TomSawyerLabs/mcu-hil/reference/v1-import/pcb-netlist.txt

== FOOTPRINTS ==
 |  |  | layer=Top Layer
   props: {'Reference': '', 'Value': '', 'Datasheet': '', 'Description': ''}
    =
 |  |  | layer=Top Layer
   props: {'Reference': '', 'Value': '', 'Datasheet': '', 'Description': ''}
    =
 |  |  | layer=Top Layer
   props: {'Reference': '', 'Value': '', 'Datasheet': '', 'Description': ''}
    =
 |  |  | layer=Top Layer
   props: {'Reference': '', 'Value': '', 'Datasheet': '', 'Description': ''}
    =
C1 | Capacitor 10 uF +/- 10% 16 V 0805 | Vault:CAPC2013X135X45NL10T25 | layer=Bottom Layer
   props: {'Reference': 'C1', 'Value': 'Capacitor 10 uF +/- 10% 16 V 0805', 'Datasheet': '', 'Description': ''}
    1=5V 2=GND
C2 | Capacitor 100 nF +/-10% 50 V 0603 | Vault:CAPC1608X90X40NL10T20 | layer=Bottom Layer
   props: {'Reference': 'C2', 'Value': 'Capacitor 100 nF +/-10% 50 V 0603', 'Datasheet': '', 'Description': ''}
    1=GND 2=VCC
C3 | Capacitor 100 nF +/-10% 50 V 0603 | Vault:CAPC1608X90X40NL10T20 | layer=Bottom Layer
   props: {'Reference': 'C3', 'Value': 'Capacitor 100 nF +/-10% 50 V 0603', 'Datasheet': '', 'Description': ''}
    1=GND 2=UVCC
C4 | Capacitor 1uF +/- 10% 16V 0603 | Vault:CAPC1608X90X35ML15T15 | layer=Bottom Layer
   props: {'Reference': 'C4', 'Value': 'Capacitor 1uF +/- 10% 16V 0603', 'Datasheet': '', 'Description': ''}
    1=NetC4_1 2=GND
C5 | Capacitor 12pF +/-10% 50V 0402 | Vault:CAPC0402(1005)33_L | layer=Bottom Layer
   props: {'Reference': 'C5', 'Value': 'Capacitor 12pF +/-10% 50V 0402', 'Datasheet': '', 'Description': ''}
    1=GND 2=NetC5_2
C6 | Capacitor 12pF +/-10% 50V 0402 | Vault:CAPC0402(1005)33_L | layer=Bottom Layer
   props: {'Reference': 'C6', 'Value': 'Capacitor 12pF +/-10% 50V 0402', 'Datasheet': '', 'Description': ''}
    1=GND 2=AVR Clock
C7 | Capacitor 100 nF +/-10% 50 V 0603 | Vault:CAPC1608X90X40NL10T20 | layer=Bottom Layer
   props: {'Reference': 'C7', 'Value': 'Capacitor 100 nF +/-10% 50 V 0603', 'Datasheet': '', 'Description': ''}
    1=GND 2=3V3
C8 | Capacitor 100 nF +/-10% 50 V 0603 | Vault:CAPC1608X90X40NL10T20 | layer=Bottom Layer
   props: {'Reference': 'C8', 'Value': 'Capacitor 100 nF +/-10% 50 V 0603', 'Datasheet': '', 'Description': ''}
    1=GND 2=3V3
C9 | Capacitor 100 nF +/-10% 50 V 0603 | Vault:CAPC1608X90X40NL10T20 | layer=Bottom Layer
   props: {'Reference': 'C9', 'Value': 'Capacitor 100 nF +/-10% 50 V 0603', 'Datasheet': '', 'Description': ''}
    1=GND 2=5V
D1 | LTST-C230KFKT | Vault:LEDC3216X110 | layer=Bottom Layer
   props: {'Reference': 'D1', 'Value': 'LTST-C230KFKT', 'Datasheet': '', 'Description': ''}
    A=3V3 C=NetD1_C
D2 | LTST-C230KFKT | Vault:LEDC3216X110 | layer=Bottom Layer
   props: {'Reference': 'D2', 'Value': 'LTST-C230KFKT', 'Datasheet': '', 'Description': ''}
    A=3V3 C=NetD2_C
D3 | LTST-C230KFKT | Vault:LEDC3216X110 | layer=Bottom Layer
   props: {'Reference': 'D3', 'Value': 'LTST-C230KFKT', 'Datasheet': '', 'Description': ''}
    A=GPIO26 C=NetD3_C
D4 | LTST-C230KFKT | Vault:LEDC3216X110 | layer=Bottom Layer
   props: {'Reference': 'D4', 'Value': 'LTST-C230KFKT', 'Datasheet': '', 'Description': ''}
    A=AVR Activity C=NetD4_C
J1 | Harwin M20-7832046 | PCB-677180-1:PCB-677180-1 | layer=Bottom Layer
   props: {'Reference': 'J1', 'Value': 'Harwin M20-7832046', 'Datasheet': '', 'Description': ''}
    1=3V3 2=5V 3=GPIO2 4=5V 5=GPIO3 6=GND 7=Clock Override 8=GPIO14 9=GND 10=GPIO15 11=Clock Override Enable 12=AVR USB Enable 13=AVR VCC Enable 14=GND 15=GPIO22 16=GPIO23 17=3V3 18=GPIO24 19=GPIO10 20=GND 21=GPIO9 22=GPIO25 23=GPIO11 24=GPIO8 25=GND 26=GPIO7 27=ID_SD 28=ID_SC 29=GPIO5 30=GND 31=GPIO6 32=GPIO12 33=GPIO13 34=GND 35=GPIO19 36=GPIO16 37=GPIO26 38=GPIO20 39=GND 40=GPIO21
J2 | PPPC022LFBN-RC | Vault:SULLINS_PPPC022LFBN-RC | layer=Bottom Layer
   props: {'Reference': 'J2', 'Value': 'PPPC022LFBN-RC', 'Datasheet': '', 'Description': ''}
    1= 2= 3= 4=
J3 | 2-1761605-1 | Vault:TE_2-1761605-1 | layer=Bottom Layer
   props: {'Reference': 'J3', 'Value': '2-1761605-1', 'Datasheet': '', 'Description': ''}
    1=Device_MISO 2=VCC 3=Device_SCLK 4=Device_MOSI 5=Reset 6=GND
J4 | 30306-6002HB | Vault:3M_30306-6002HB | layer=Top Layer
   props: {'Reference': 'J4', 'Value': '30306-6002HB', 'Datasheet': '', 'Description': ''}
    1=Device_MISO 2=VCC 3=Device_SCLK 4=Device_MOSI 5=Reset 6=GND
J5 | JUMPER | Vault:JUMPER | layer=Top Layer
   props: {'Reference': 'J5', 'Value': 'JUMPER', 'Datasheet': '', 'Description': ''}
    = = 1=NetJ5_1 2=3V3
J6A | USB4105-GF-A | Vault:USB4105_GCT | layer=Bottom Layer
   props: {'Reference': 'J6A', 'Value': 'USB4105-GF-A', 'Datasheet': '', 'Description': ''}
    = = = = = = = = = = 13= 14= 15= 16= A1-B12=GND A4-B9=5V A5=NetJ6A_A5 A6=DA_P A7=DA_N A8= B1-A12=GND B4-A9=5V B5=NetJ6A_B5 B6=DA_P B7=DA_N B8=
J6B | USB4105-GF-A | Vault:USB4105_GCT | layer=Bottom Layer
   props: {'Reference': 'J6B', 'Value': 'USB4105-GF-A', 'Datasheet': '', 'Description': ''}
    = = = = = = = = = = 13= 14= 15= 16= A1-B12=GND A4-B9=NetJ6B_A4-B9 A5=NetJ6B_A5 A6=DB_P A7=DB_N A8= B1-A12=GND B4-A9=NetJ6B_A4-B9 B5=NetJ6B_B5 B6=DB_P B7=DB_N B8=
J7 | 10118193-0001LF | Vault:AMPHENOL_10118193-0001LF | layer=Bottom Layer
   props: {'Reference': 'J7', 'Value': '10118193-0001LF', 'Datasheet': '', 'Description': ''}
    1=NetJ7_1 2=DB_N 3=DB_P 4= 5=GND S1=GND S2=GND S3=GND S4=GND S5=GND S6=GND
Q1 | 2N7002,215 | Vault:NXP-SOT23-3_V | layer=Bottom Layer
   props: {'Reference': 'Q1', 'Value': '2N7002,215', 'Datasheet': '', 'Description': ''}
    1=NetQ1_1 2=GND 3=Reset
Q2 | 2N7002,215 | Vault:NXP-SOT23-3_V | layer=Bottom Layer
   props: {'Reference': 'Q2', 'Value': '2N7002,215', 'Datasheet': '', 'Description': ''}
    1=GPIO13 2=GND 3=NetQ1_1
Q3A | CJ2305 | Vault:JSCJ-SOT23-3_V | layer=Bottom Layer
   props: {'Reference': 'Q3A', 'Value': 'CJ2305', 'Datasheet': '', 'Description': ''}
    1=NetQ3A_1 2=5V 3=VCC
Q3B | CJ2305 | Vault:JSCJ-SOT23-3_V | layer=Bottom Layer
   props: {'Reference': 'Q3B', 'Value': 'CJ2305', 'Datasheet': '', 'Description': ''}
    1=NetQ3B_1 2=5V 3=UVCC
Q4A | 2N7002,215 | Vault:NXP-SOT23-3_V | layer=Bottom Layer
   props: {'Reference': 'Q4A', 'Value': '2N7002,215', 'Datasheet': '', 'Description': ''}
    1=AVR VCC Enable 2=GND 3=NetQ3A_1
Q4B | 2N7002,215 | Vault:NXP-SOT23-3_V | layer=Bottom Layer
   props: {'Reference': 'Q4B', 'Value': '2N7002,215', 'Datasheet': '', 'Description': ''}
    1=AVR USB Enable 2=GND 3=NetQ3B_1
R1 | Resistor 22R +/-1% 0603 100 mW | Vault:RESC1609X50X30ML08T20 | layer=Bottom Layer
   props: {'Reference': 'R1', 'Value': 'Resistor 22R +/-1% 0603 100 mW', 'Datasheet': '', 'Description': ''}
    1=DB_N 2=A_N
R10 | Resistor 1k +/-1% 0603 100 mW | Vault:RESC1608X55X25ML10T15 | layer=Bottom Layer
   props: {'Reference': 'R10', 'Value': 'Resistor 1k +/-1% 0603 100 mW', 'Datasheet': '', 'Description': ''}
    1=GPIO15 2=NetR10_2
R11 | Resistor 120R +/-5 % 0603 0.1 W | Vault:RESC0603(1608)_L | layer=Bottom Layer
   props: {'Reference': 'R11', 'Value': 'Resistor 120R +/-5 % 0603 0.1 W', 'Datasheet': '', 'Description': ''}
    1=NetR11_1 2=AVR Rx
R12 | Resistor 1k +/-1% 0603 100 mW | Vault:RESC1608X55X25ML10T15 | layer=Bottom Layer
   props: {'Reference': 'R12', 'Value': 'Resistor 1k +/-1% 0603 100 mW', 'Datasheet': '', 'Description': ''}
    1=GPIO9 2=NetR12_2
R13 | Resistor 120R +/-5 % 0603 0.1 W | Vault:RESC0603(1608)_L | layer=Bottom Layer
   props: {'Reference': 'R13', 'Value': 'Resistor 120R +/-5 % 0603 0.1 W', 'Datasheet': '', 'Description': ''}
    1=NetR13_1 2=Device_MOSI
R14 | Resistor 120R +/-5 % 0603 0.1 W | Vault:RESC0603(1608)_L | layer=Bottom Layer
   props: {'Reference': 'R14', 'Value': 'Resistor 120R +/-5 % 0603 0.1 W', 'Datasheet': '', 'Description': ''}
    1=NetR14_1 2=Device_SCLK
R15 | Resistor 1k +/-1% 0603 100 mW | Vault:RESC1608X55X25ML10T15 | layer=Bottom Layer
   props: {'Reference': 'R15', 'Value': 'Resistor 1k +/-1% 0603 100 mW', 'Datasheet': '', 'Description': ''}
    1=NetQ1_1 2=5V
R16 | Resistor 1k +/-1% 0603 100 mW | Vault:RESC1608X55X25ML10T15 | layer=Bottom Layer
   props: {'Reference': 'R16', 'Value': 'Resistor 1k +/-1% 0603 100 mW', 'Datasheet': '', 'Description': ''}
    1=Reset 2=5V
R17 | Resistor 1k +/-1% 0603 100 mW | Vault:RESC1608X55X25ML10T15 | layer=Bottom Layer
   props: {'Reference': 'R17', 'Value': 'Resistor 1k +/-1% 0603 100 mW', 'Datasheet': '', 'Description': ''}
    1=NetQ1_1 2=NetD1_C
R18 | Resistor 1k +/-1% 0603 100 mW | Vault:RESC1608X55X25ML10T15 | layer=Bottom Layer
   props: {'Reference': 'R18', 'Value': 'Resistor 1k +/-1% 0603 100 mW', 'Datasheet': '', 'Description': ''}
    1=Reset 2=NetD2_C
R19 | Resistor 1k +/-1% 0603 100 mW | Vault:RESC1608X55X25ML10T15 | layer=Bottom Layer
   props: {'Reference': 'R19', 'Value': 'Resistor 1k +/-1% 0603 100 mW', 'Datasheet': '', 'Description': ''}
    1=GPIO2 2=GPIO3
R2 | Resistor 22R +/-1% 0603 100 mW | Vault:RESC1609X50X30ML08T20 | layer=Bottom Layer
   props: {'Reference': 'R2', 'Value': 'Resistor 22R +/-1% 0603 100 mW', 'Datasheet': '', 'Description': ''}
    1=DB_P 2=A_P
R20 | Resistor 1k +/-1% 0603 100 mW | Vault:RESC1608X55X25ML10T15 | layer=Bottom Layer
   props: {'Reference': 'R20', 'Value': 'Resistor 1k +/-1% 0603 100 mW', 'Datasheet': '', 'Description': ''}
    1=HWB 2=GPIO2
R21 | Resistor 1k +/-1% 0603 100 mW | Vault:RESC1608X55X25ML10T15 | layer=Bottom Layer
   props: {'Reference': 'R21', 'Value': 'Resistor 1k +/-1% 0603 100 mW', 'Datasheet': '', 'Description': ''}
    1=GND 2=GPIO19
R22 | Resistor 1k +/-1% 0603 100 mW | Vault:RESC1608X55X25ML10T15 | layer=Bottom Layer
   props: {'Reference': 'R22', 'Value': 'Resistor 1k +/-1% 0603 100 mW', 'Datasheet': '', 'Description': ''}
    1=GPIO13 2=GPIO19
R23 | Resistor 1k +/-1% 0603 100 mW | Vault:RESC1608X55X25ML10T15 | layer=Bottom Layer
   props: {'Reference': 'R23', 'Value': 'Resistor 1k +/-1% 0603 100 mW', 'Datasheet': '', 'Description': ''}
    1=GND 2=NetD3_C
R24 | Resistor 1k +/-1% 0603 100 mW | Vault:RESC1608X55X25ML10T15 | layer=Bottom Layer
   props: {'Reference': 'R24', 'Value': 'Resistor 1k +/-1% 0603 100 mW', 'Datasheet': '', 'Description': ''}
    1=GND 2=NetD4_C
R25A | Resistor 1k +/-1% 0603 100 mW | Vault:RESC1608X55X25ML10T15 | layer=Bottom Layer
   props: {'Reference': 'R25A', 'Value': 'Resistor 1k +/-1% 0603 100 mW', 'Datasheet': '', 'Description': ''}
    1=NetQ3A_1 2=5V
R25B | Resistor 1k +/-1% 0603 100 mW | Vault:RESC1608X55X25ML10T15 | layer=Bottom Layer
   props: {'Reference': 'R25B', 'Value': 'Resistor 1k +/-1% 0603 100 mW', 'Datasheet': '', 'Description': ''}
    1=NetQ3B_1 2=5V
R26A | Resistor 1k +/-1% 0603 100 mW | Vault:RESC1608X55X25ML10T15 | layer=Bottom Layer
   props: {'Reference': 'R26A', 'Value': 'Resistor 1k +/-1% 0603 100 mW', 'Datasheet': '', 'Description': ''}
    1=GND 2=VCC
R26B | Resistor 1k +/-1% 0603 100 mW | Vault:RESC1608X55X25ML10T15 | layer=Bottom Layer
   props: {'Reference': 'R26B', 'Value': 'Resistor 1k +/-1% 0603 100 mW', 'Datasheet': '', 'Description': ''}
    1=GND 2=UVCC
R27A | Resistor 1k +/-1% 0603 100 mW | Vault:RESC1608X55X25ML10T15 | layer=Bottom Layer
   props: {'Reference': 'R27A', 'Value': 'Resistor 1k +/-1% 0603 100 mW', 'Datasheet': '', 'Description': ''}
    1=GND 2=AVR VCC Enable
R27B | Resistor 1k +/-1% 0603 100 mW | Vault:RESC1608X55X25ML10T15 | layer=Bottom Layer
   props: {'Reference': 'R27B', 'Value': 'Resistor 1k +/-1% 0603 100 mW', 'Datasheet': '', 'Description': ''}
    1=GND 2=AVR USB Enable
R28 | Resistor 1k +/-1% 0603 100 mW | Vault:RESC1608X55X25ML10T15 | layer=Bottom Layer
   props: {'Reference': 'R28', 'Value': 'Resistor 1k +/-1% 0603 100 mW', 'Datasheet': '', 'Description': ''}
    1=GND 2=Clock Override Enable
R29 | Resistor 1k +/-1% 0603 100 mW | Vault:RESC1608X55X25ML10T15 | layer=Bottom Layer
   props: {'Reference': 'R29', 'Value': 'Resistor 1k +/-1% 0603 100 mW', 'Datasheet': '', 'Description': ''}
    1=GND 2=NetJ6A_B5
R3 | Resistor 1k +/-1% 0603 100 mW | Vault:RESC1608X55X25ML10T15 | layer=Bottom Layer
   props: {'Reference': 'R3', 'Value': 'Resistor 1k +/-1% 0603 100 mW', 'Datasheet': '', 'Description': ''}
    1=NetC5_2 2=NetR3_2
R30 | Resistor 1k +/-1% 0603 100 mW | Vault:RESC1608X55X25ML10T15 | layer=Bottom Layer
   props: {'Reference': 'R30', 'Value': 'Resistor 1k +/-1% 0603 100 mW', 'Datasheet': '', 'Description': ''}
    1=GND 2=NetJ6A_A5
R4 | Resistor 1k +/-1% 0603 100 mW | Vault:RESC1608X55X25ML10T15 | layer=Bottom Layer
   props: {'Reference': 'R4', 'Value': 'Resistor 1k +/-1% 0603 100 mW', 'Datasheet': '', 'Description': ''}
    1=ID_SD 2=3V3
R5 | Resistor 1k +/-1% 0603 100 mW | Vault:RESC1608X55X25ML10T15 | layer=Bottom Layer
   props: {'Reference': 'R5', 'Value': 'Resistor 1k +/-1% 0603 100 mW', 'Datasheet': '', 'Description': ''}
    1=ID_SC 2=3V3
R6 | Resistor 1k +/-1% 0603 100 mW | Vault:RESC1608X55X25ML10T15 | layer=Bottom Layer
   props: {'Reference': 'R6', 'Value': 'Resistor 1k +/-1% 0603 100 mW', 'Datasheet': '', 'Description': ''}
    1=GPIO5 2=3V3
R7 | Resistor 1k +/-1% 0603 100 mW | Vault:RESC1608X55X25ML10T15 | layer=Bottom Layer
   props: {'Reference': 'R7', 'Value': 'Resistor 1k +/-1% 0603 100 mW', 'Datasheet': '', 'Description': ''}
    1=GPIO8 2=3V3
R8 | Resistor 1k +/-1% 0603 100 mW | Vault:RESC1608X55X25ML10T15 | layer=Bottom Layer
   props: {'Reference': 'R8', 'Value': 'Resistor 1k +/-1% 0603 100 mW', 'Datasheet': '', 'Description': ''}
    1=AVR Tx 2=3V3
R9 | Resistor 1k +/-1% 0603 100 mW | Vault:RESC1608X55X25ML10T15 | layer=Bottom Layer
   props: {'Reference': 'R9', 'Value': 'Resistor 1k +/-1% 0603 100 mW', 'Datasheet': '', 'Description': ''}
    1=GPIO14 2=3V3
U1 | ATMEGA16U2-AU | Vault:QFP80P900X900X120-32N | layer=Bottom Layer
   props: {'Reference': 'U1', 'Value': 'ATMEGA16U2-AU', 'Datasheet': '', 'Description': ''}
    1=AVR Clock 2=NetR3_2 3=GND 4=VCC 5= 6= 7= 8=AVR Rx 9=AVR Tx 10= 11= 12= 13=HWB 14= 15=Device_SCLK 16=Device_MOSI 17=Device_MISO 18= 19= 20= 21= 22=AVR Activity 23= 24=Reset 25= 26= 27=NetC4_1 28=GND 29=A_P 30=A_N 31=UVCC 32=VCC
U2 | CAT24C32WI-GT3 | Vault:ONSC-SOIC-8-751BD-01_M | layer=Bottom Layer
   props: {'Reference': 'U2', 'Value': 'CAT24C32WI-GT3', 'Datasheet': '', 'Description': ''}
    1=GND 2=GND 3=GND 4=GND 5=ID_SD 6=ID_SC 7=NetJ5_1 8=3V3
U3 | 74LVC244APW,118 | Vault:SOP65P640X110-20N | layer=Bottom Layer
   props: {'Reference': 'U3', 'Value': '74LVC244APW,118', 'Datasheet': '', 'Description': ''}
    1=GPIO8 2=GND 3=NetR12_2 4=GND 5=NetR13_1 6=AVR Tx 7=NetR14_1 8=GPIO14 9= 10=GND 11=GND 12=NetR11_1 13=GPIO11 14=NetR10_2 15=GPIO10 16= 17=Device_MISO 18= 19=GPIO5 20=3V3
U4 | 74AHCT1G126SE-7 | Vault:SOT65P210X110-5N | layer=Bottom Layer
   props: {'Reference': 'U4', 'Value': '74AHCT1G126SE-7', 'Datasheet': '', 'Description': ''}
    1=Clock Override Enable 2=Clock Override 3=GND 4=AVR Clock 5=5V
X1 | ABM3B-16.000MHZ-B2-T | Vault:ABRA-ABM3B-4_V | layer=Bottom Layer
   props: {'Reference': 'X1', 'Value': 'ABM3B-16.000MHZ-B2-T', 'Datasheet': '', 'Description': ''}
    1=NetC5_2 2=GND 3=AVR Clock 4=GND
== NETS ==
3V3 : C7.2 C8.2 D1.A D2.A J1.1 J1.17 J5.2 R4.2 R5.2 R6.2 R7.2 R8.2 R9.2 U2.8 U3.20
5V : C1.1 C9.2 J1.2 J1.4 J6A.A4-B9 J6A.B4-A9 Q3A.2 Q3B.2 R15.2 R16.2 R25A.2 R25B.2 U4.5
AVR Activity : D4.A U1.22
AVR Clock : C6.2 U1.1 U4.4 X1.3
AVR Rx : R11.2 U1.8
AVR Tx : R8.1 U1.9 U3.6
AVR USB Enable : J1.12 Q4B.1 R27B.2
AVR VCC Enable : J1.13 Q4A.1 R27A.2
A_N : R1.2 U1.30
A_P : R2.2 U1.29
Clock Override : J1.7 U4.2
Clock Override Enable : J1.11 R28.2 U4.1
DA_N : J6A.A7 J6A.B7
DA_P : J6A.A6 J6A.B6
DB_N : J6B.A7 J6B.B7 J7.2 R1.1
DB_P : J6B.A6 J6B.B6 J7.3 R2.1
Device_MISO : J3.1 J4.1 U1.17 U3.17
Device_MOSI : J3.4 J4.4 R13.2 U1.16
Device_SCLK : J3.3 J4.3 R14.2 U1.15
GND : C1.2 C2.1 C3.1 C4.2 C5.1 C6.1 C7.1 C8.1 C9.1 J1.14 J1.20 J1.25 J1.30 J1.34 J1.39 J1.6 J1.9 J3.6 J4.6 J6A.A1-B12 J6A.B1-A12 J6B.A1-B12 J6B.B1-A12 J7.5 J7.S1 J7.S2 J7.S3 J7.S4 J7.S5 J7.S6 Q1.2 Q2.2 Q4A.2 Q4B.2 R21.1 R23.1 R24.1 R26A.1 R26B.1 R27A.1 R27B.1 R28.1 R29.1 R30.1 U1.28 U1.3 U2.1 U2.2 U2.3 U2.4 U3.10 U3.11 U3.2 U3.4 U4.3 X1.2 X1.4
GPIO10 : J1.19 U3.15
GPIO11 : J1.23 U3.13
GPIO12 : J1.32
GPIO13 : J1.33 Q2.1 R22.1
GPIO14 : J1.8 R9.1 U3.8
GPIO15 : J1.10 R10.1
GPIO16 : J1.36
GPIO19 : J1.35 R21.2 R22.2
GPIO2 : J1.3 R19.1 R20.2
GPIO20 : J1.38
GPIO21 : J1.40
GPIO22 : J1.15
GPIO23 : J1.16
GPIO24 : J1.18
GPIO25 : J1.22
GPIO26 : D3.A J1.37
GPIO3 : J1.5 R19.2
GPIO5 : J1.29 R6.1 U3.19
GPIO6 : J1.31
GPIO7 : J1.26
GPIO8 : J1.24 R7.1 U3.1
GPIO9 : J1.21 R12.1
HWB : R20.1 U1.13
ID_SC : J1.28 R5.1 U2.6
ID_SD : J1.27 R4.1 U2.5
NetC4_1 : C4.1 U1.27
NetC5_2 : C5.2 R3.1 X1.1
NetD1_C : D1.C R17.2
NetD2_C : D2.C R18.2
NetD3_C : D3.C R23.2
NetD4_C : D4.C R24.2
NetJ5_1 : J5.1 U2.7
NetJ6A_A5 : J6A.A5 R30.2
NetJ6A_B5 : J6A.B5 R29.2
NetJ6B_A4-B9 : J6B.A4-B9 J6B.B4-A9
NetJ6B_A5 : J6B.A5
NetJ6B_B5 : J6B.B5
NetJ7_1 : J7.1
NetQ1_1 : Q1.1 Q2.3 R15.1 R17.1
NetQ3A_1 : Q3A.1 Q4A.3 R25A.1
NetQ3B_1 : Q3B.1 Q4B.3 R25B.1
NetR10_2 : R10.2 U3.14
NetR11_1 : R11.1 U3.12
NetR12_2 : R12.2 U3.3
NetR13_1 : R13.1 U3.5
NetR14_1 : R14.1 U3.7
NetR3_2 : R3.2 U1.2
Reset : J3.5 J4.5 Q1.3 R16.1 R18.1 U1.24
UVCC : C3.2 Q3B.3 R26B.2 U1.31
VCC : C2.2 J3.2 J4.2 Q3A.3 R26A.2 U1.32 U1.4
board bbox mm: 65.05 56.05
copper layers: 2
