TomSawyerLabs/mcu-hil/docs/v1-images/pcb-top.png

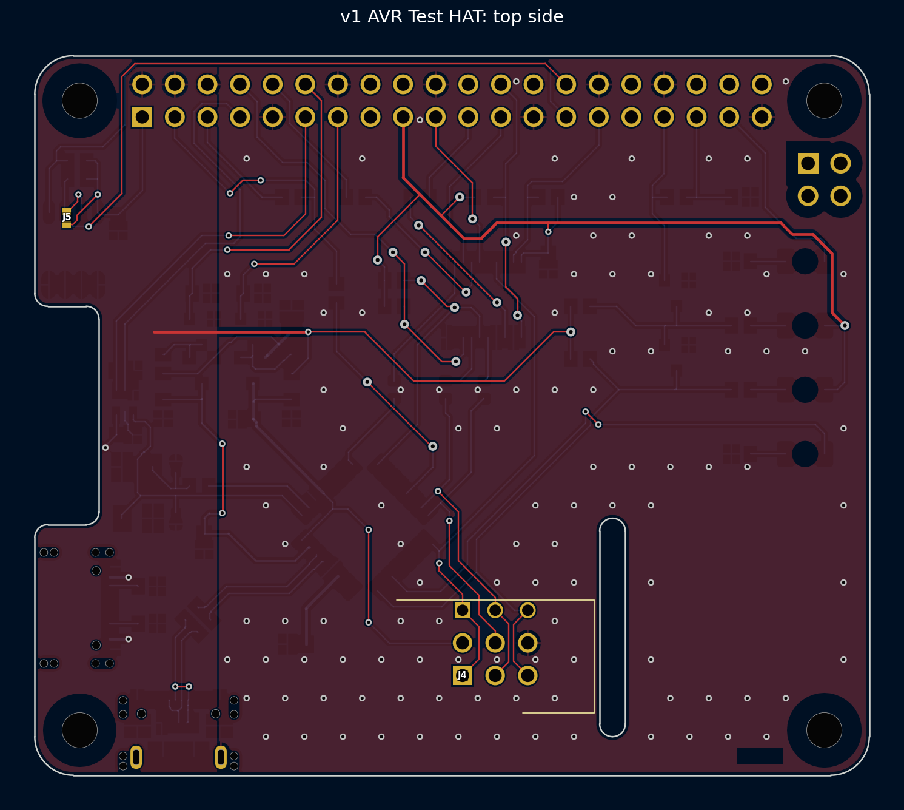
docs/v1-images/pcb-top.png
