TomSawyerLabs/mcu-hil/docs/v1-images/sch-AVR.png

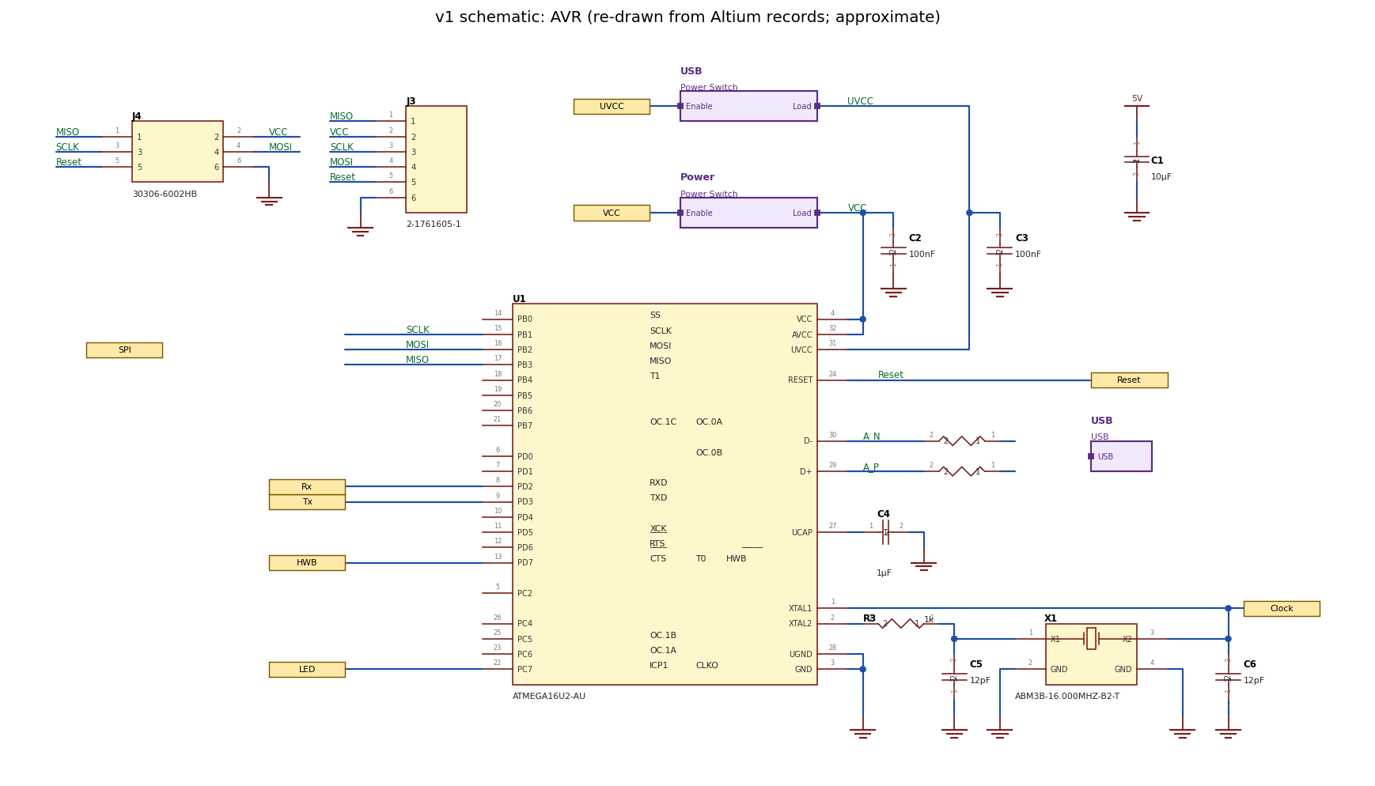
docs/v1-images/sch-AVR.png
