TomSawyerLabs/mcu-hil/docs/v1-images/sch-Clock-Buffer.png

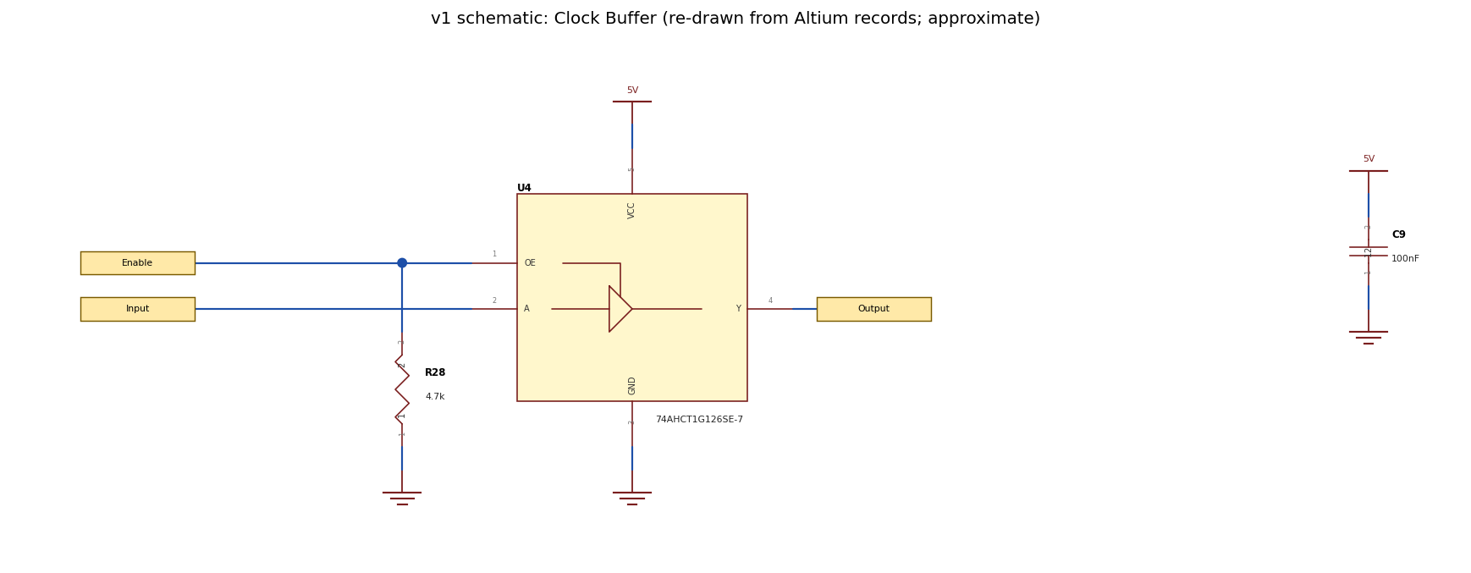
docs/v1-images/sch-Clock-Buffer.png
