TomSawyerLabs/mcu-hil/docs/v1-images/sch-EEPROM.png

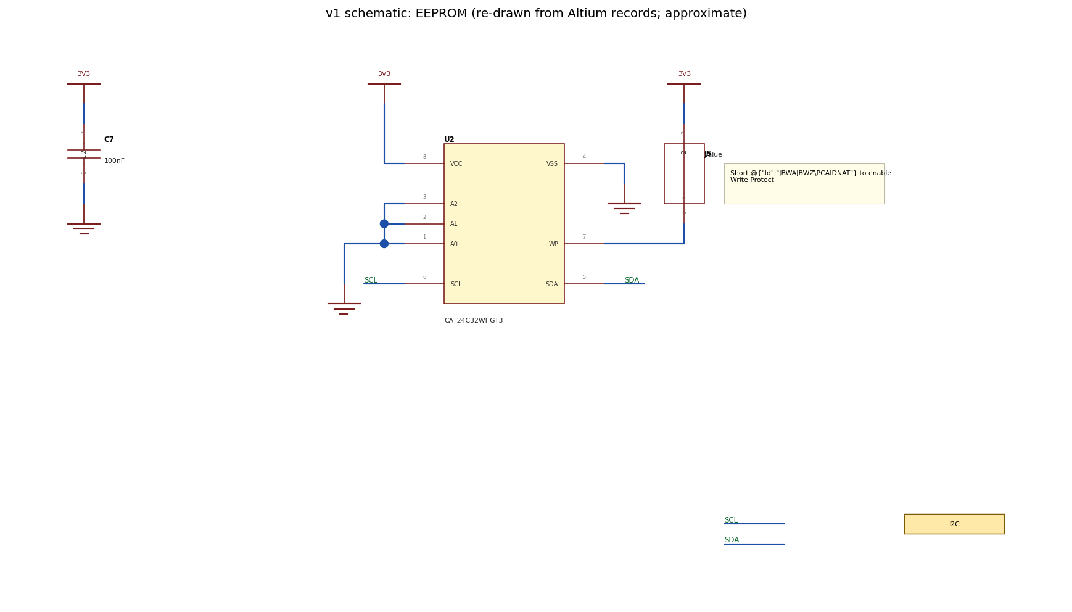
docs/v1-images/sch-EEPROM.png
