TomSawyerLabs/mcu-hil/docs/v1-images/sch-I2C-PullUps.png

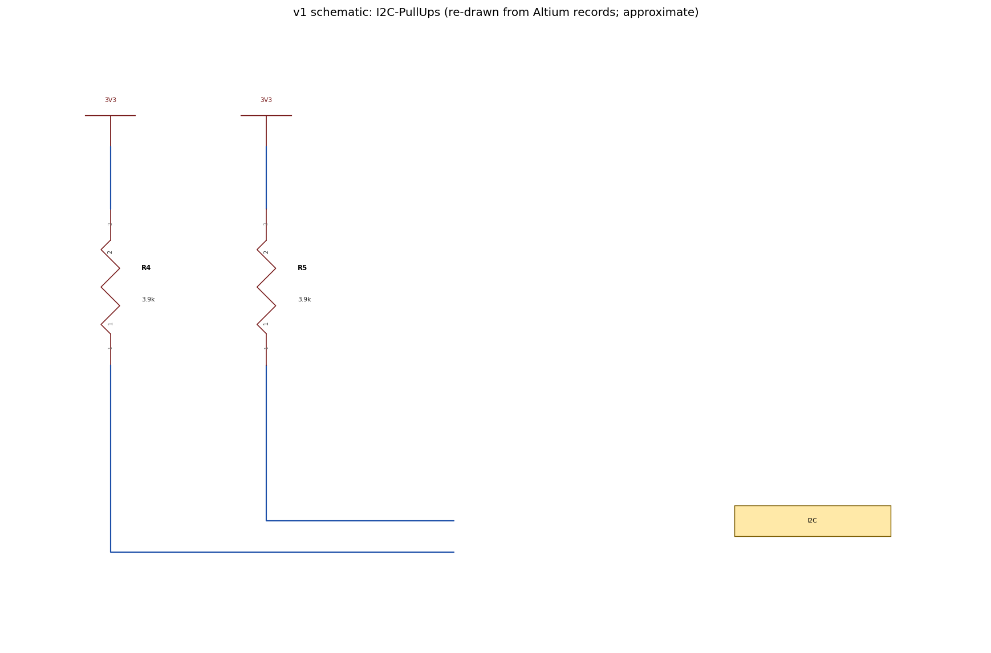
docs/v1-images/sch-I2C-PullUps.png
