TomSawyerLabs/mcu-hil/docs/v1-images/sch-Logic-Buffer.png

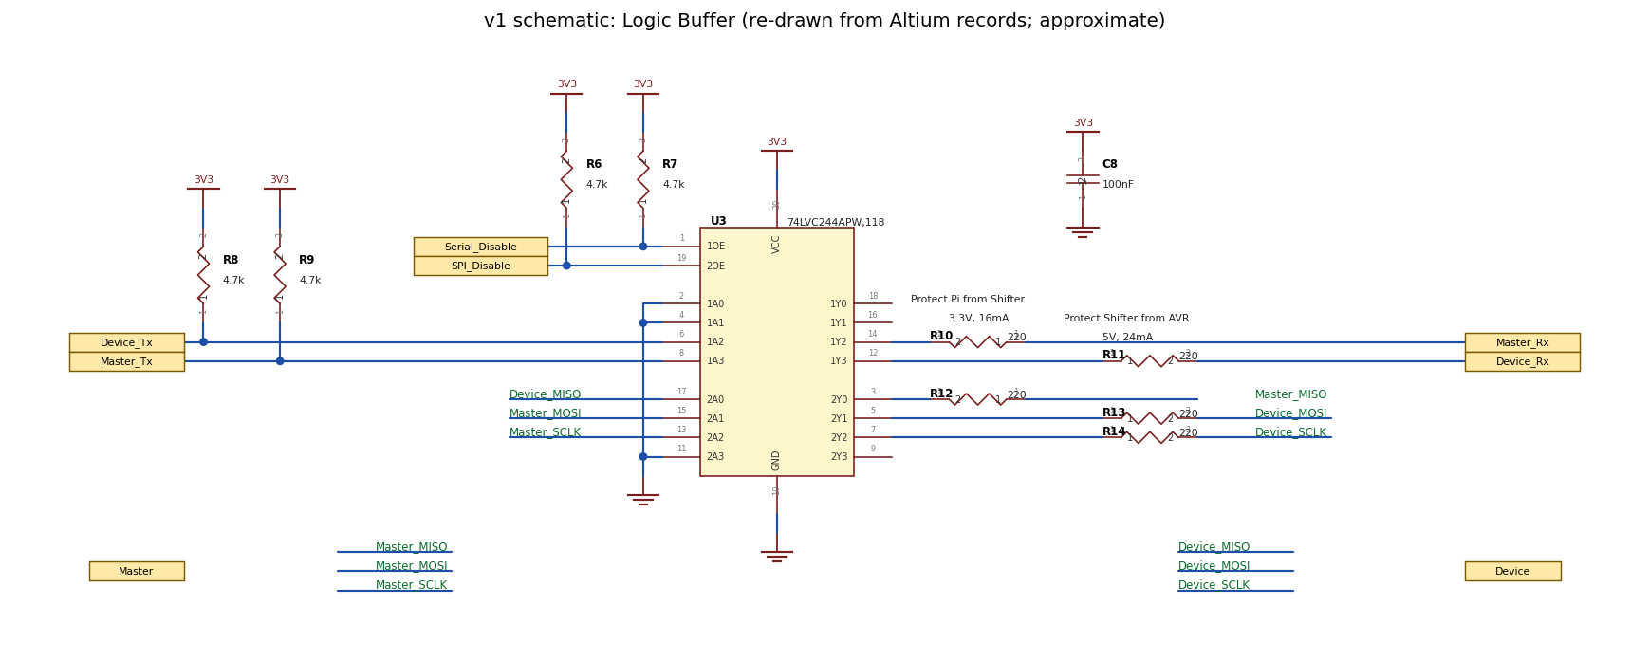
docs/v1-images/sch-Logic-Buffer.png
