TomSawyerLabs/mcu-hil/docs/v1-images/sch-microUSB.png

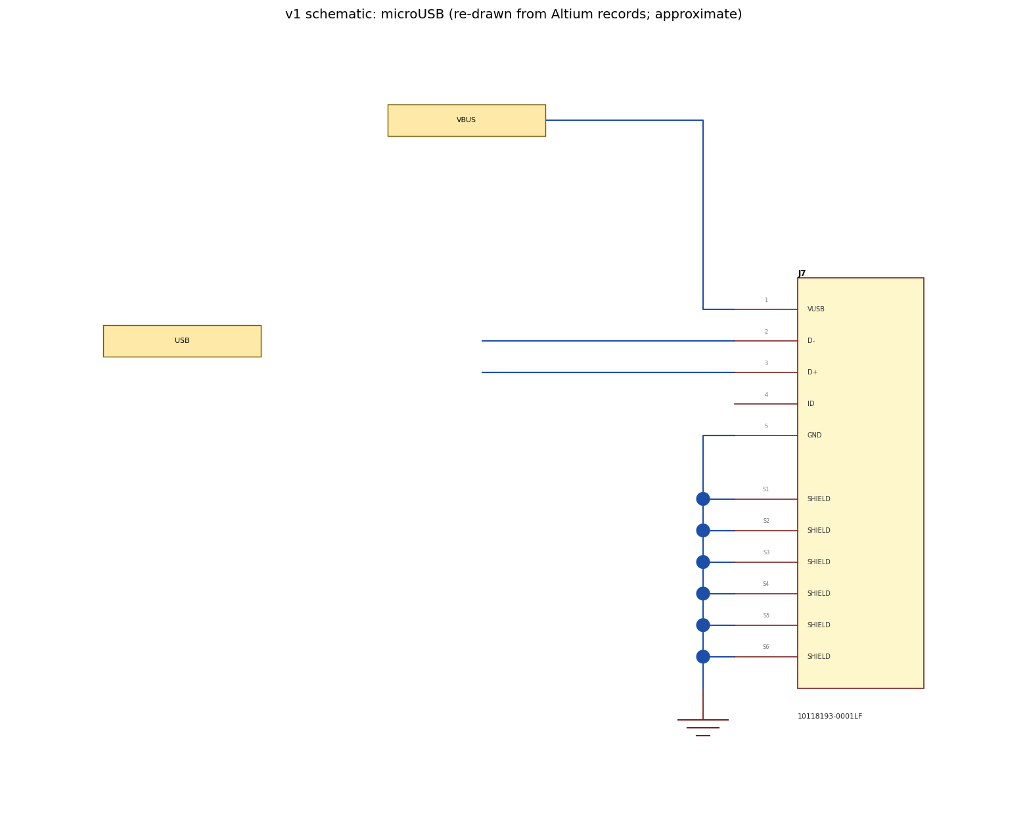
docs/v1-images/sch-microUSB.png
