TomSawyerLabs/mcu-hil/docs/v1-images/sch-Power-Switch.png

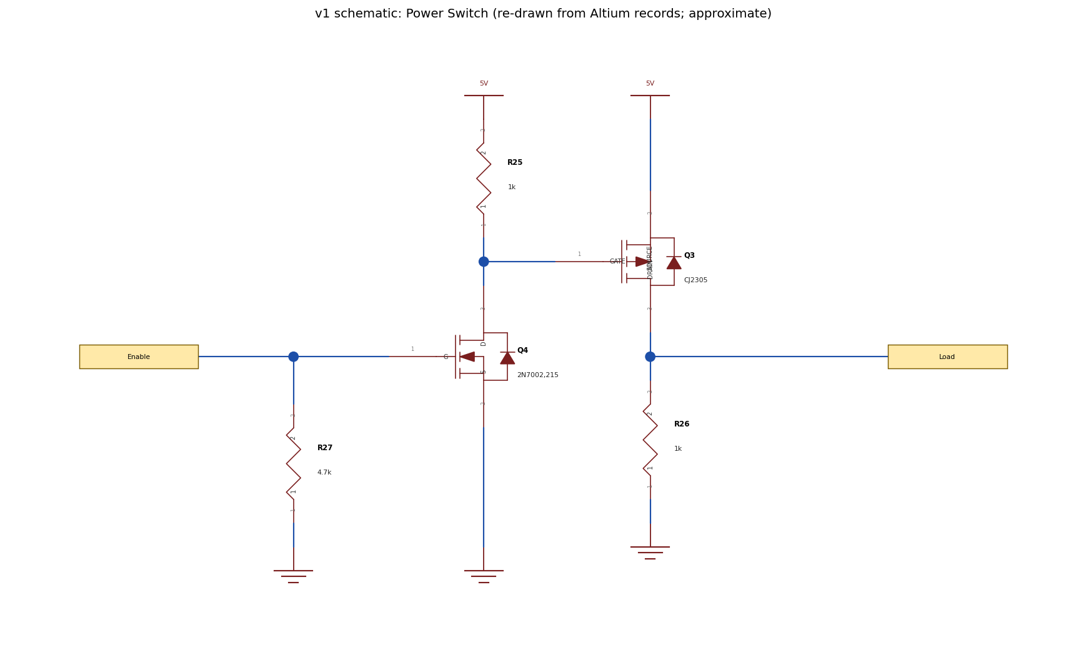
docs/v1-images/sch-Power-Switch.png
