TomSawyerLabs/mcu-hil/docs/v1-images/sch-Reset.png

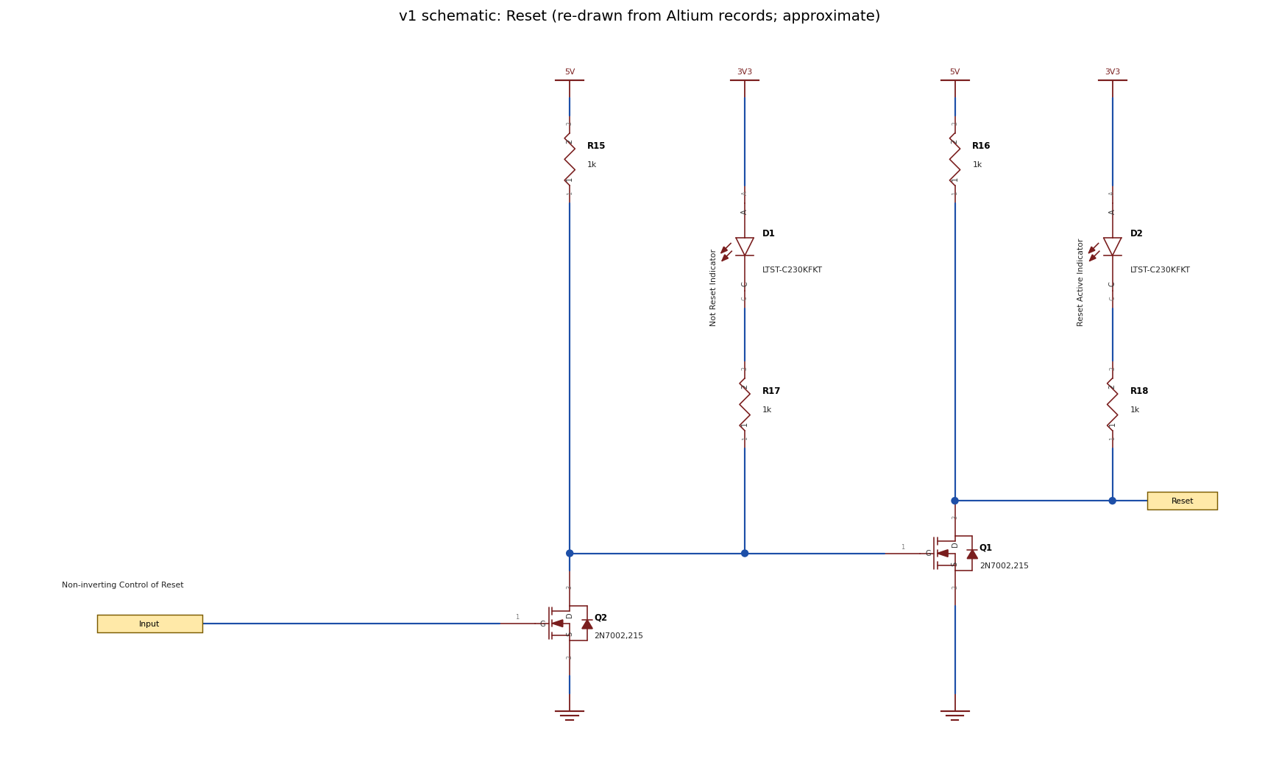
docs/v1-images/sch-Reset.png
