TomSawyerLabs/mcu-hil/docs/v1-images/sch-RPi-HAT_Conn-EE.png

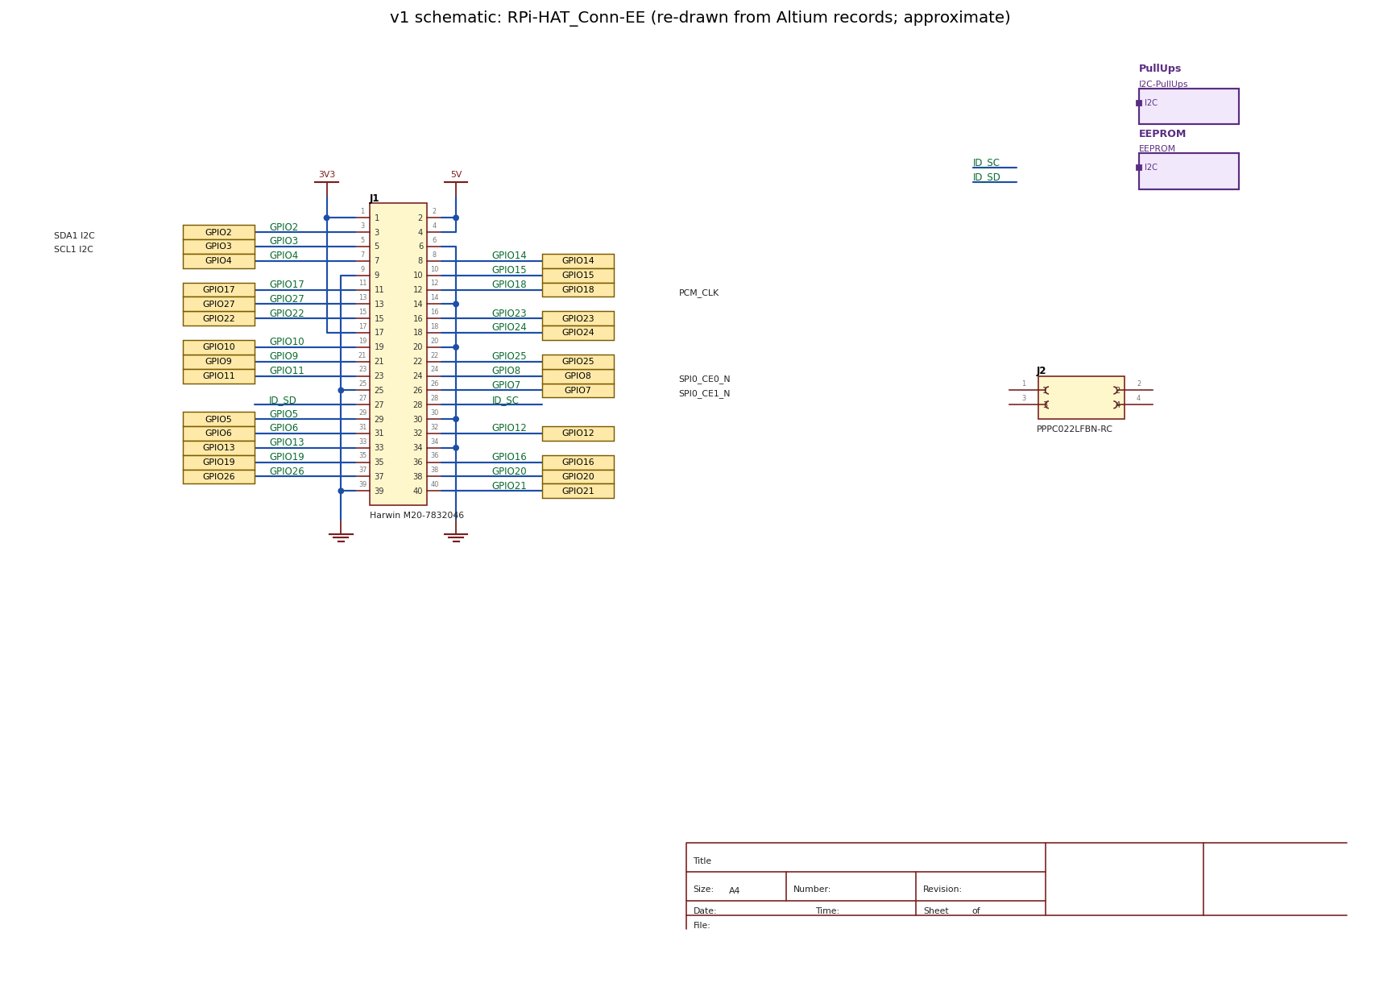
docs/v1-images/sch-RPi-HAT_Conn-EE.png
