TomSawyerLabs/mcu-hil/docs/v1-images/sch-USB-C.png

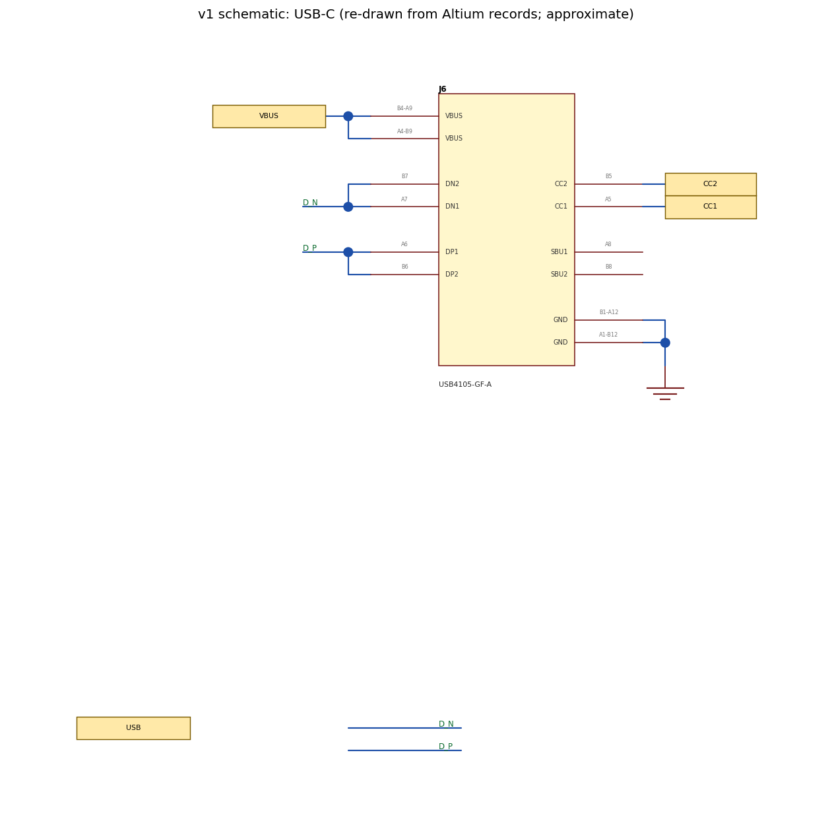
docs/v1-images/sch-USB-C.png
