TomSawyerLabs/mcu-hil/docs/v1-images/sch-USB.png

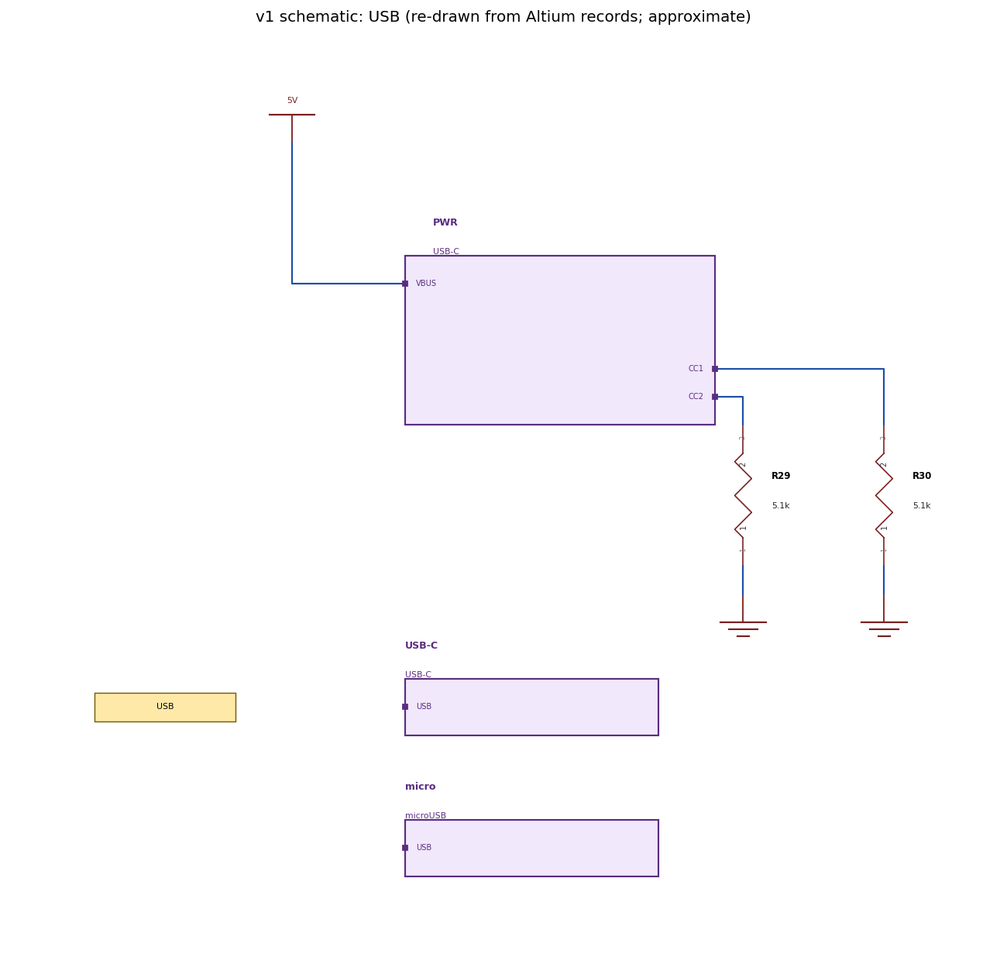
docs/v1-images/sch-USB.png
