TomSawyerLabs/mcu-hil/hw/carrier/mcu-hil-carrier.pdf

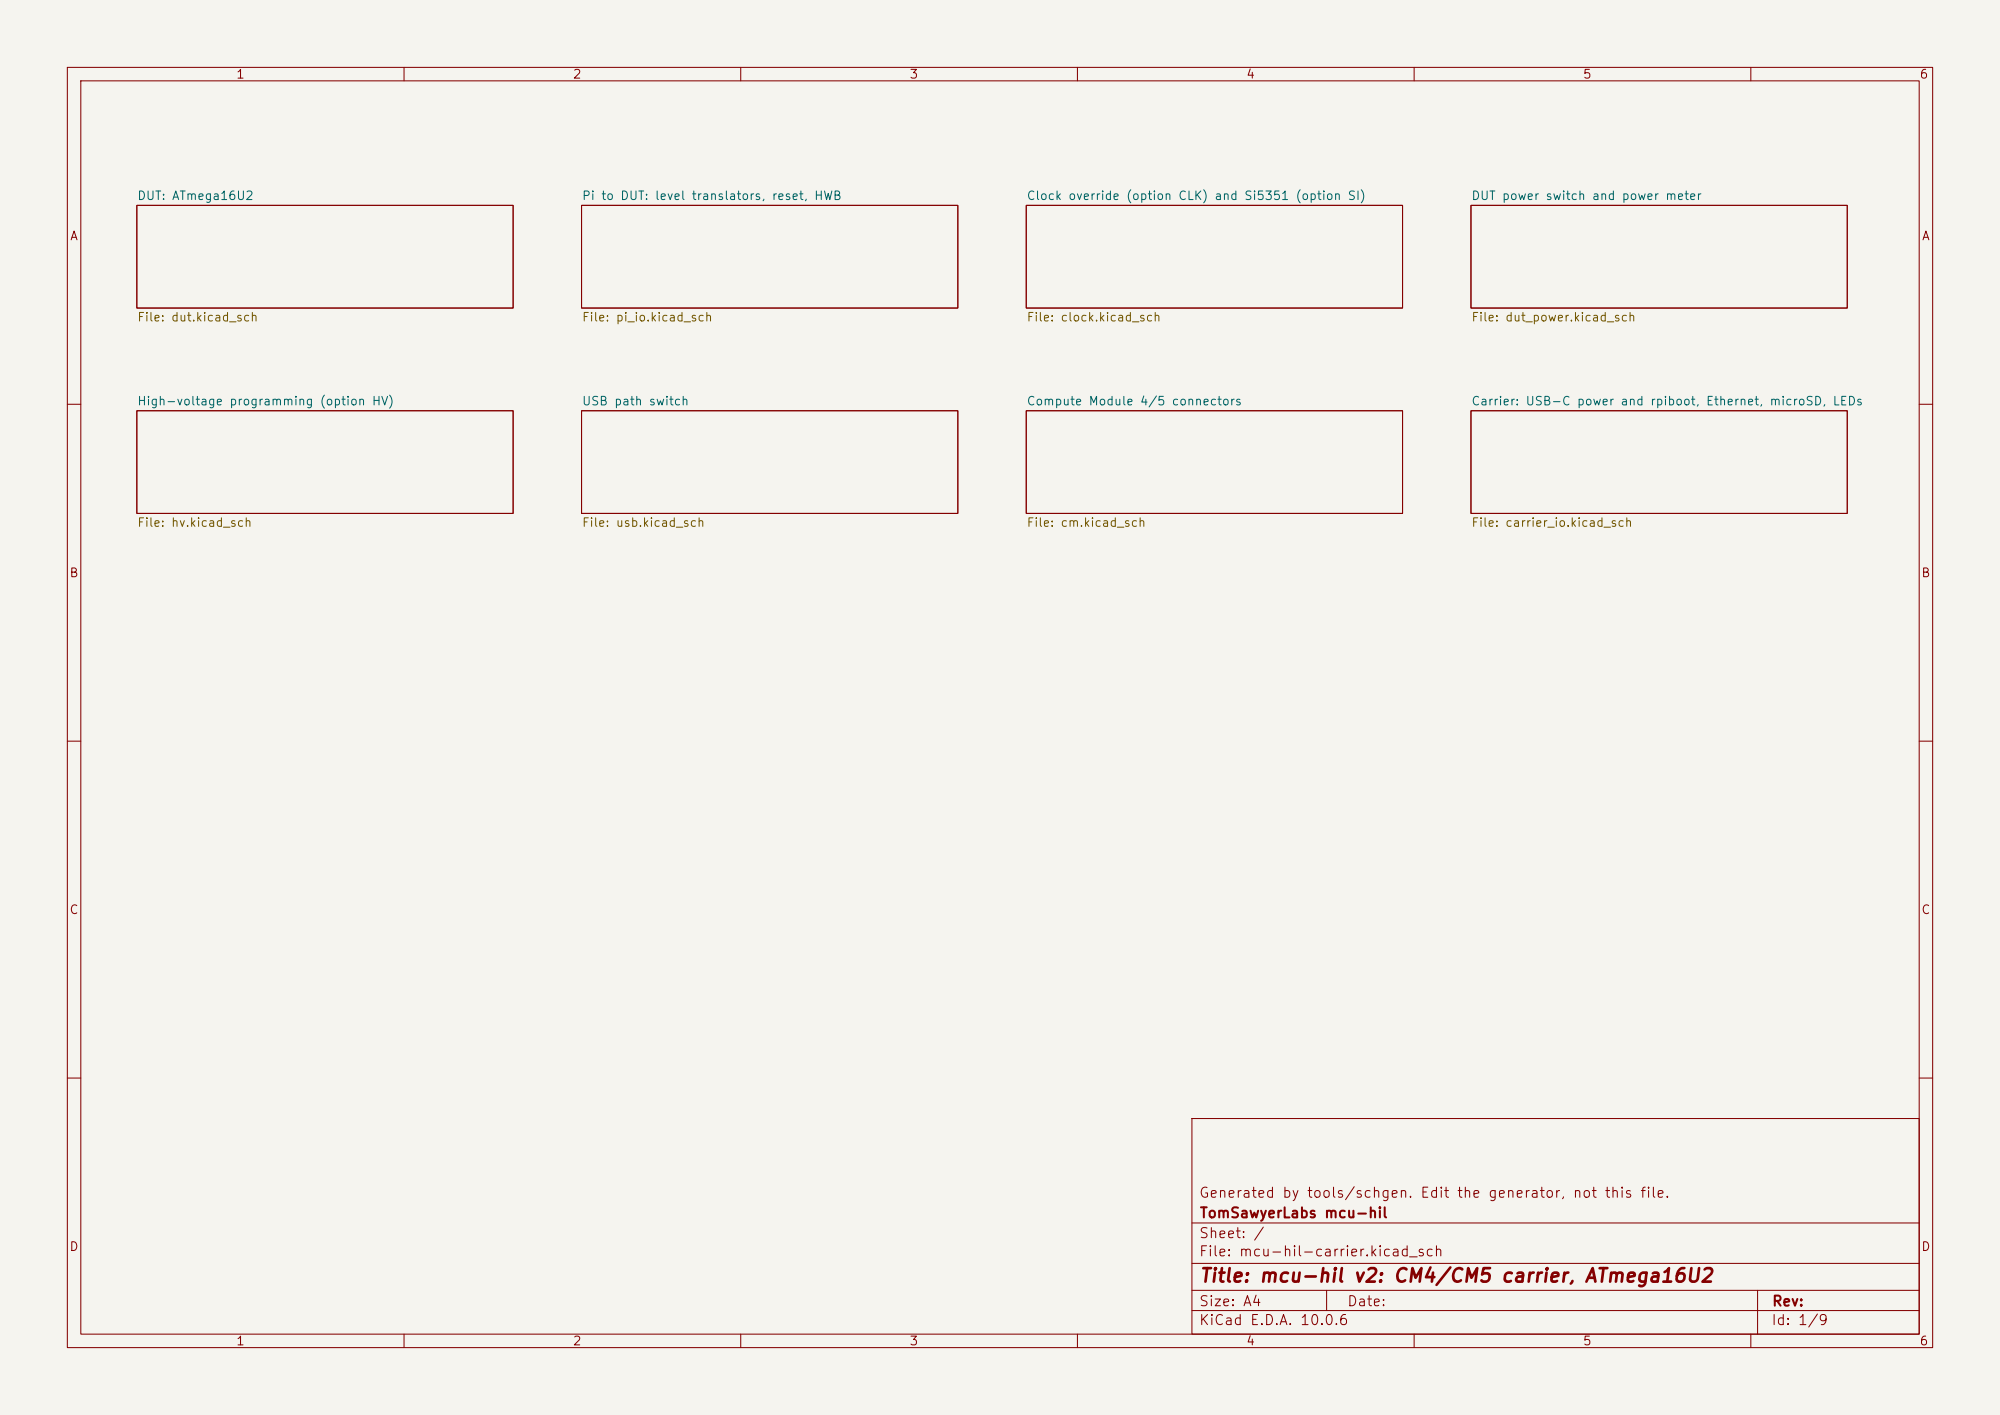
[picture p15: page 1]

Generated by tools/schgen. Edit the generator, not this file.
TomSawyerLabs mcu-hil
Sheet: /
File: mcu-hil-carrier.kicad_sch
Title: mcu-hil v2: CM4/CM5 carrier, ATmega16U2

Size: A4 | Rev:
KiCad E.D.A. 10.0.6 | Id: 1/9

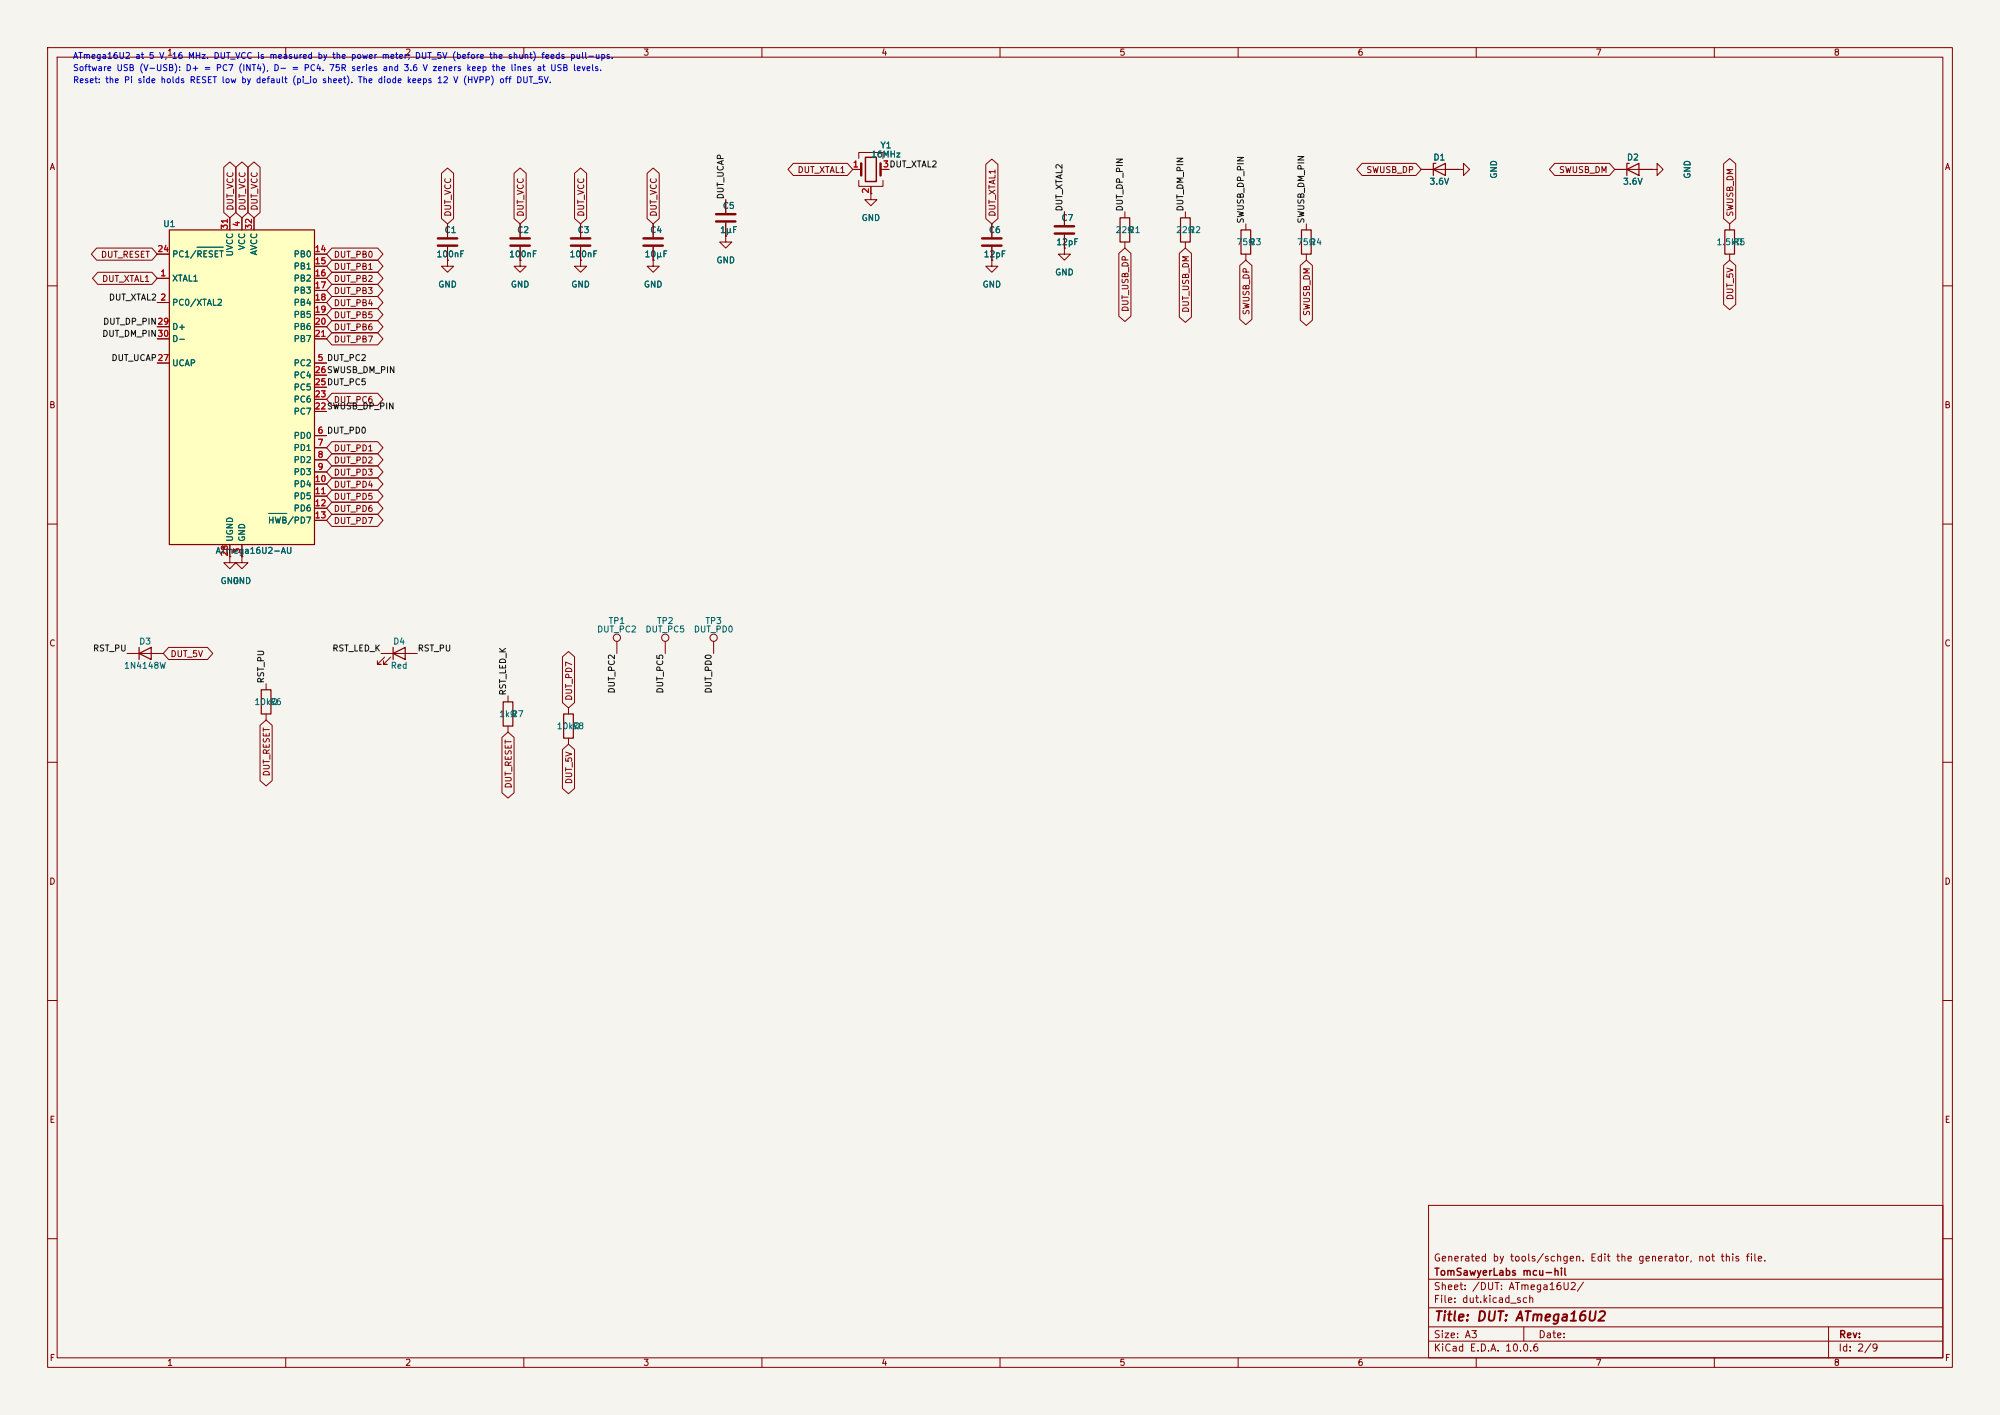
[picture p16: page 2]

4 PC2 5 PD0 6 PD1 7 PD2 8 PD3 9 PD4 10 PD5 11 PD6 12 HWB/PD7 13 PB0 14 PB1 15 PB2 16 PB3 17 PB4 18 PB5 19 PB6 20 PB7 21 PC7 22 PC6 23 PC1/RESET 24 PC5 25 PC4 26 UCAP 27 UGND 28 D+ 29 D- 30 UVCC 31 AVCC U1 32
10µF GND U1

4 PC2 5 PD0 6 PD1 7 PD2 8 PD3 9 PD4 10 PD5 11 PD6 12 HWB/PD7 13 PB0 14 PB1 15 PB2 16 PB3 17 PB4 18 PB5 19 PB6 20 PB7 21 PC7 22 PC6 23 PC1/RESET 24 PC5 25 PC4 26 UCAP 27 UGND 28 D+ 29 D- 30 UVCC 31 AVCC 32

Generated by tools/schgen. Edit the generator, not this file.
TomSawyerLabs mcu-hil
Sheet: /DUT: ATmega16U2/
File: dut.kicad_sch
Title: DUT: ATmega16U2

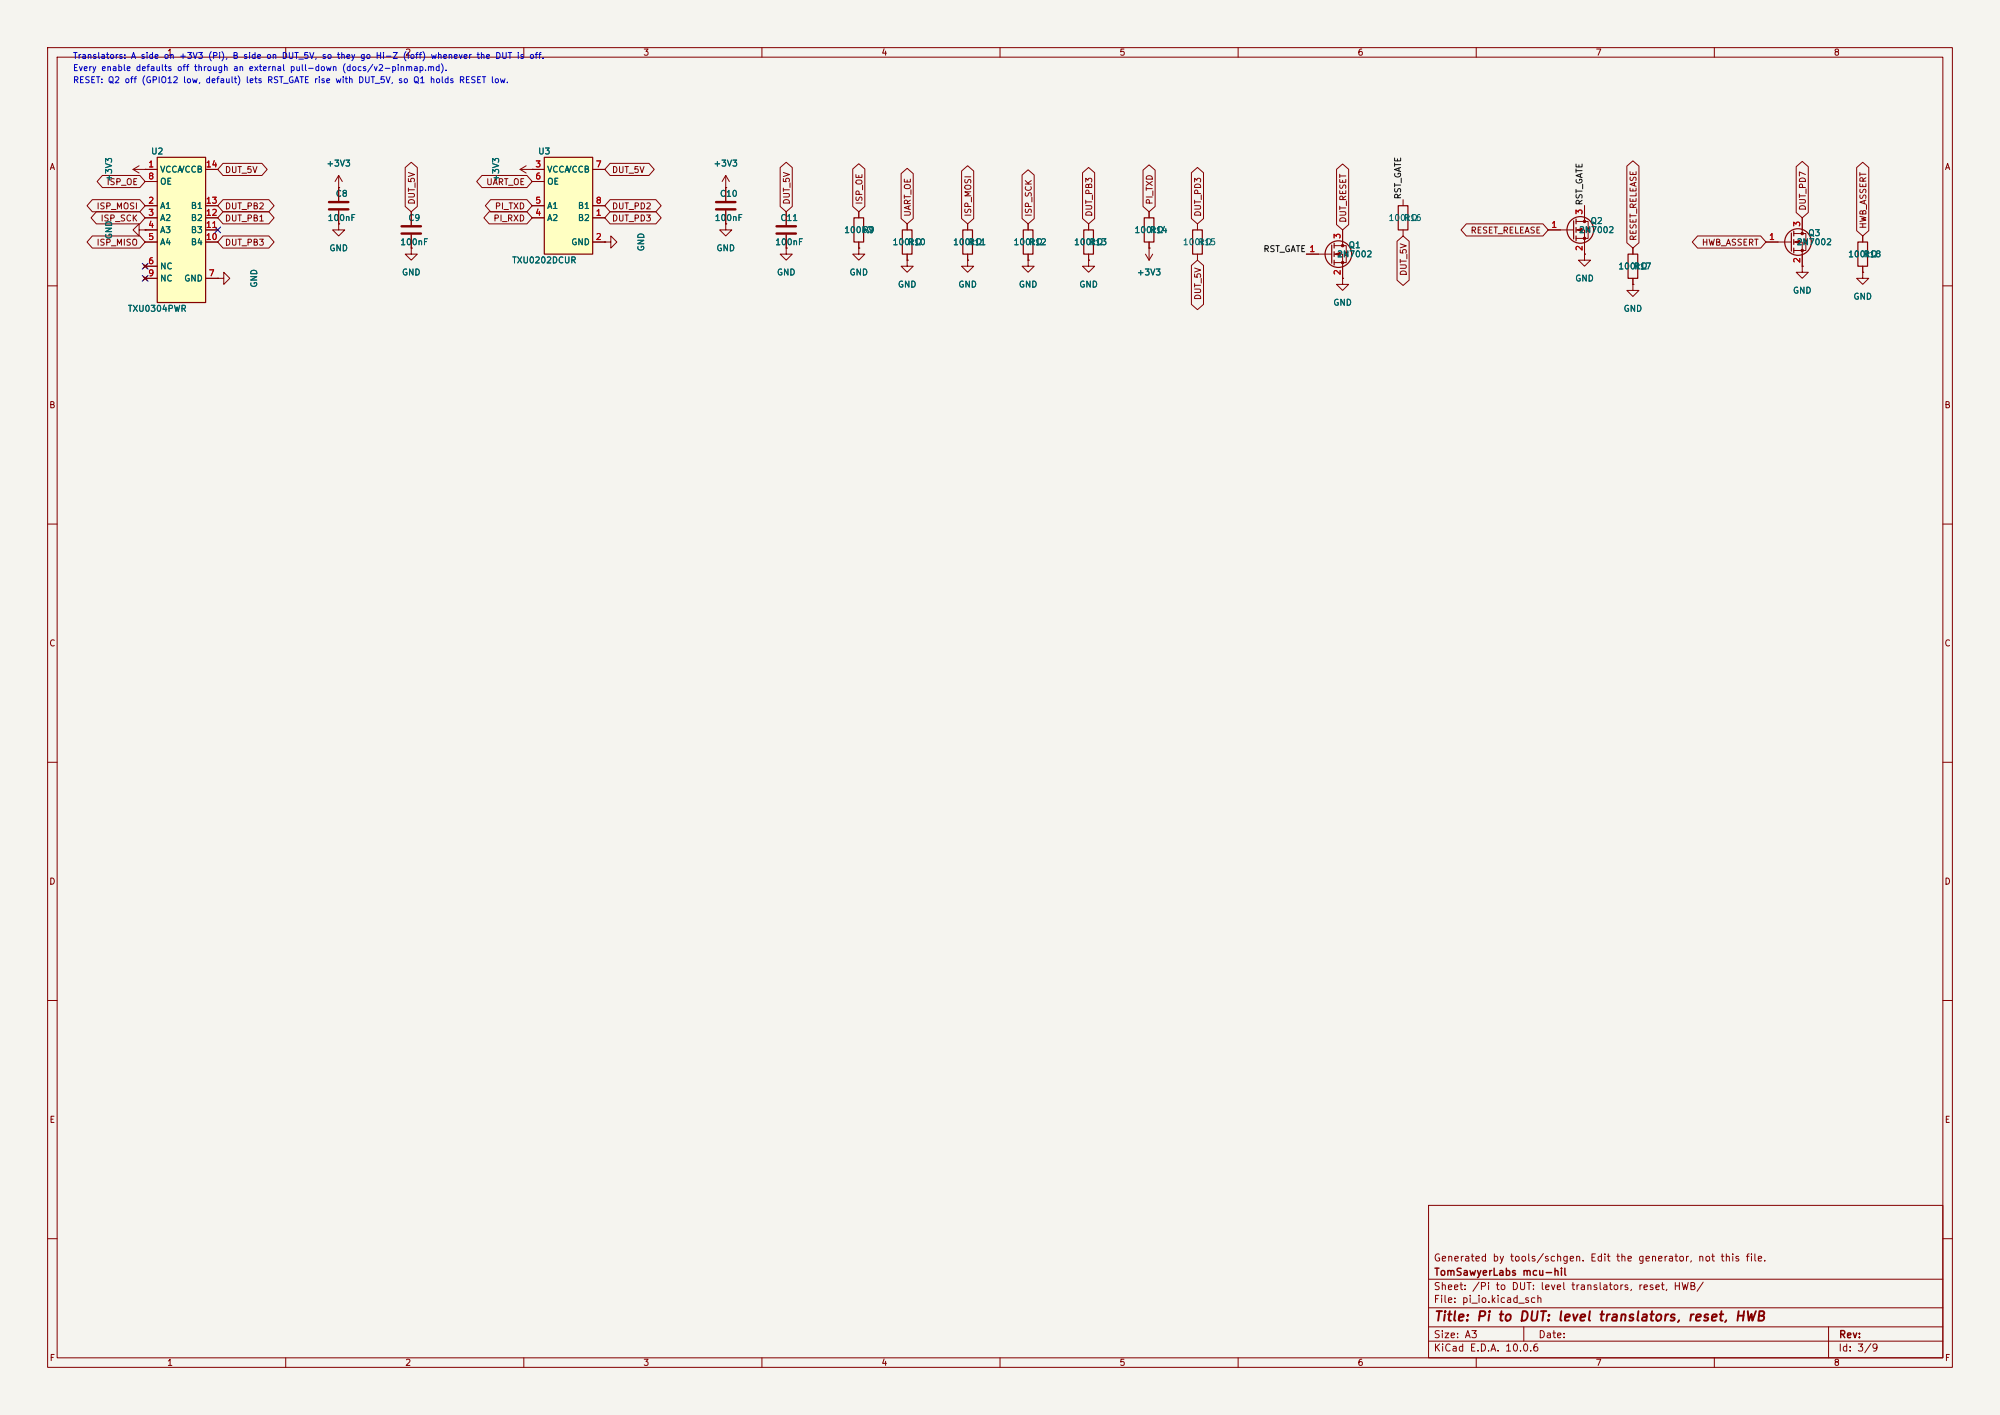
[picture p17: page 3]

Generated by tools/schgen. Edit the generator, not this file.
TomSawyerLabs mcu-hil
Sheet: /Pi to DUT: level translators, reset, HWB/
File: pi_io.kicad_sch
Title: Pi to DUT: level translators, reset, HWB

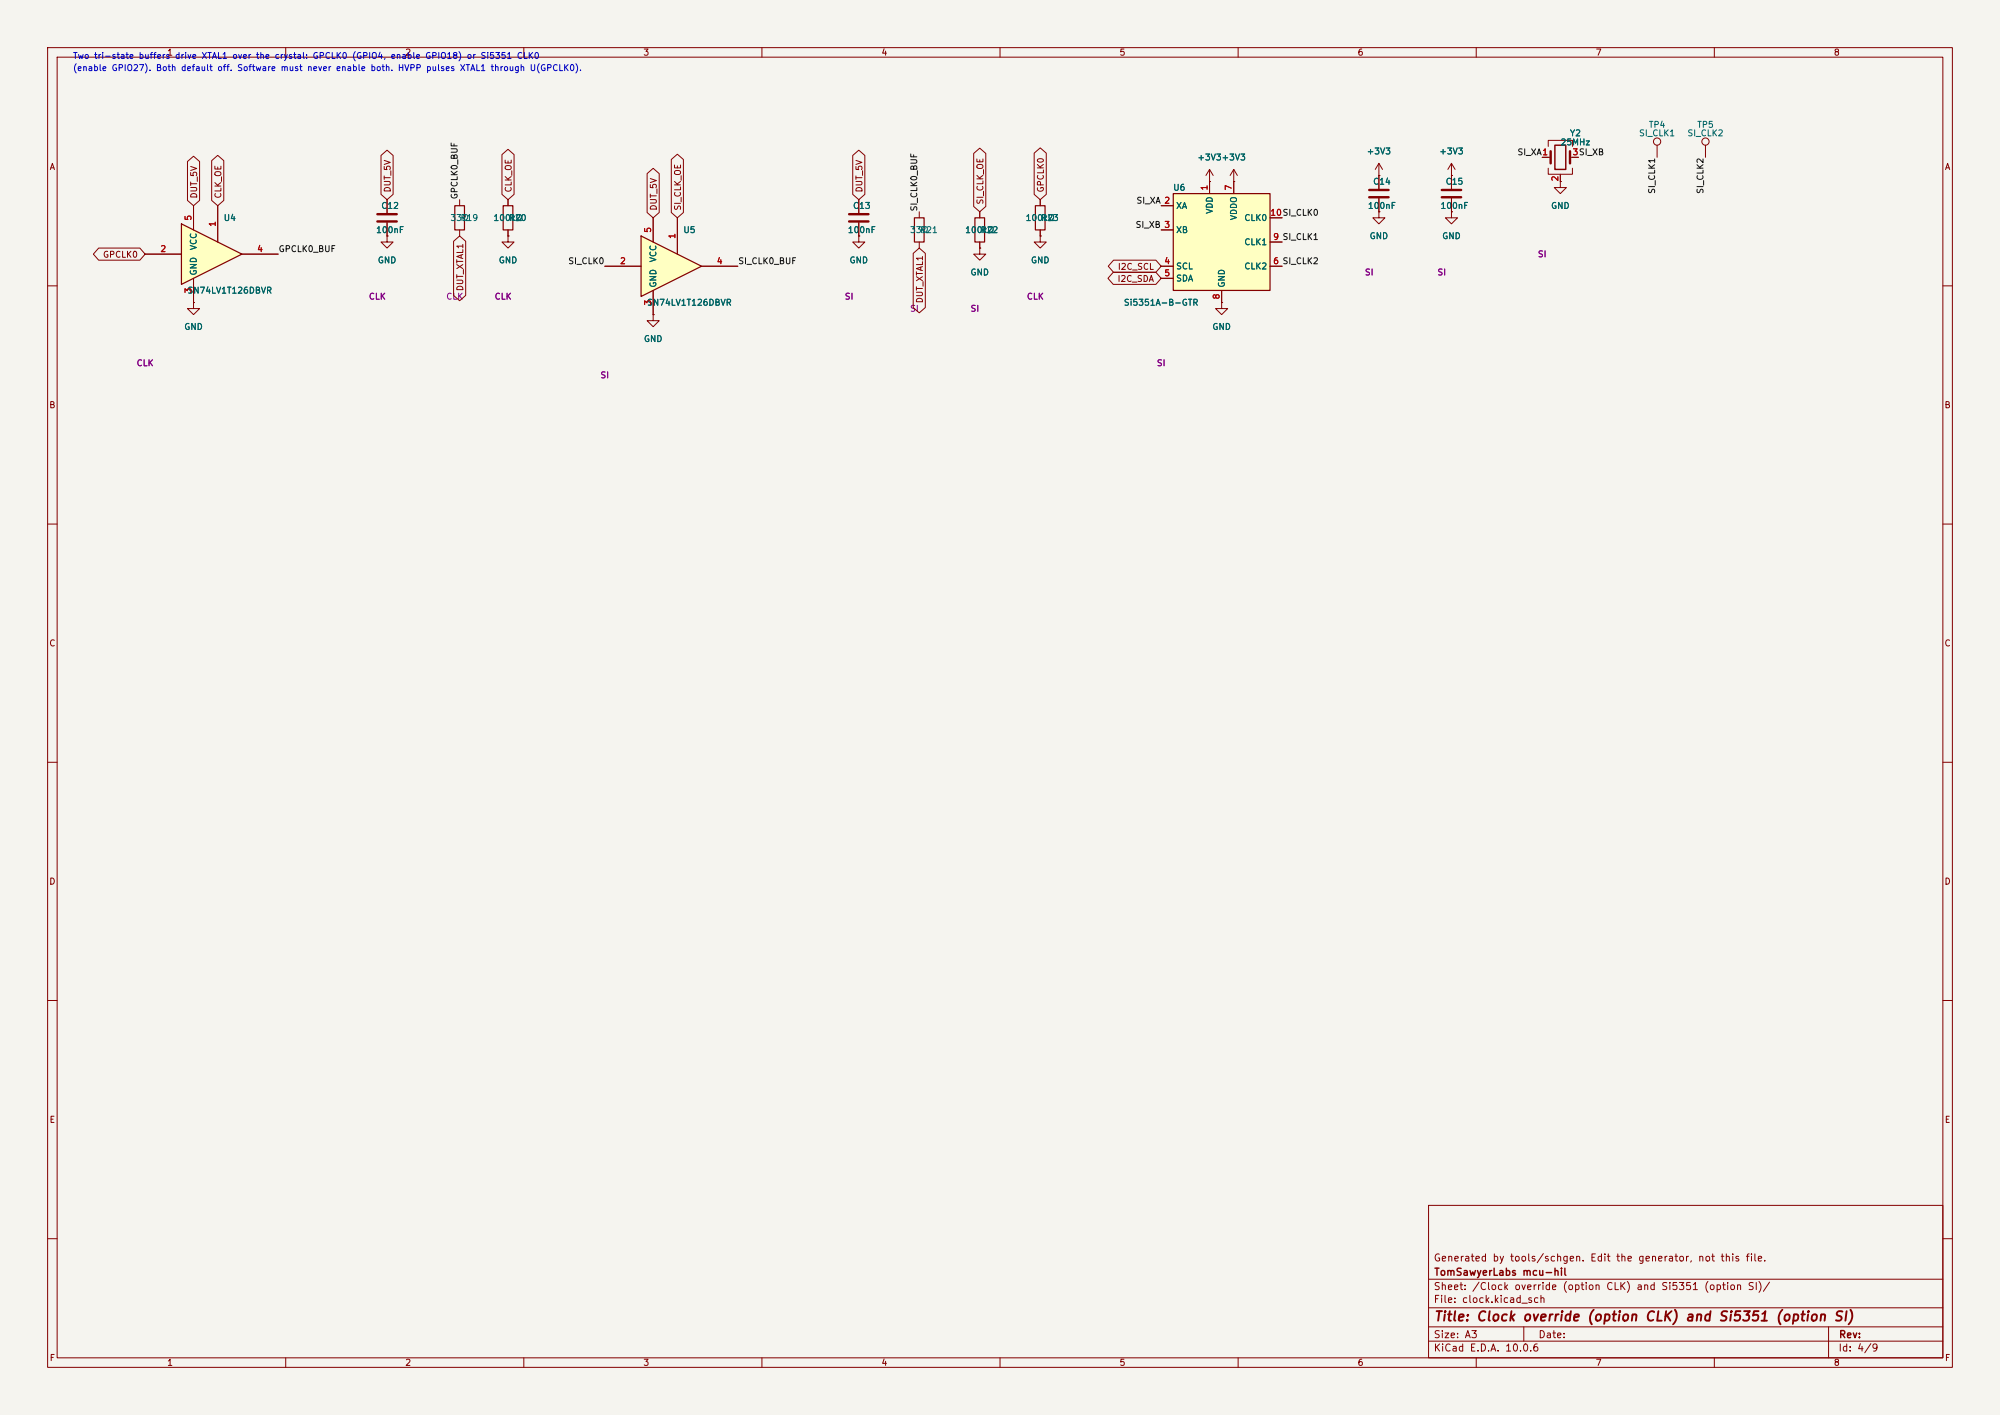
[picture p18: page 4]

Two tri-state buffers drive XTAL1 over the crystal: GPCLK0 (GPIO4, enable GPIO18) or Si5351 CLK0

Generated by tools/schgen. Edit the generator, not this file.
TomSawyerLabs mcu-hil
Sheet: /Clock override (option CLK) and Si5351 (option SI)/
File: clock.kicad_sch
Title: Clock override (option CLK) and Si5351 (option SI)

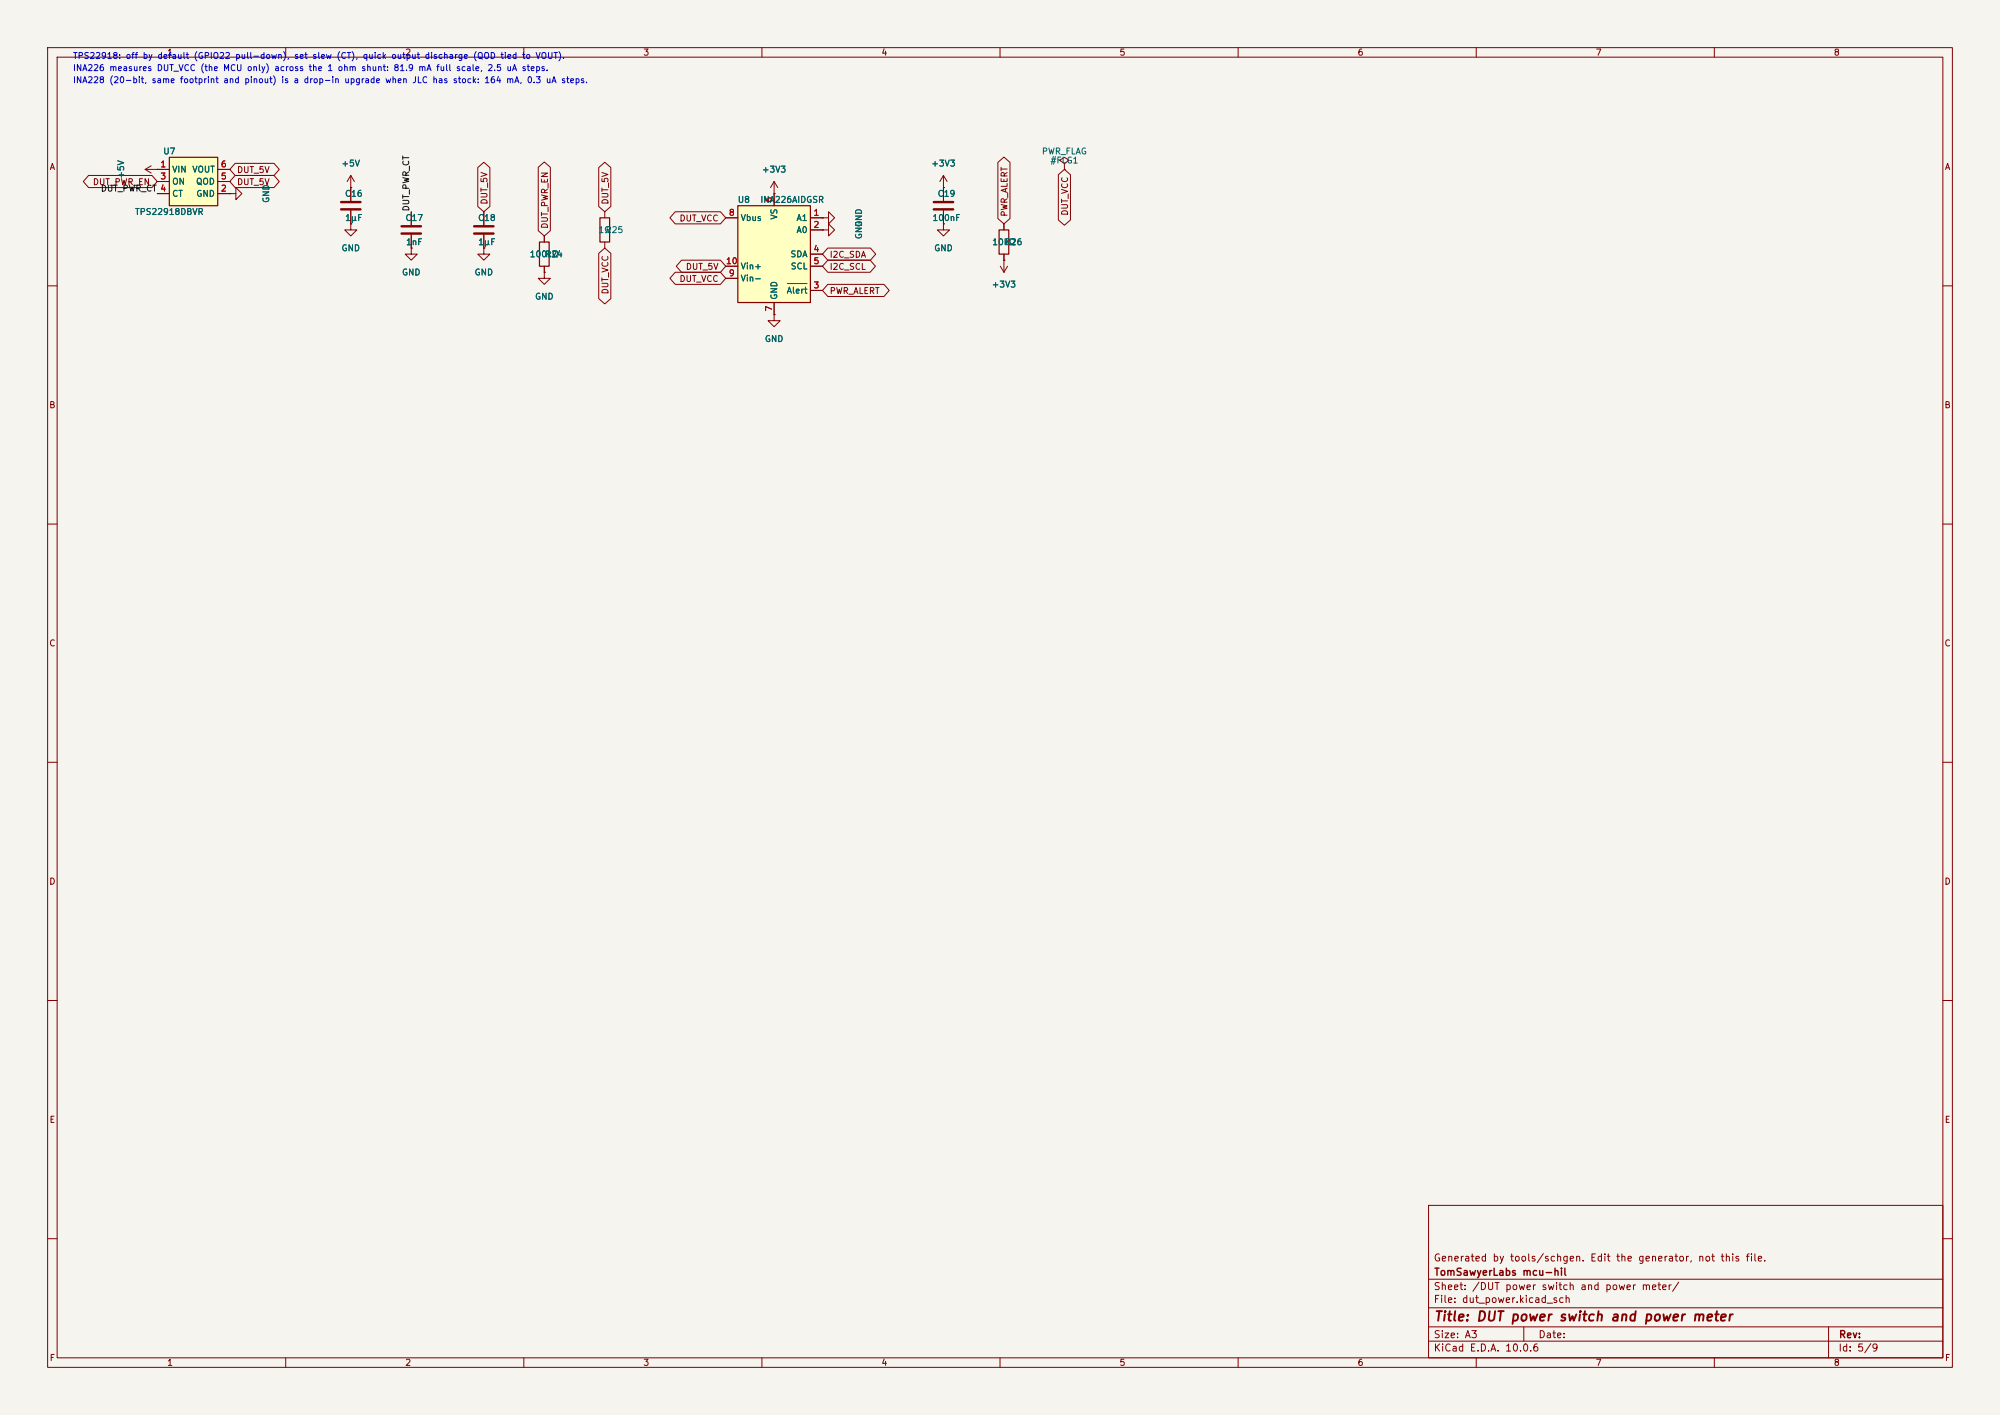
[picture p19: page 5]

INA228 (20-bit, same footprint and pinout) is a drop-in upgrade when JLC has stock: 164 mA, 0.3 uA steps. TPS22918: off by default (GPIO22 pull-down), set slew (CT), quick output discharge (QOD tied to VOUT). U7
INA226 measures DUT_VCC (the MCU only) across the 1 ohm shunt: 81.9 mA full scale, 2.5 uA steps.

TomSawyerLabs mcu-hil
Sheet: /DUT power switch and power meter/
File: dut_power.kicad_sch
Title: DUT power switch and power meter

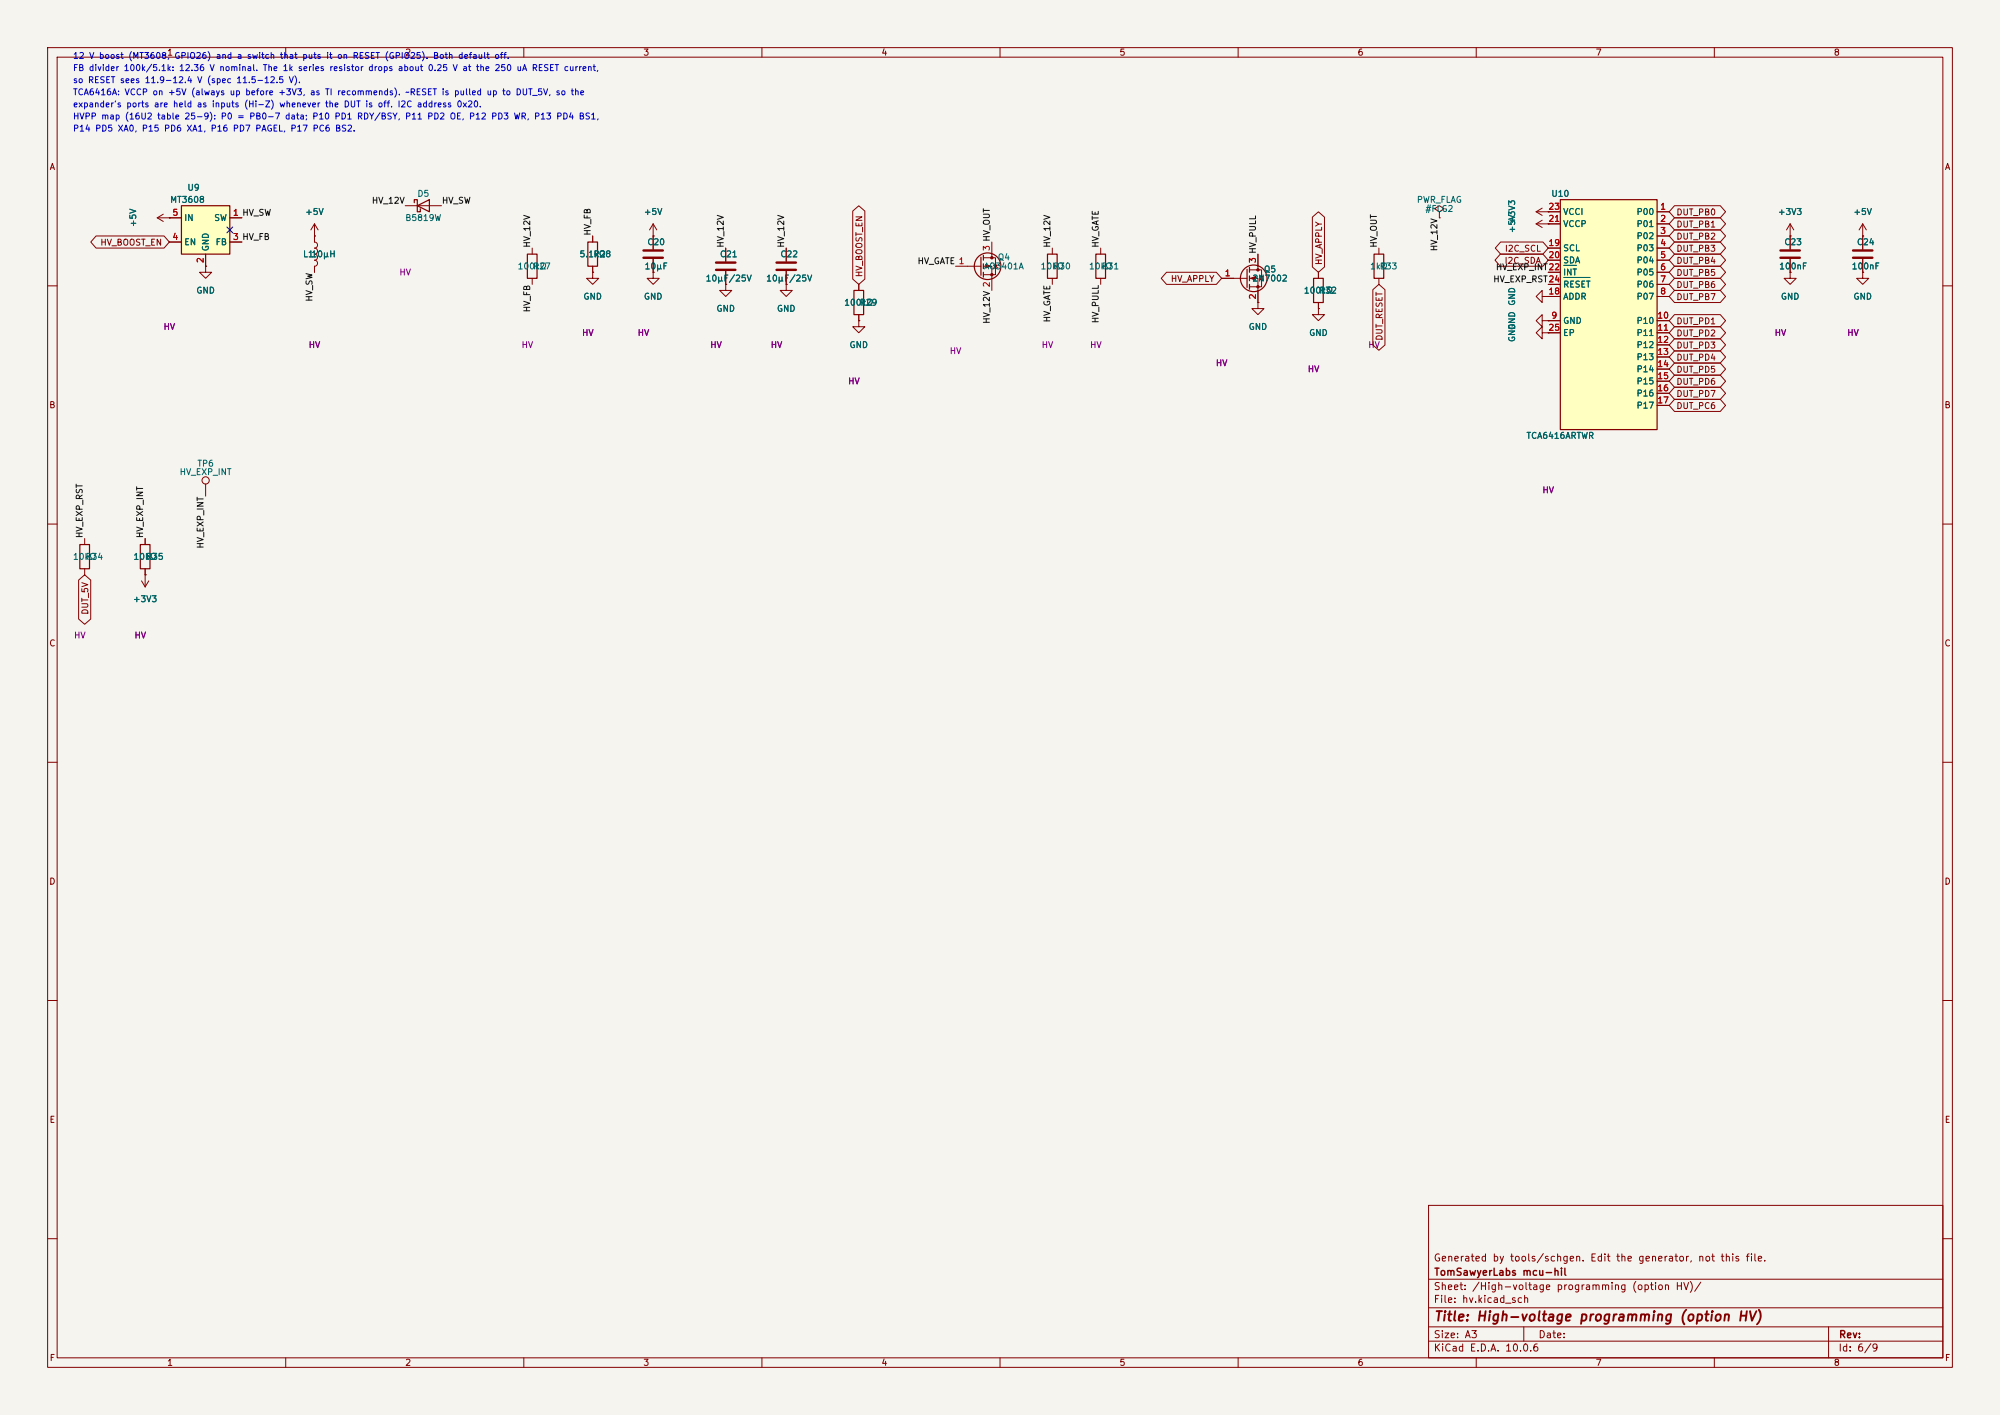
[picture p20: page 6]

Generated by tools/schgen. Edit the generator, not this file.
TomSawyerLabs mcu-hil
Sheet: /High-voltage programming (option HV)/
File: hv.kicad_sch
Title: High-voltage programming (option HV)

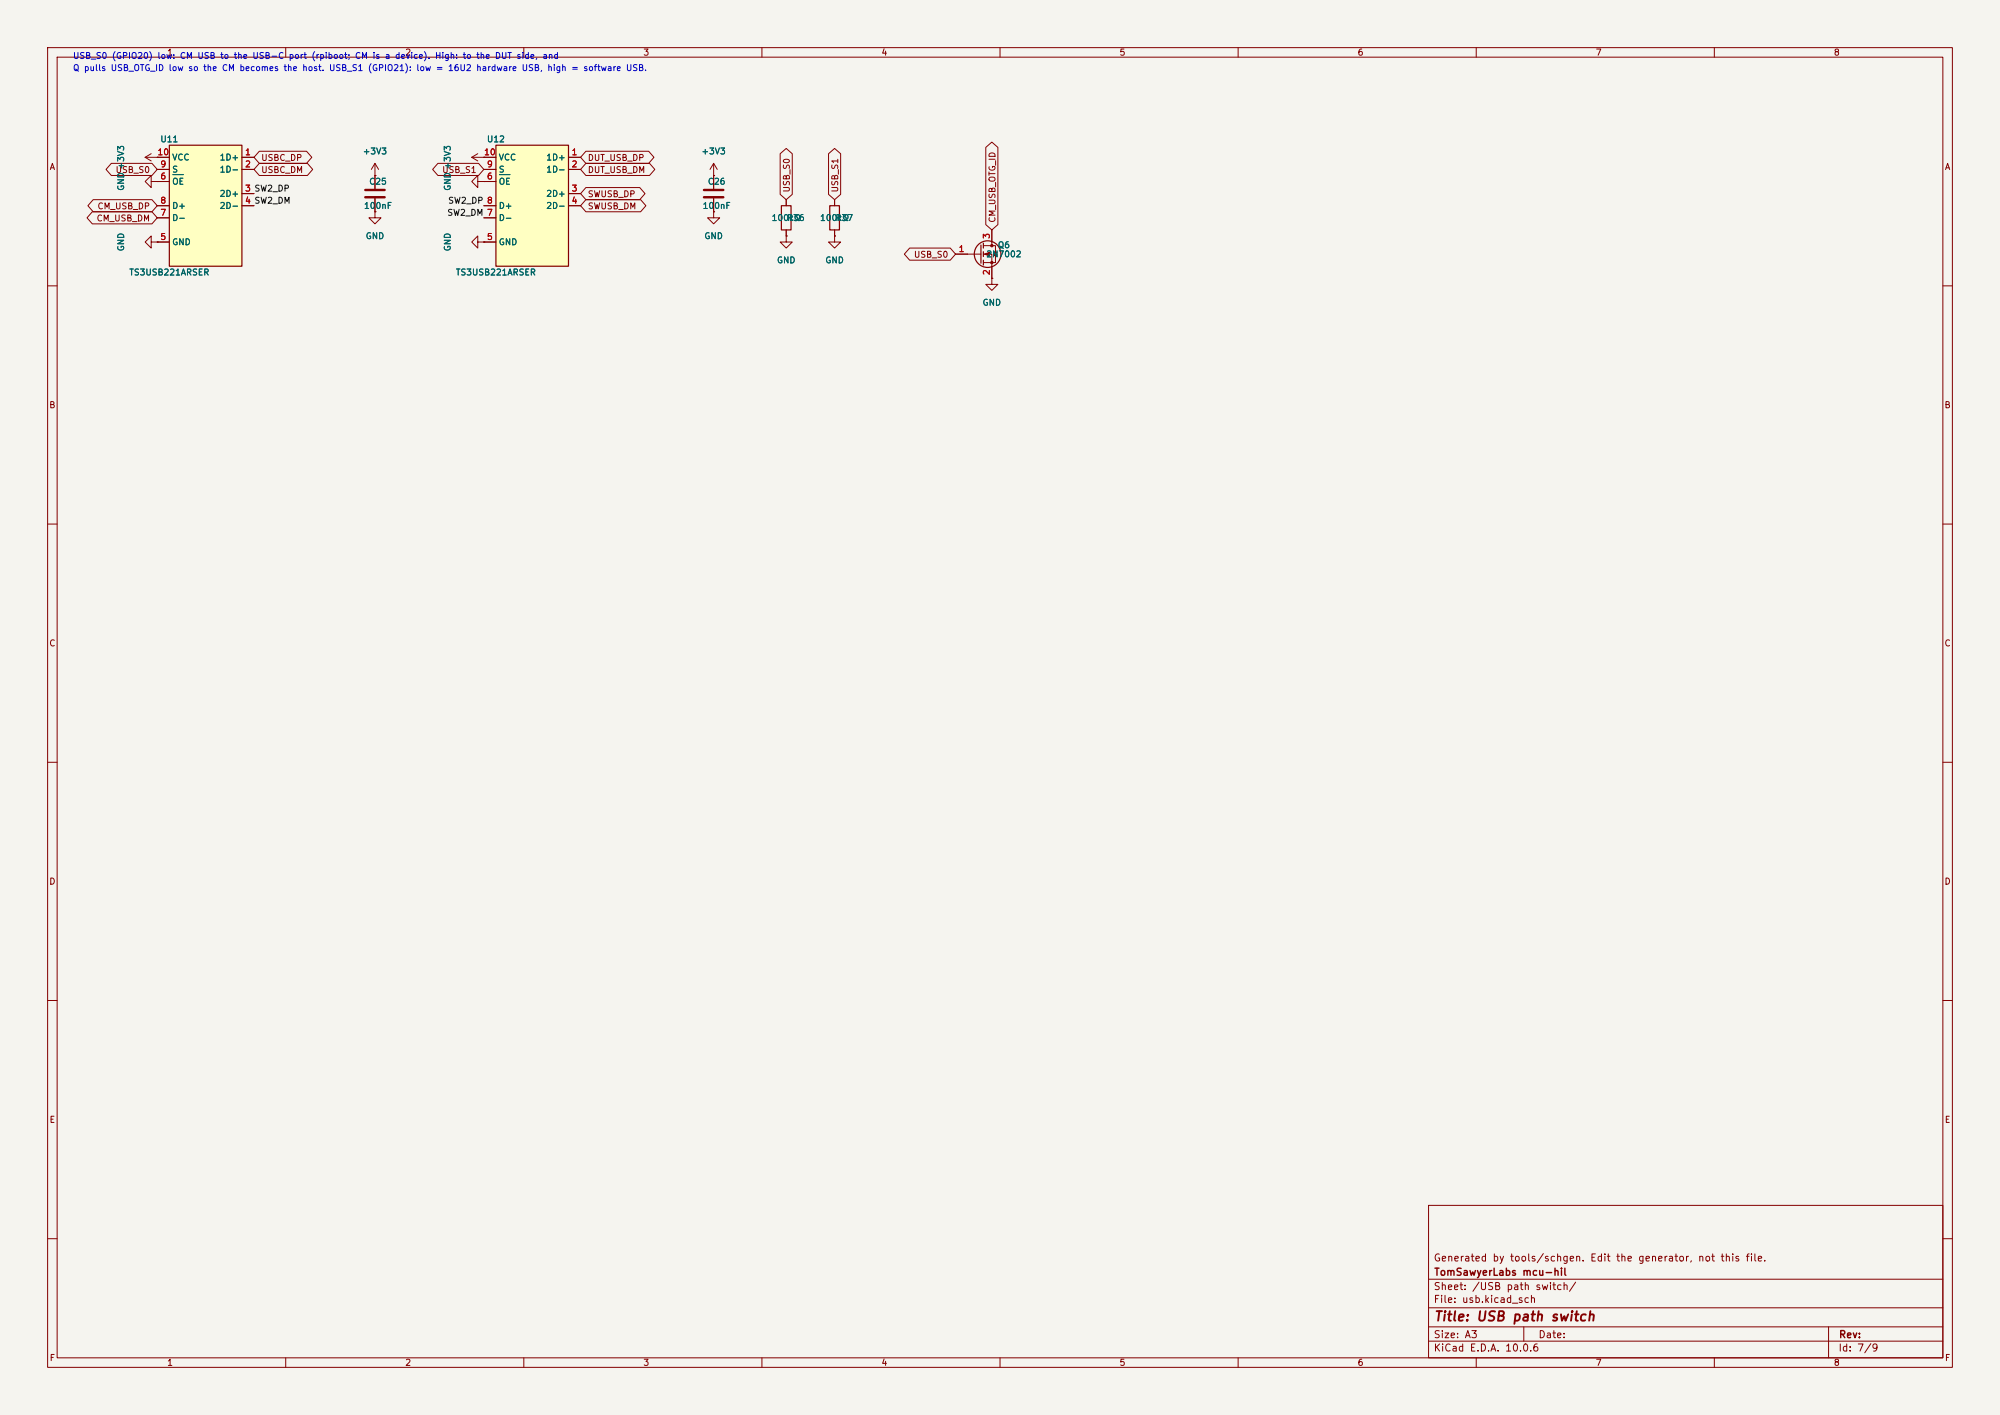
[picture p21: page 7]

Generated by tools/schgen. Edit the generator, not this file.
TomSawyerLabs mcu-hil
Sheet: /USB path switch/
File: usb.kicad_sch
Title: USB path switch

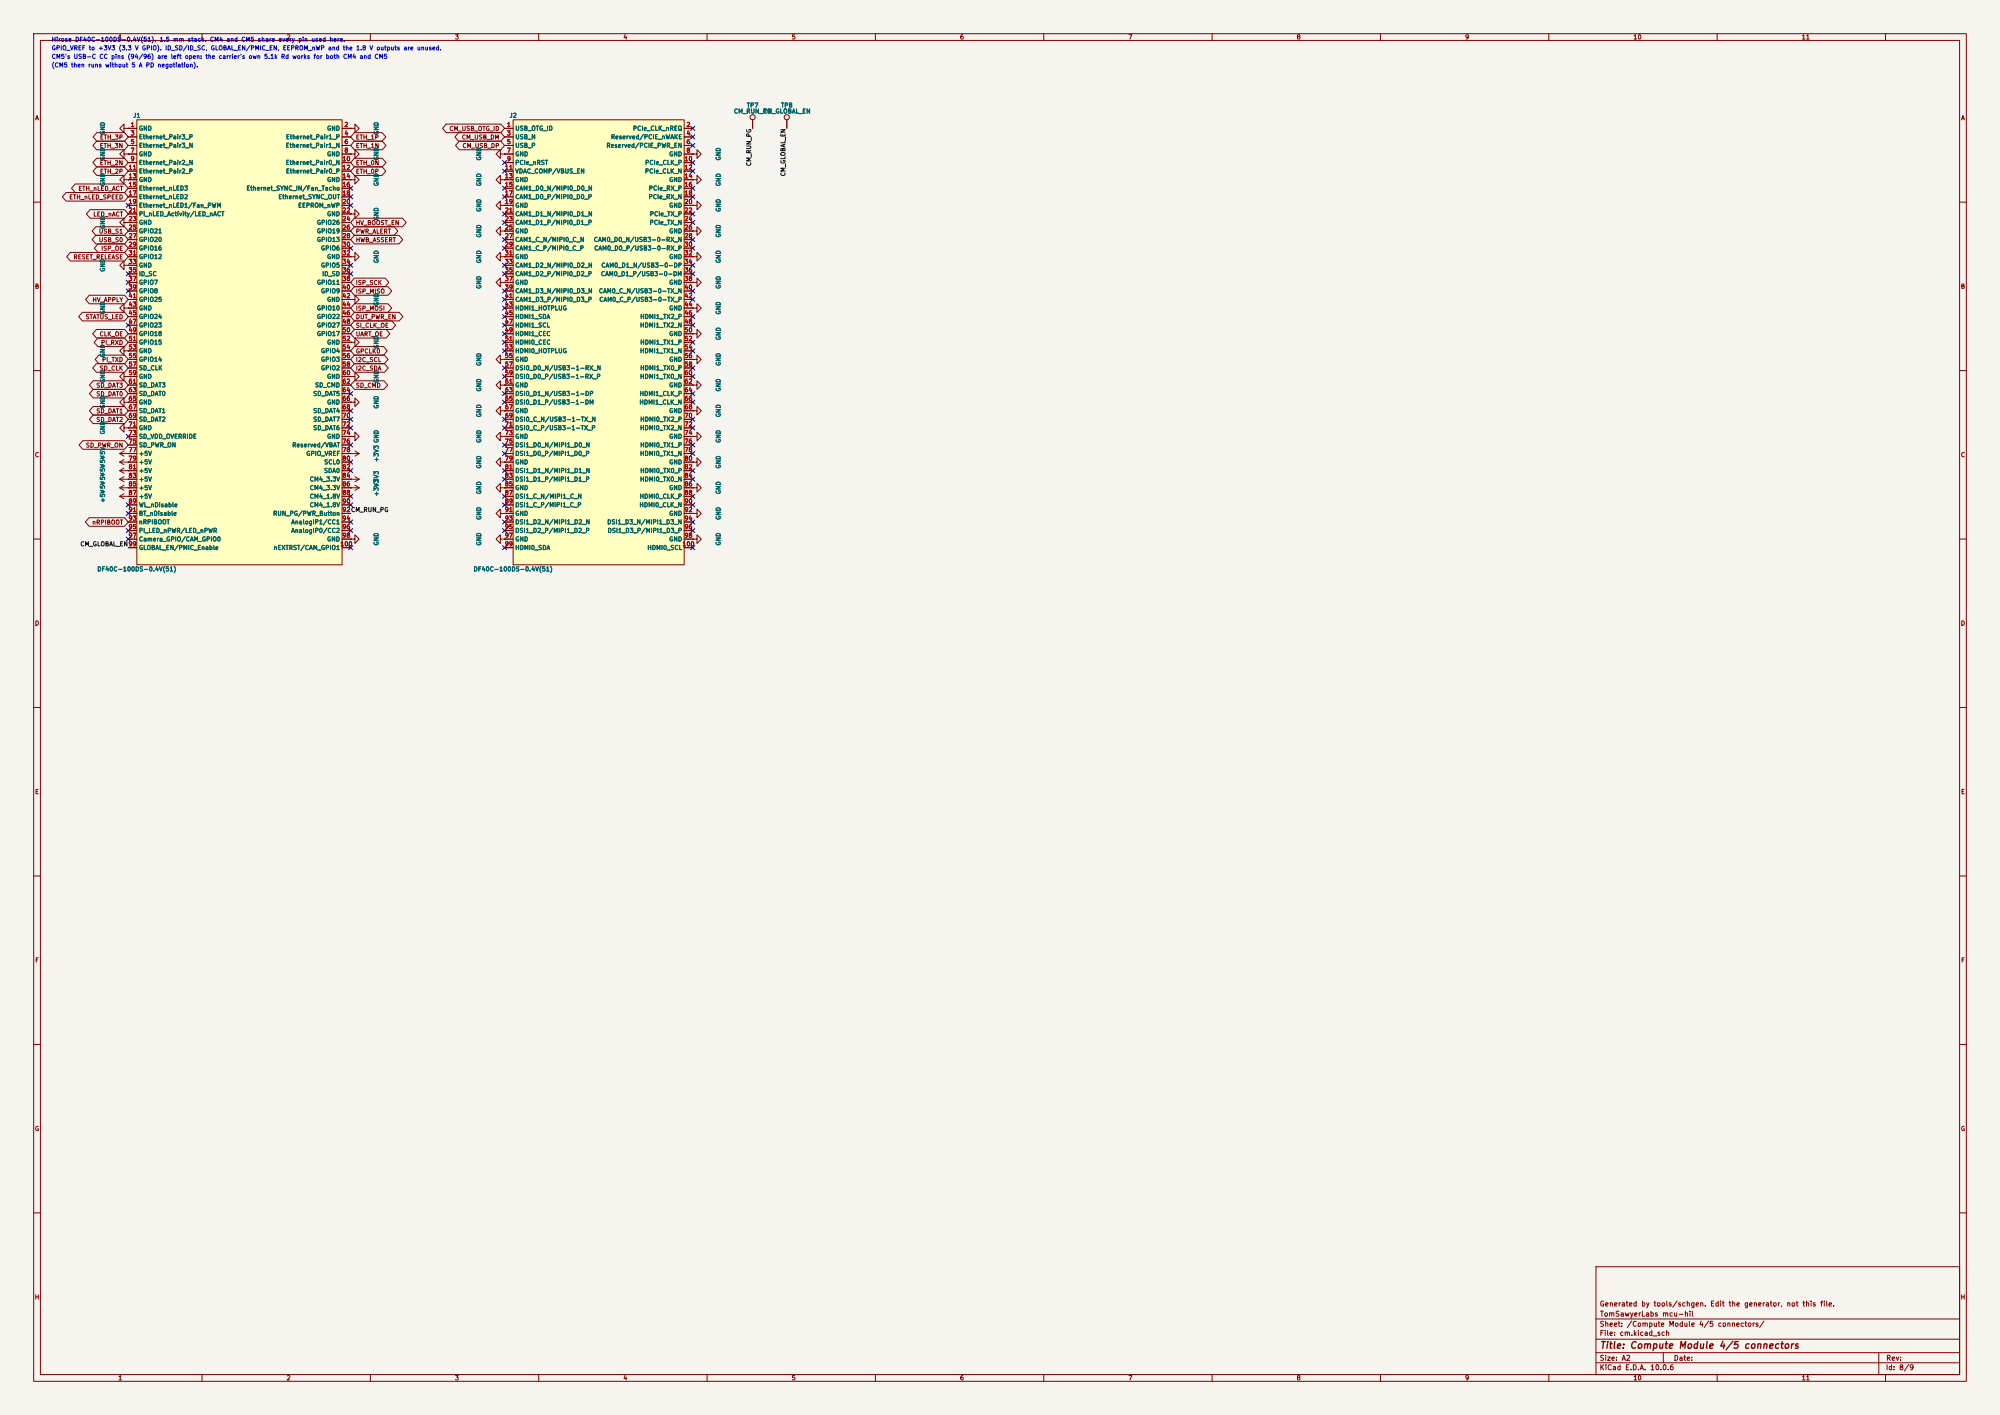
[picture p22: page 8]

(CM5 then runs without 5 A PD negotiation). Hirose DF40C-100DS-0.4V(51), 1.5 mm stack. CM4 and CM5 share every pin used here. CM5's USB-C CC pins (94/96) are left open: the carrier's own 5.1k Rd works for both CM4 and CM5 GPIO_VREF to +3V3 (3.3 V GPIO). ID_SD/ID_SC, GLOBAL_EN/PMIC_EN, EEPROM_nWP and the 1.8 V outputs are unused. GND GND

TomSawyerLabs mcu-hil
Sheet: /Compute Module 4/5 connectors/
File: cm.kicad_sch
Title: Compute Module 4/5 connectors

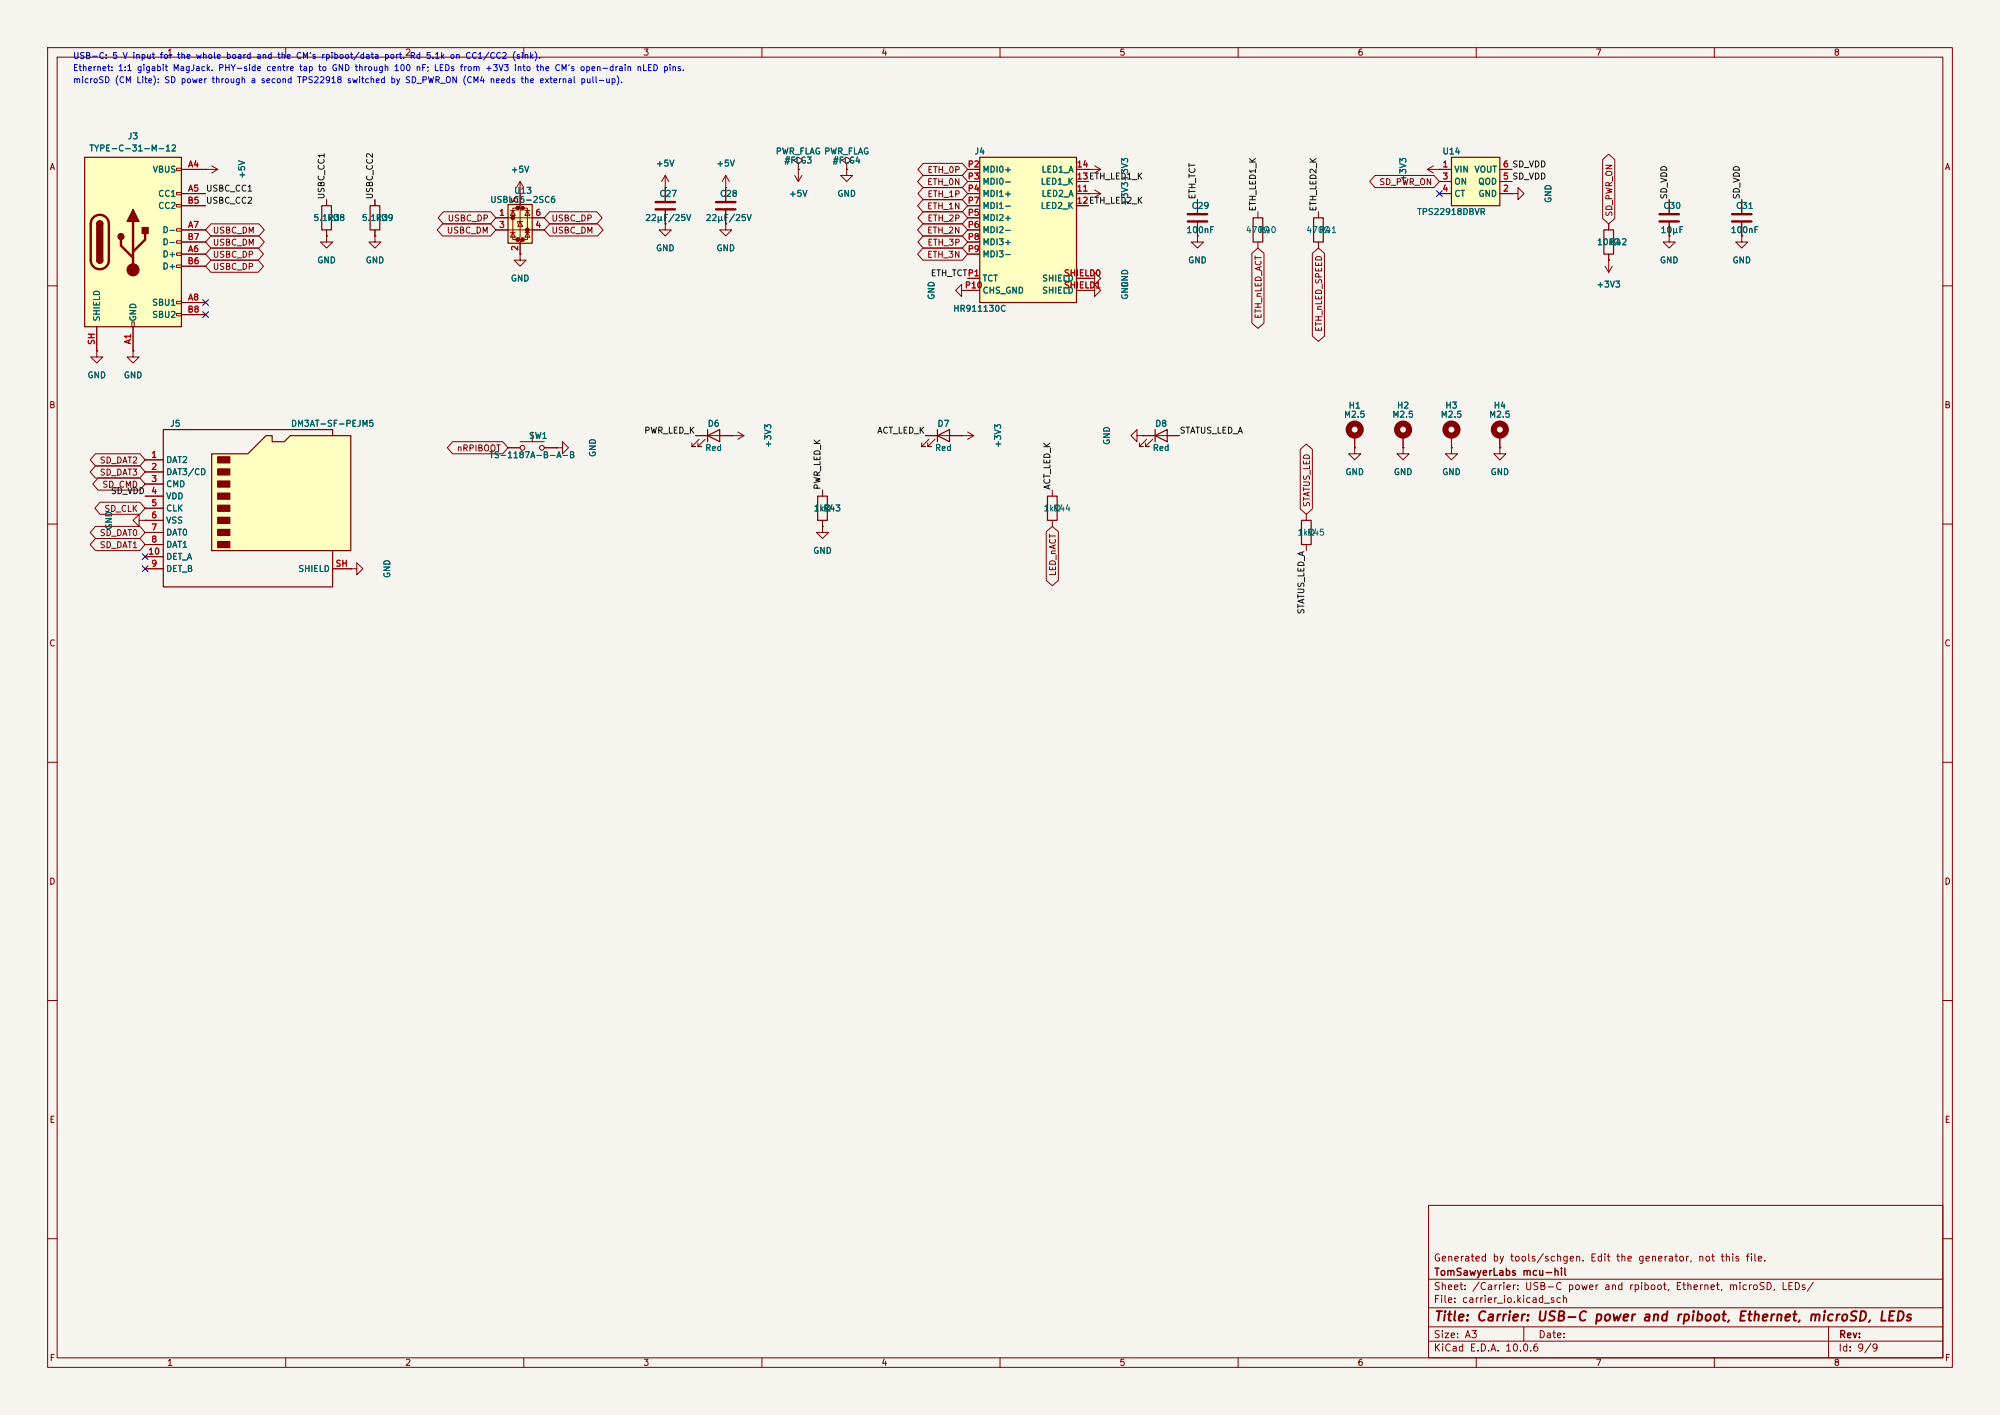
[picture p23: page 9]

Generated by tools/schgen. Edit the generator, not this file.
TomSawyerLabs mcu-hil
Sheet: /Carrier: USB-C power and rpiboot, Ethernet, microSD, LEDs/
File: carrier_io.kicad_sch
Title: Carrier: USB-C power and rpiboot, Ethernet, microSD, LEDs
