TomSawyerLabs/mcu-hil/hw/hat/mcu-hil-hat.pdf

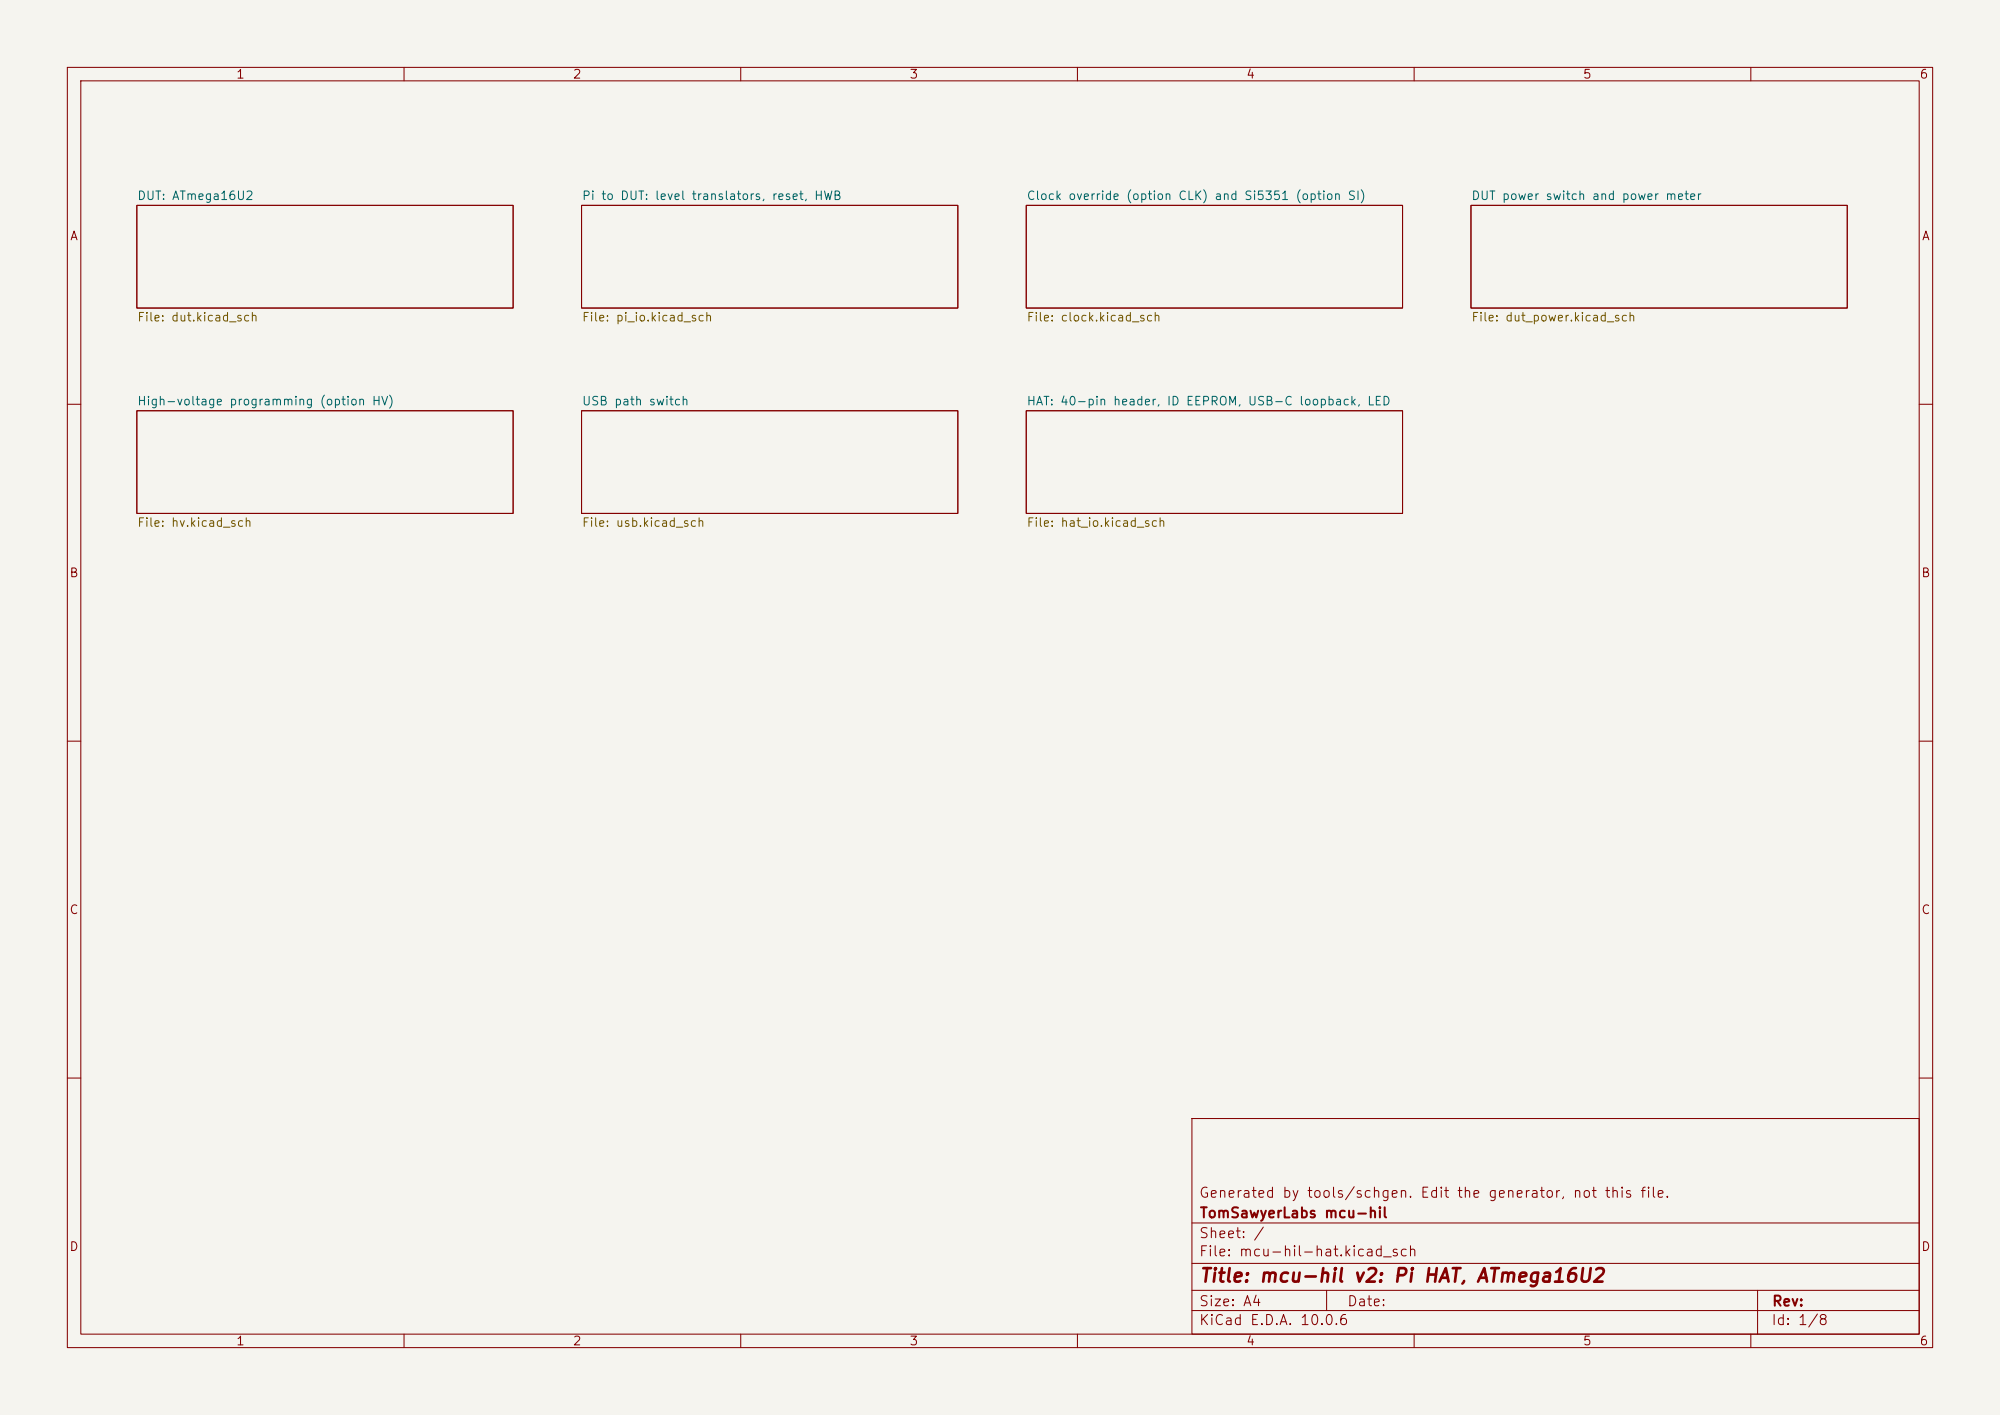
[picture p24: page 1]

Generated by tools/schgen. Edit the generator, not this file.
TomSawyerLabs mcu-hil
Sheet: /
File: mcu-hil-hat.kicad_sch
Title: mcu-hil v2: Pi HAT, ATmega16U2

Size: A4 | Rev:
KiCad E.D.A. 10.0.6 | Id: 1/8

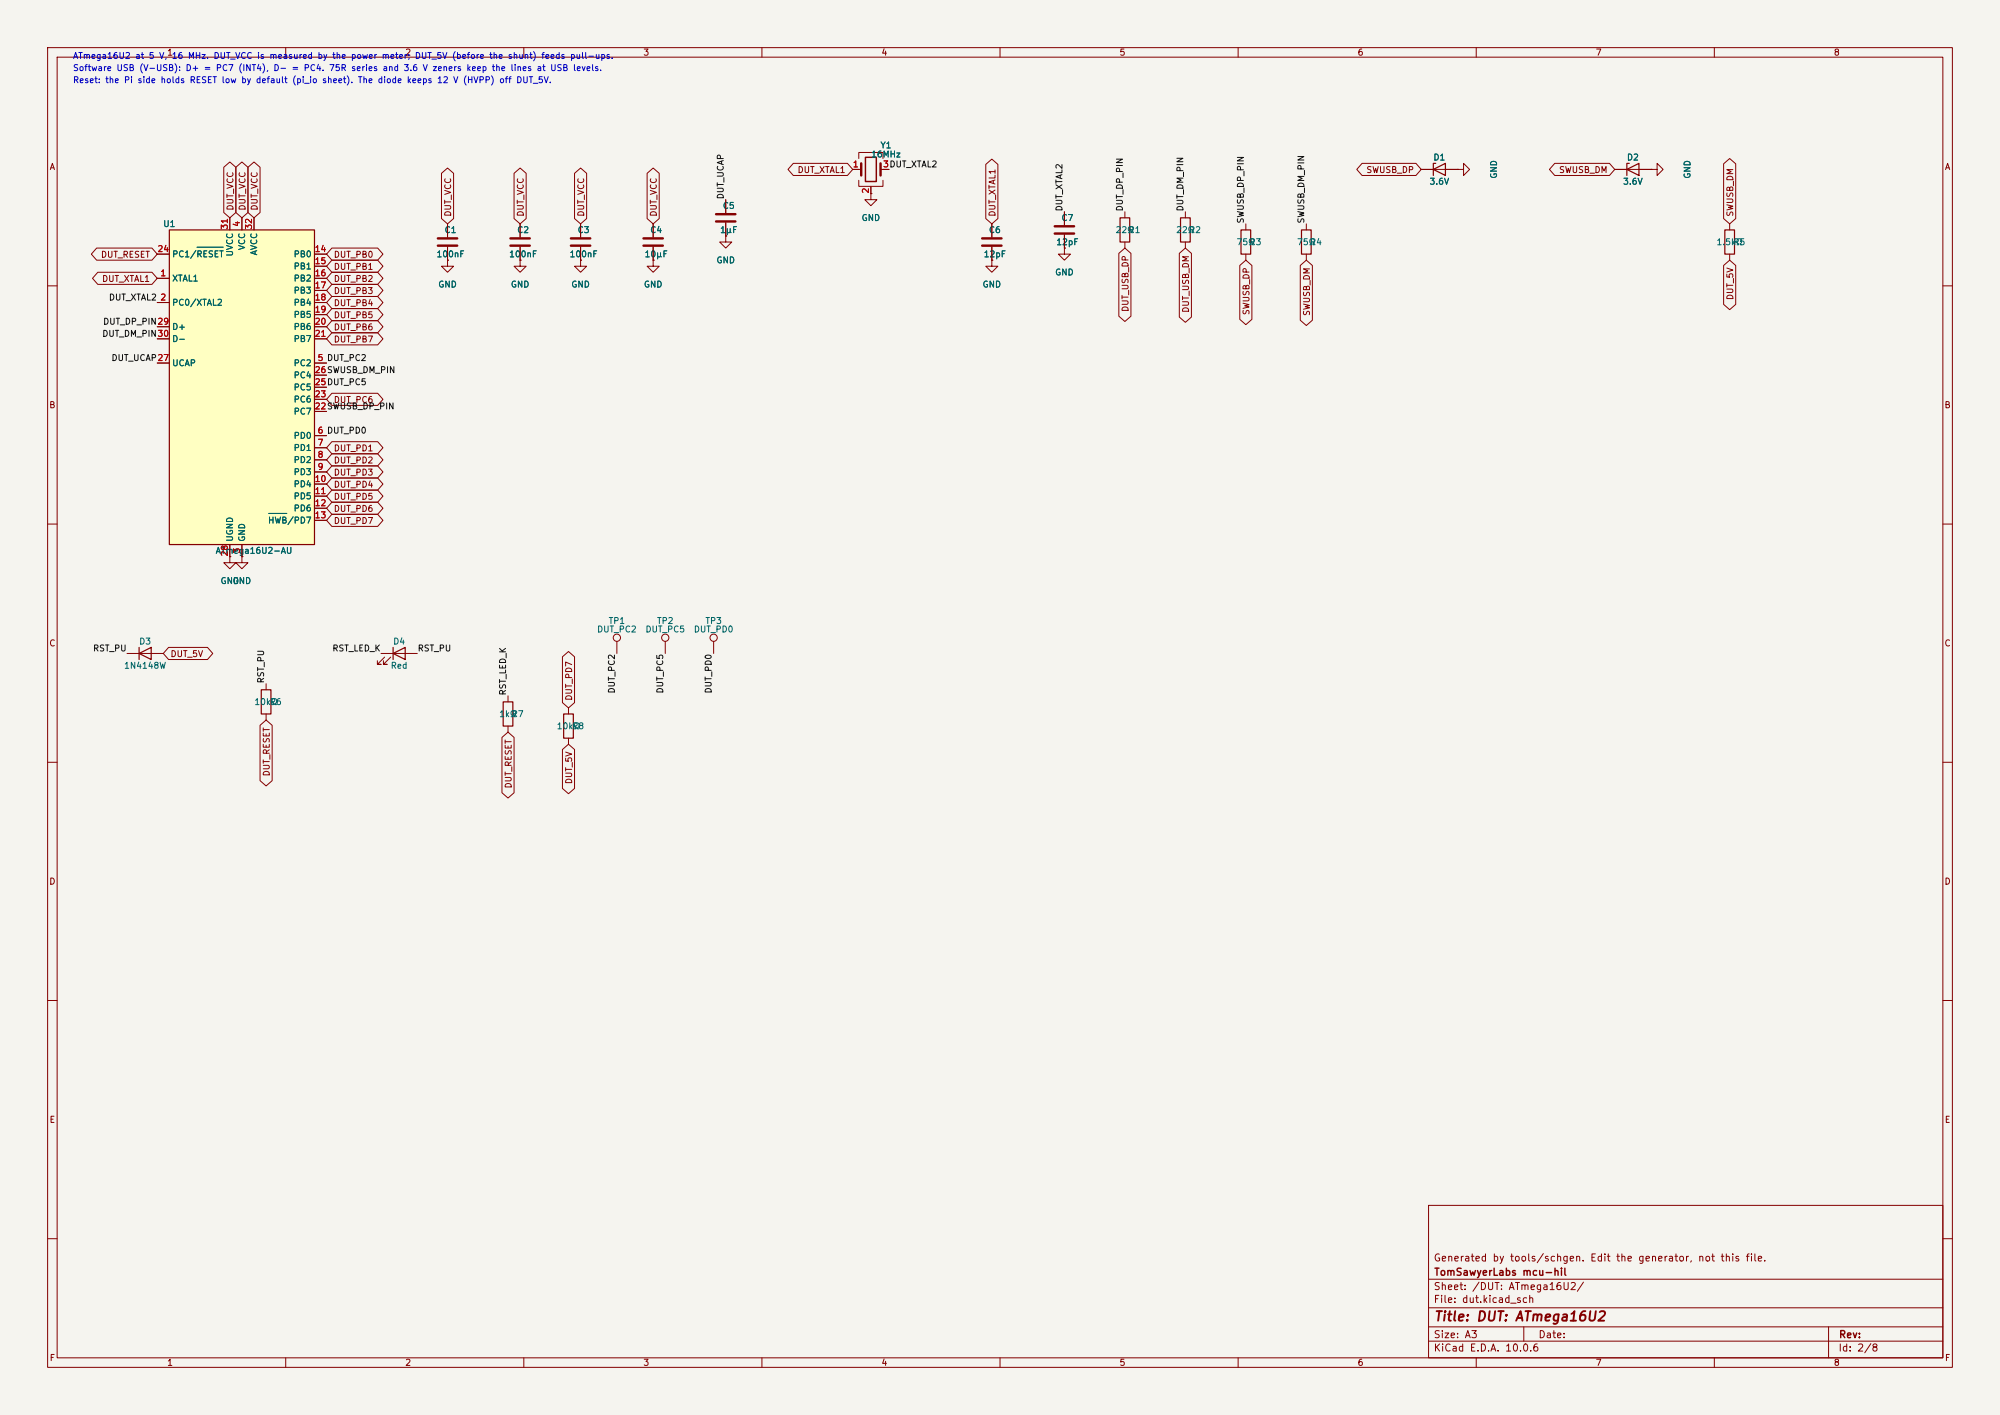
[picture p25: page 2]

4 PC2 5 PD0 6 PD1 7 PD2 8 PD3 9 PD4 10 PD5 11 PD6 12 HWB/PD7 13 PB0 14 PB1 15 PB2 16 PB3 17 PB4 18 PB5 19 PB6 20 PB7 21 PC7 22 PC6 23 PC1/RESET 24 PC5 25 PC4 26 UCAP 27 UGND 28 D+ 29 D- 30 UVCC 31 AVCC U1 32
10µF GND U1

4 PC2 5 PD0 6 PD1 7 PD2 8 PD3 9 PD4 10 PD5 11 PD6 12 HWB/PD7 13 PB0 14 PB1 15 PB2 16 PB3 17 PB4 18 PB5 19 PB6 20 PB7 21 PC7 22 PC6 23 PC1/RESET 24 PC5 25 PC4 26 UCAP 27 UGND 28 D+ 29 D- 30 UVCC 31 AVCC 32

Generated by tools/schgen. Edit the generator, not this file.
TomSawyerLabs mcu-hil
Sheet: /DUT: ATmega16U2/
File: dut.kicad_sch
Title: DUT: ATmega16U2

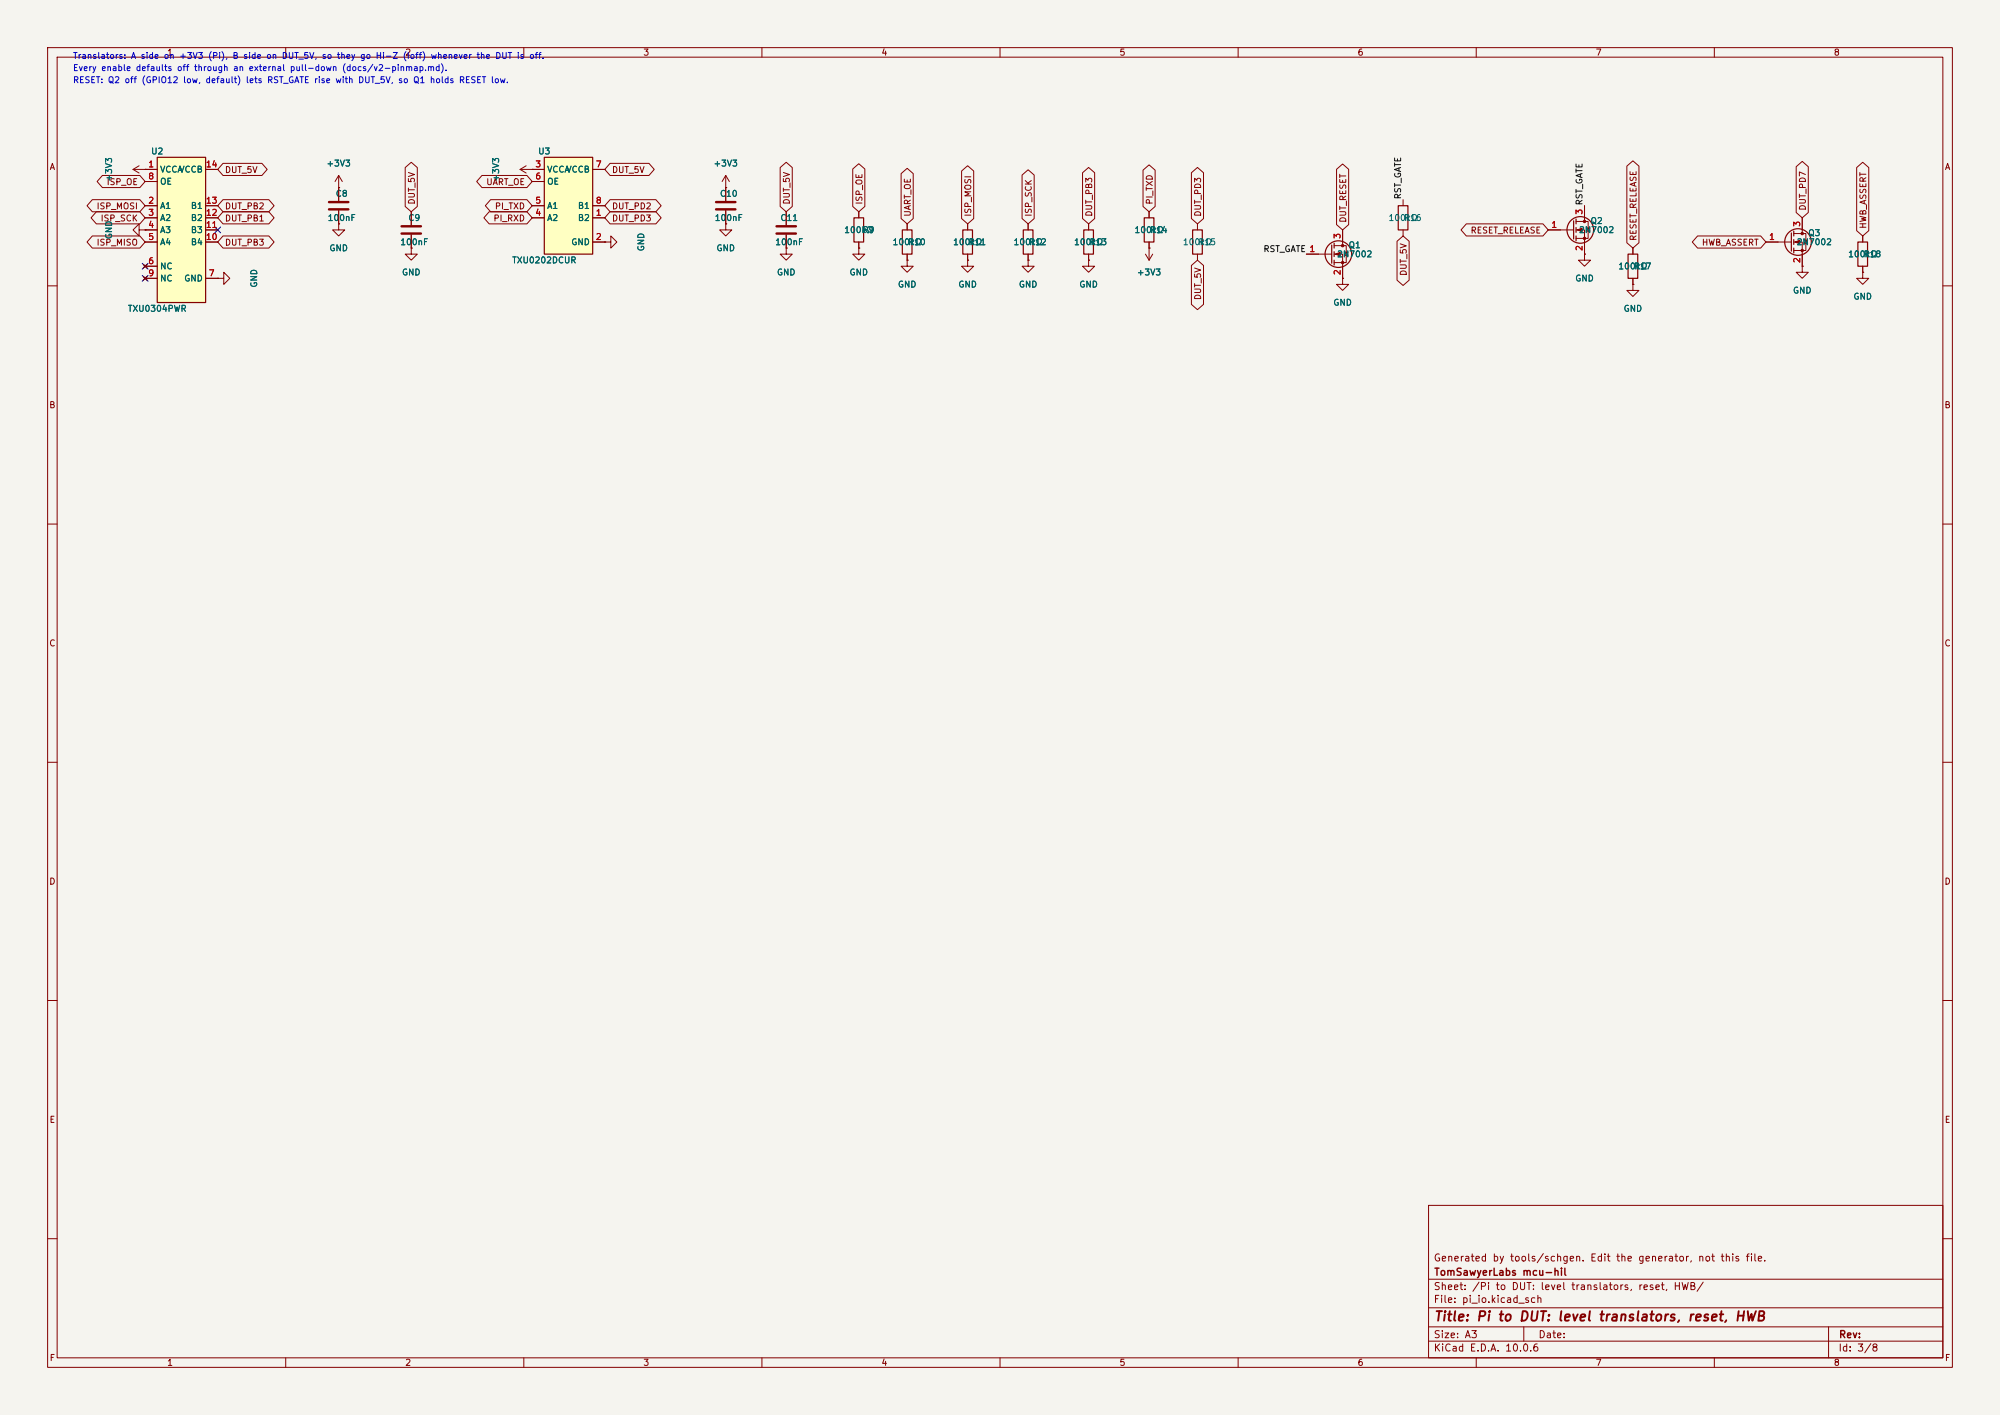
[picture p26: page 3]

Generated by tools/schgen. Edit the generator, not this file.
TomSawyerLabs mcu-hil
Sheet: /Pi to DUT: level translators, reset, HWB/
File: pi_io.kicad_sch
Title: Pi to DUT: level translators, reset, HWB

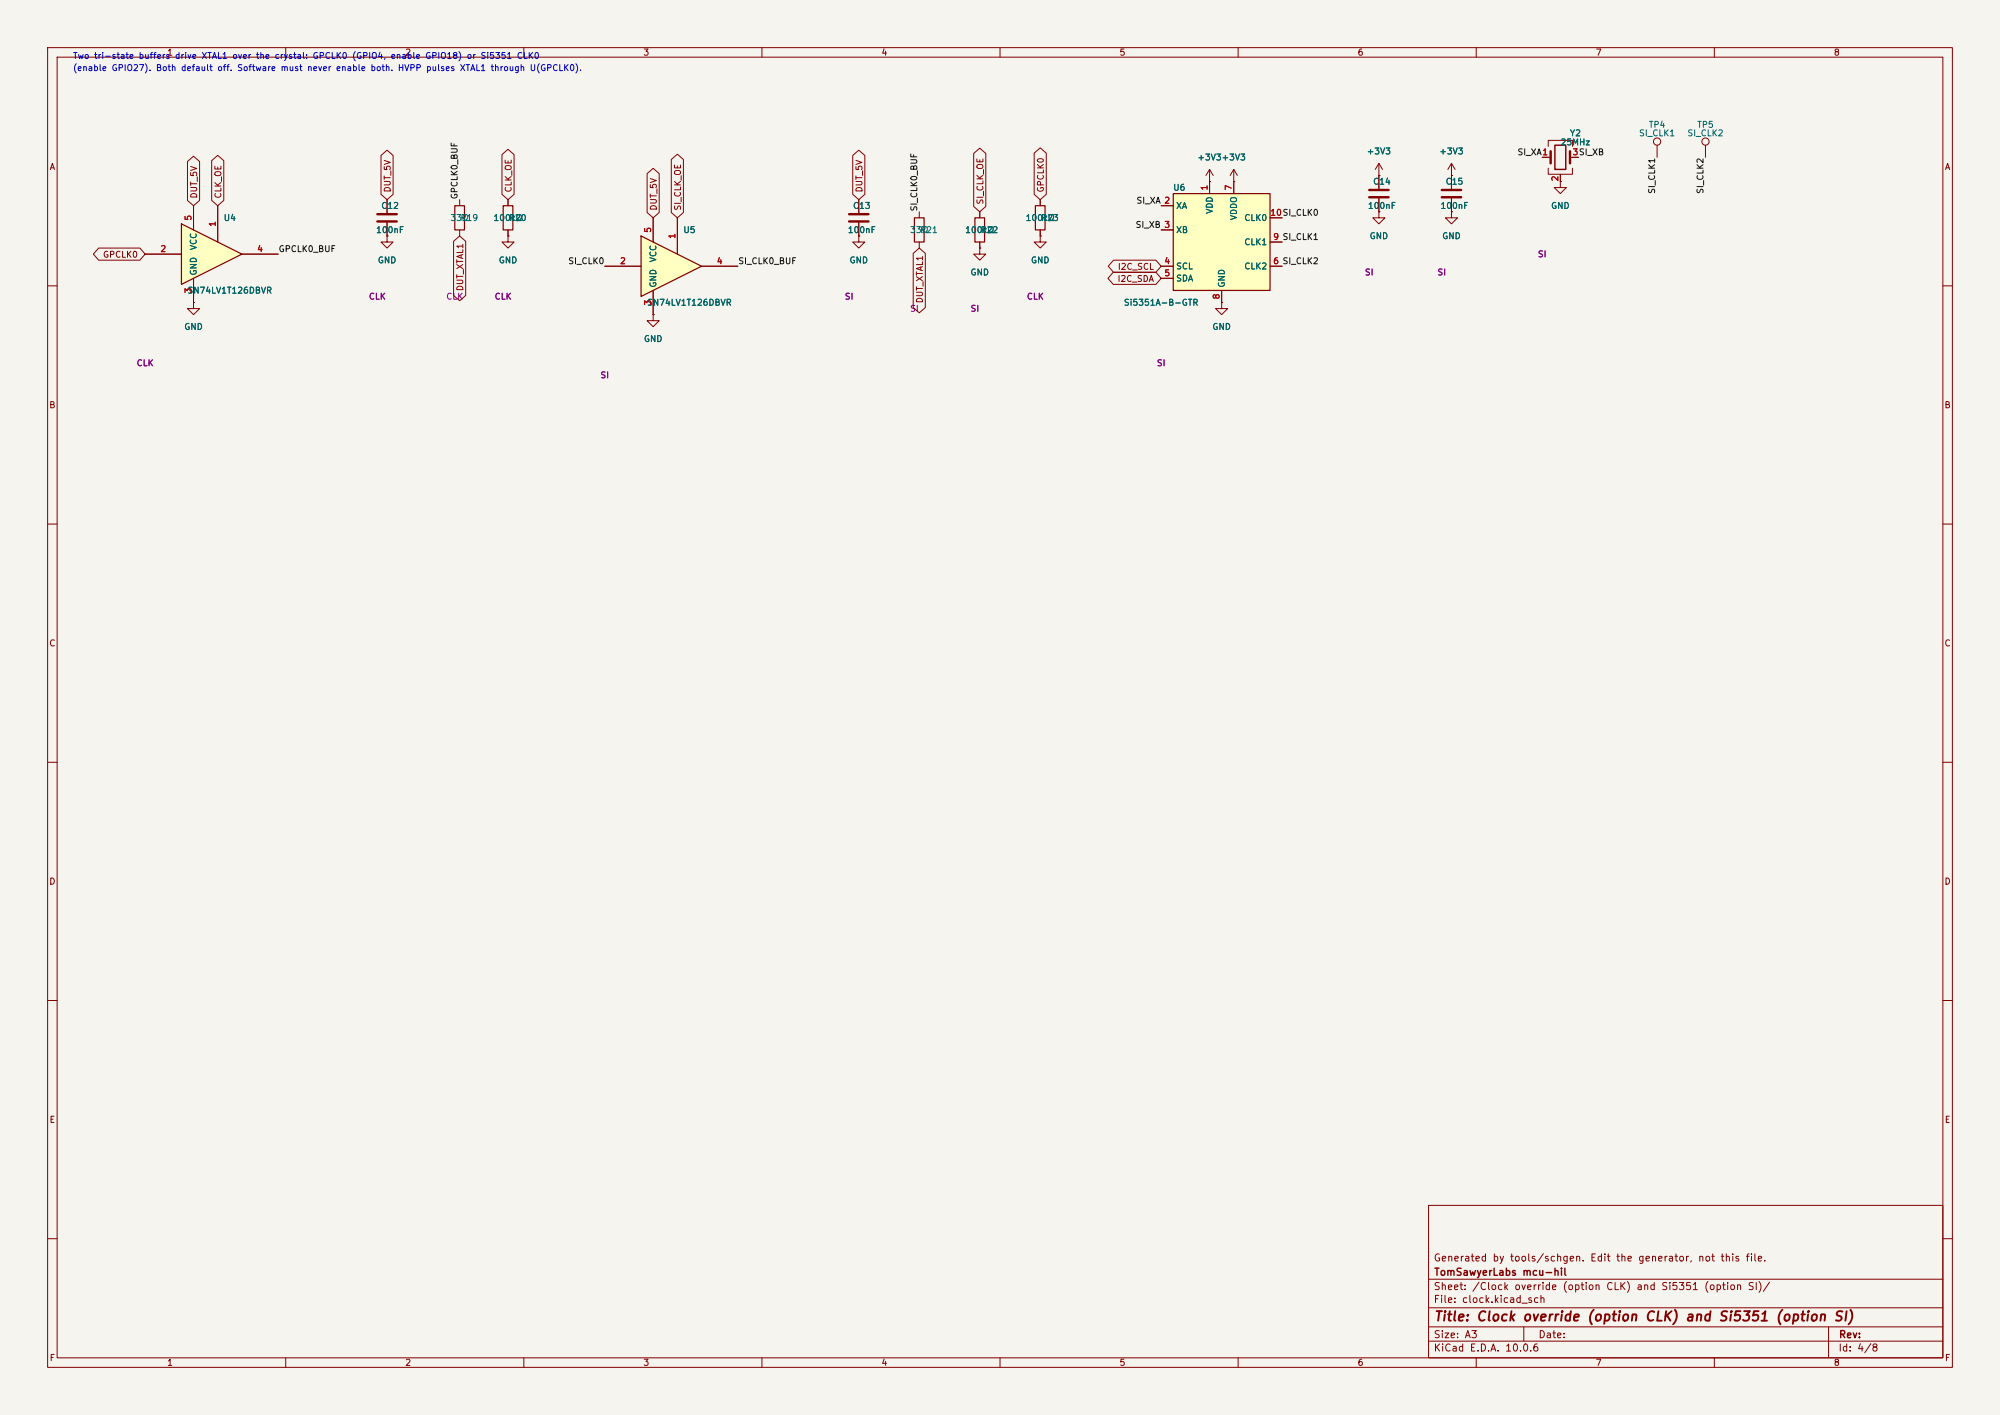
[picture p27: page 4]

Two tri-state buffers drive XTAL1 over the crystal: GPCLK0 (GPIO4, enable GPIO18) or Si5351 CLK0

Generated by tools/schgen. Edit the generator, not this file.
TomSawyerLabs mcu-hil
Sheet: /Clock override (option CLK) and Si5351 (option SI)/
File: clock.kicad_sch
Title: Clock override (option CLK) and Si5351 (option SI)

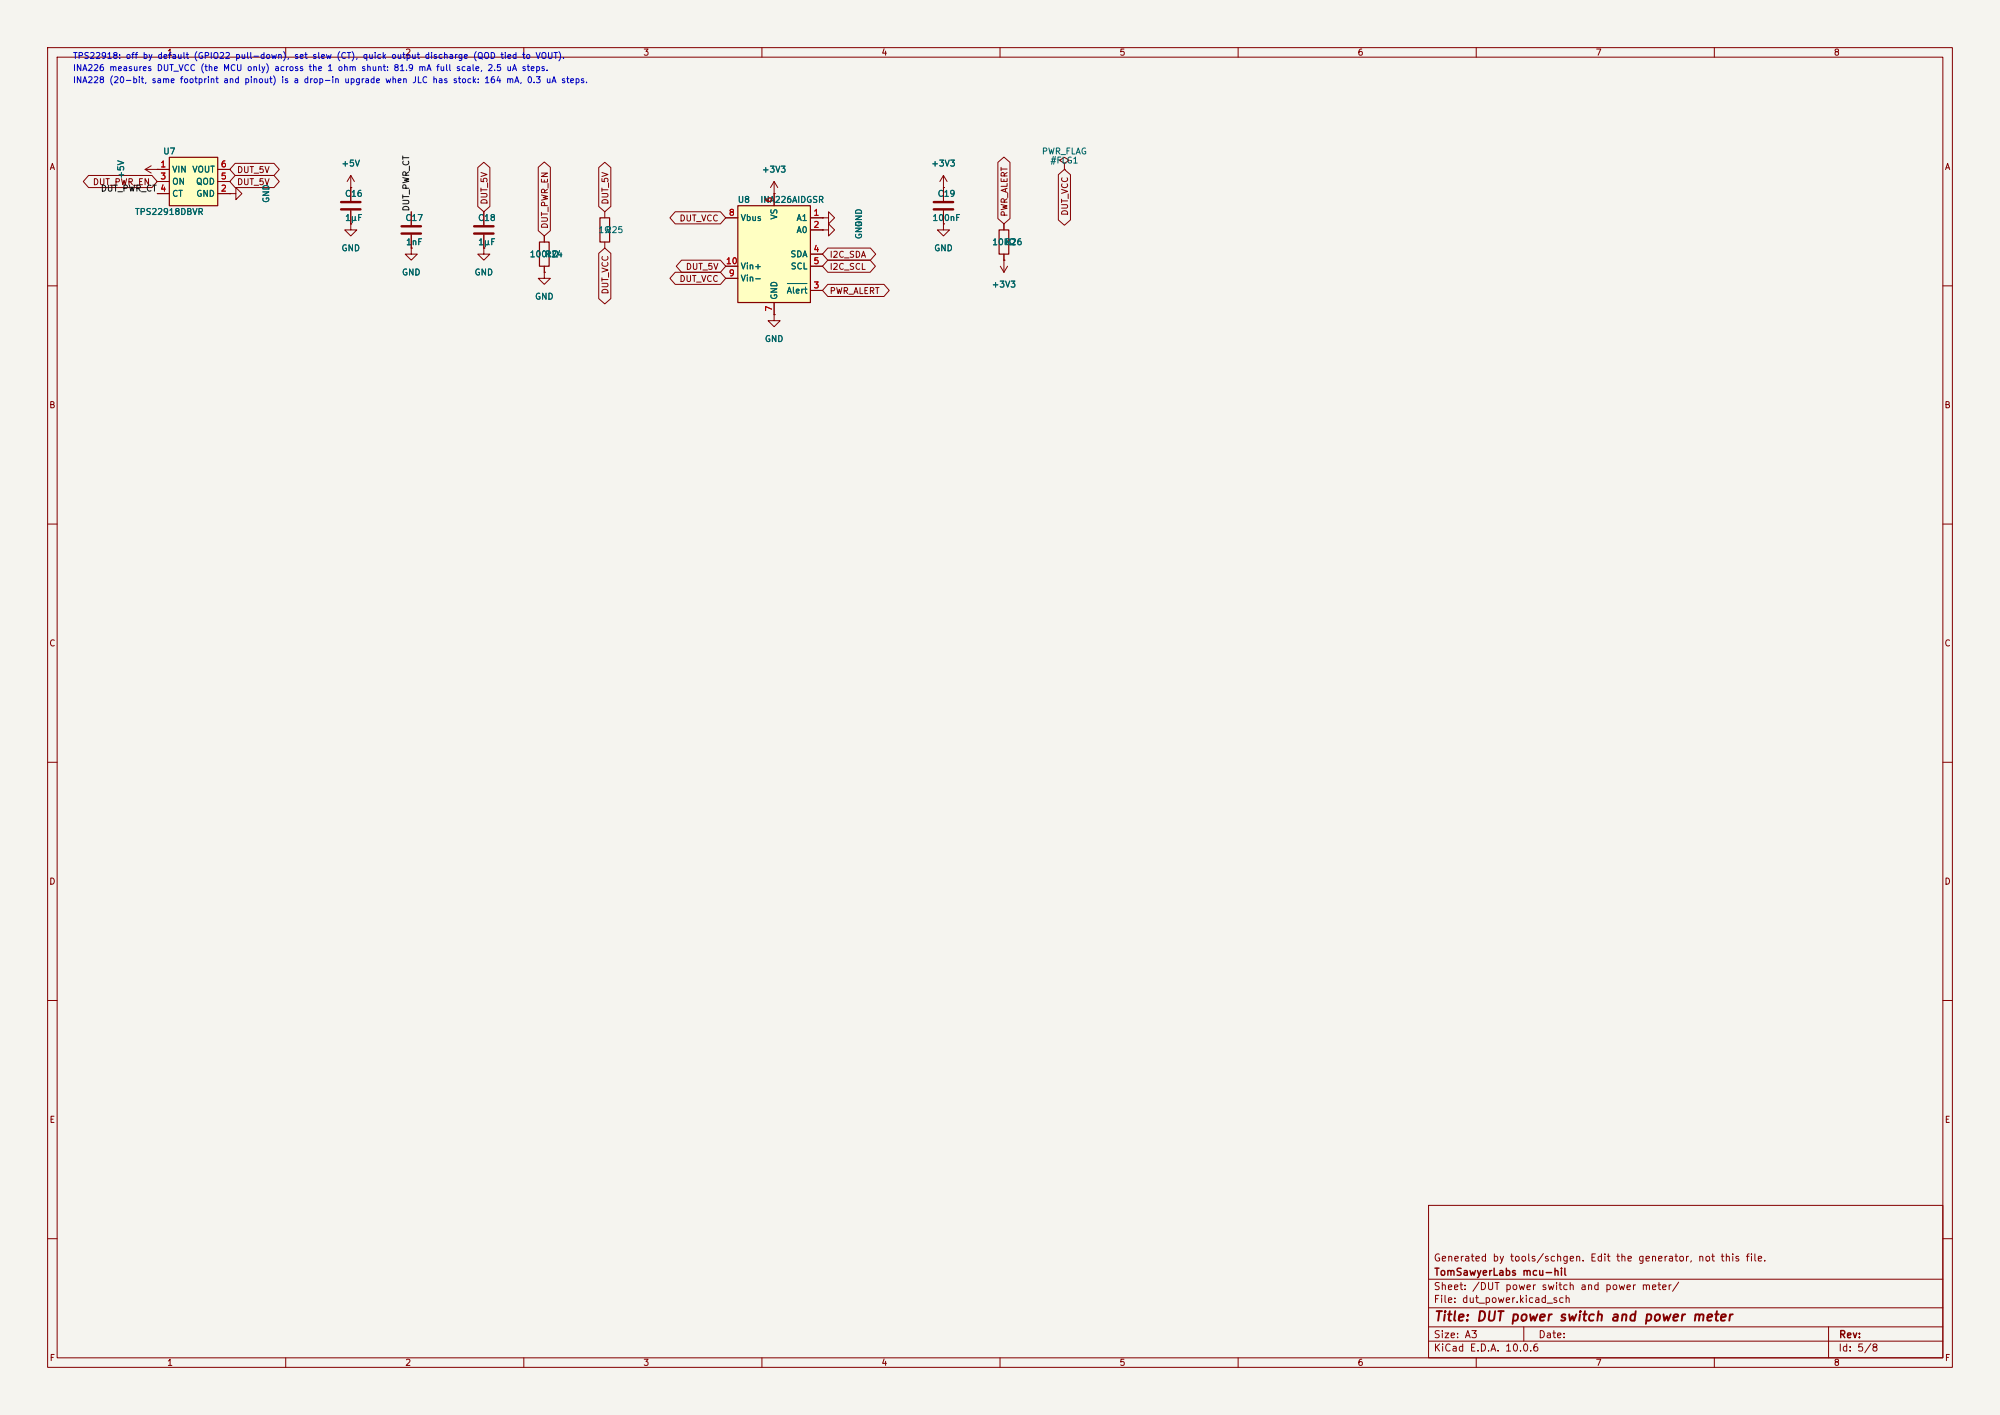
[picture p28: page 5]

INA228 (20-bit, same footprint and pinout) is a drop-in upgrade when JLC has stock: 164 mA, 0.3 uA steps. TPS22918: off by default (GPIO22 pull-down), set slew (CT), quick output discharge (QOD tied to VOUT). U7
INA226 measures DUT_VCC (the MCU only) across the 1 ohm shunt: 81.9 mA full scale, 2.5 uA steps.

TomSawyerLabs mcu-hil
Sheet: /DUT power switch and power meter/
File: dut_power.kicad_sch
Title: DUT power switch and power meter

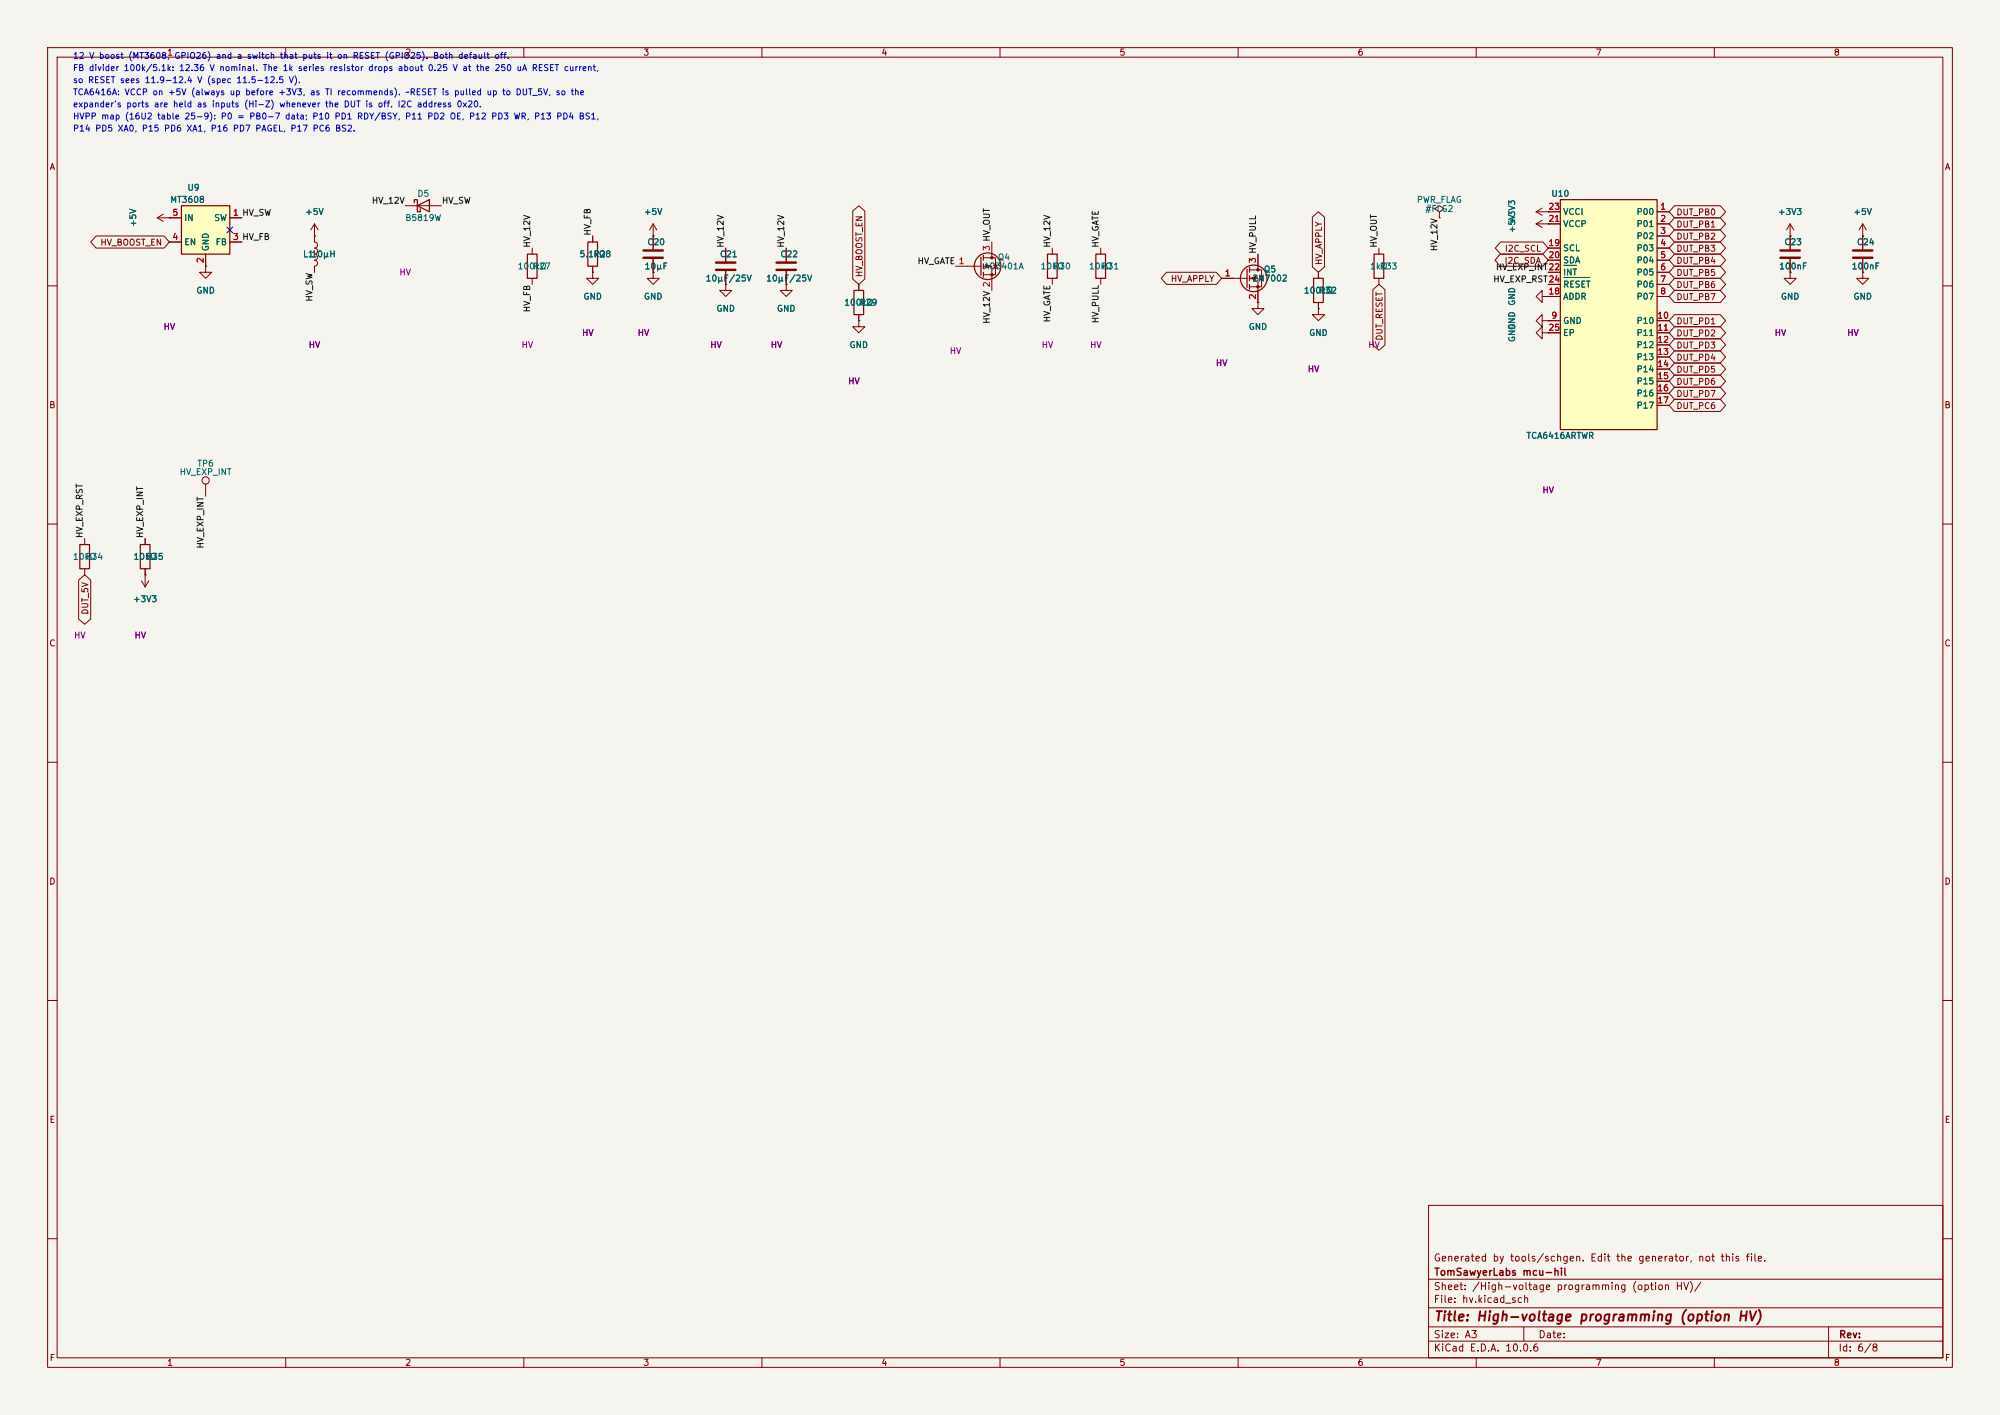
[picture p29: page 6]

Generated by tools/schgen. Edit the generator, not this file.
TomSawyerLabs mcu-hil
Sheet: /High-voltage programming (option HV)/
File: hv.kicad_sch
Title: High-voltage programming (option HV)

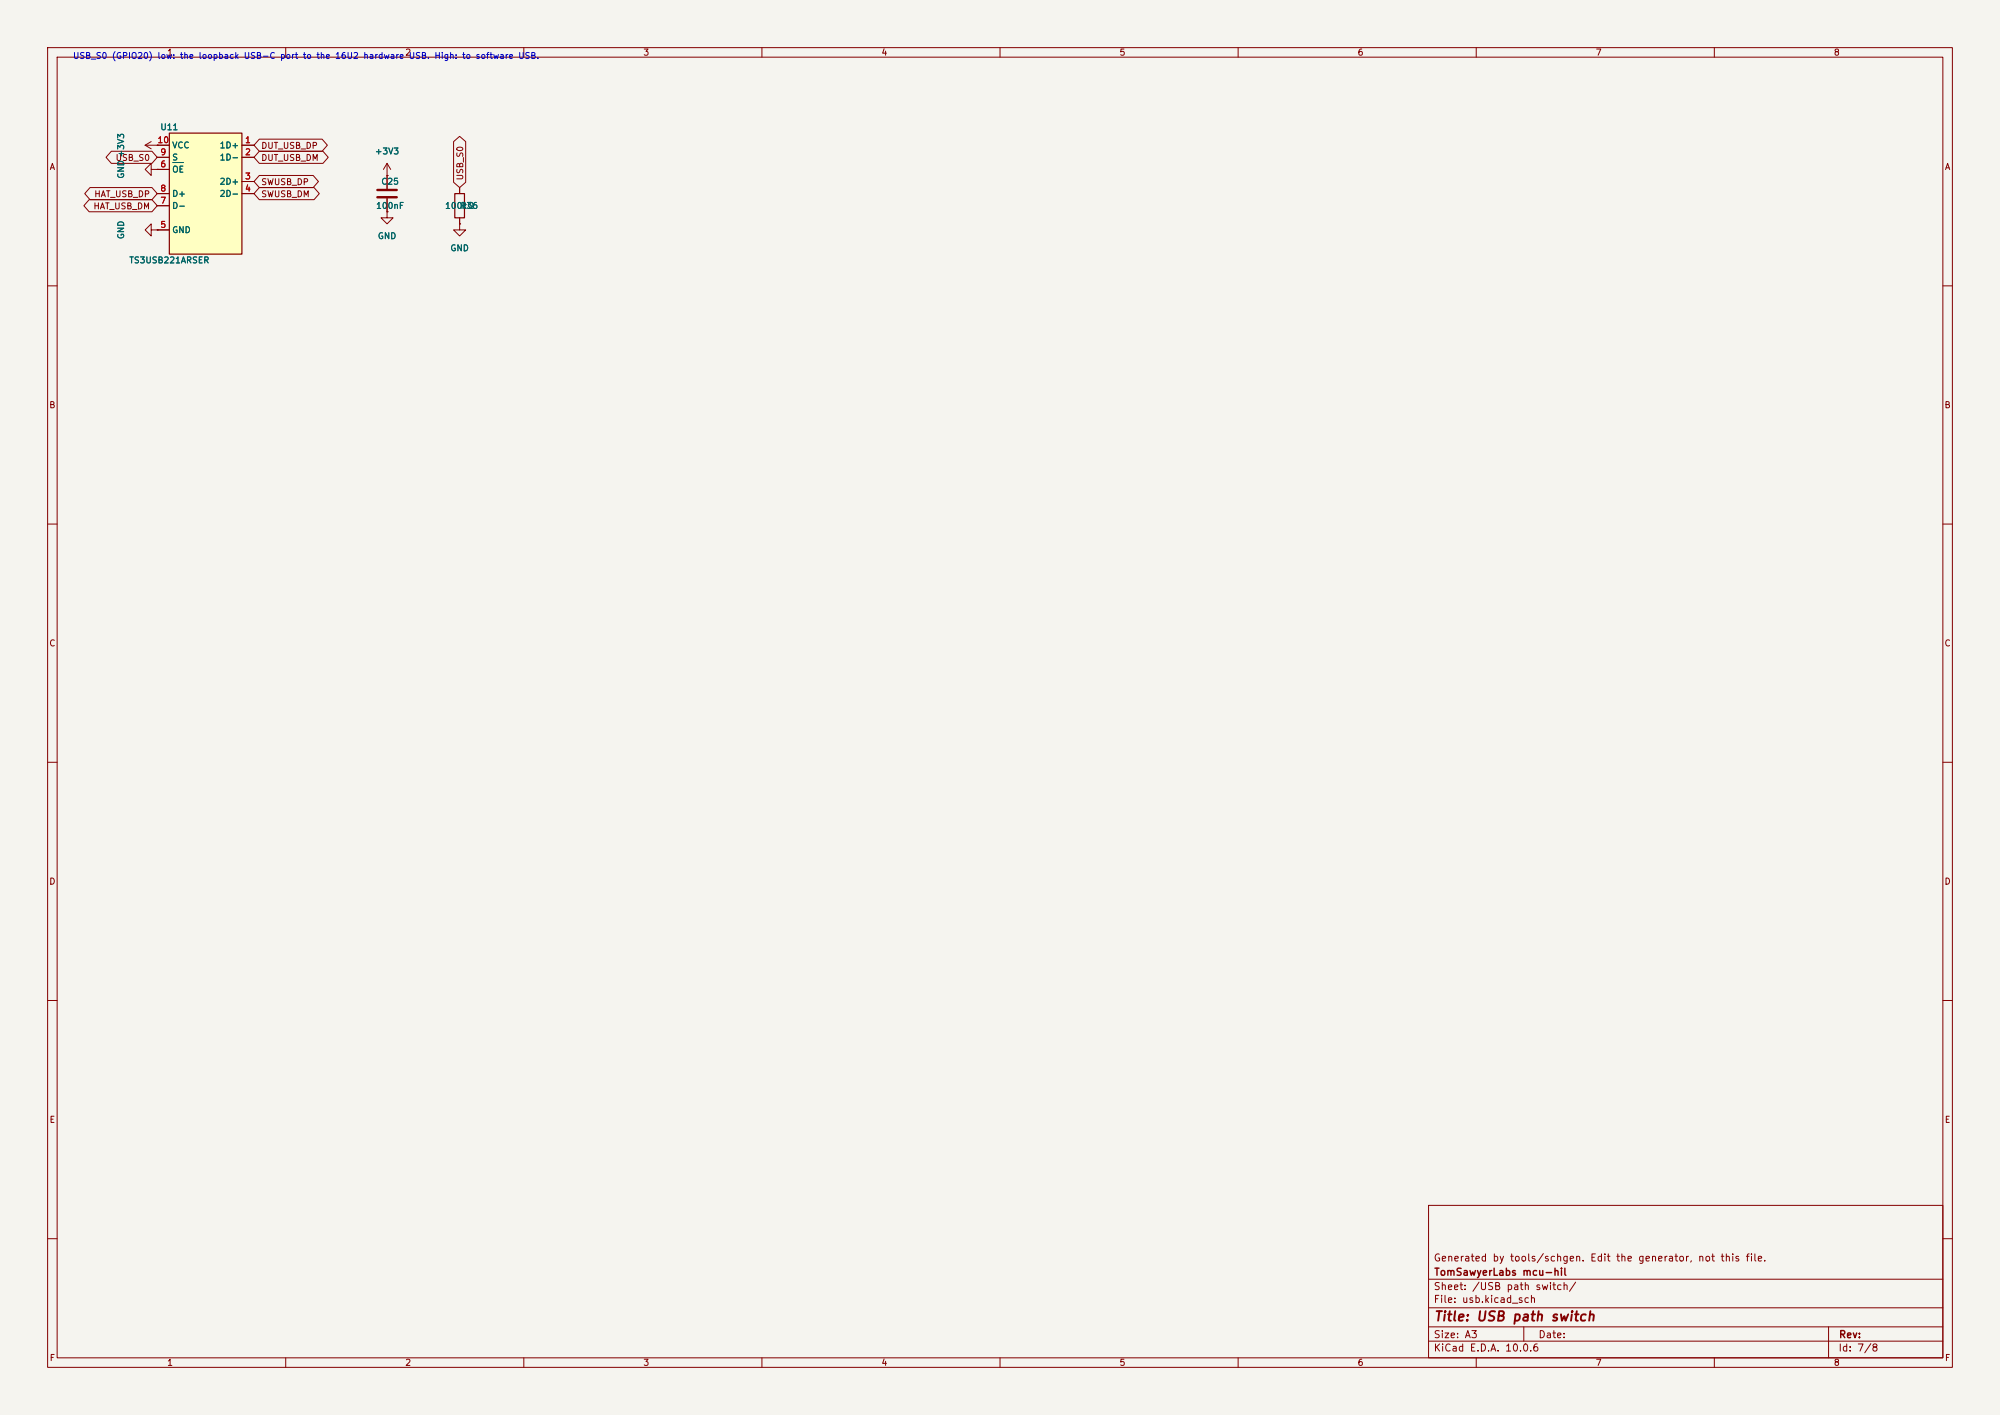
[picture p30: page 7]

TomSawyerLabs mcu-hil
Sheet: /USB path switch/
File: usb.kicad_sch
Title: USB path switch

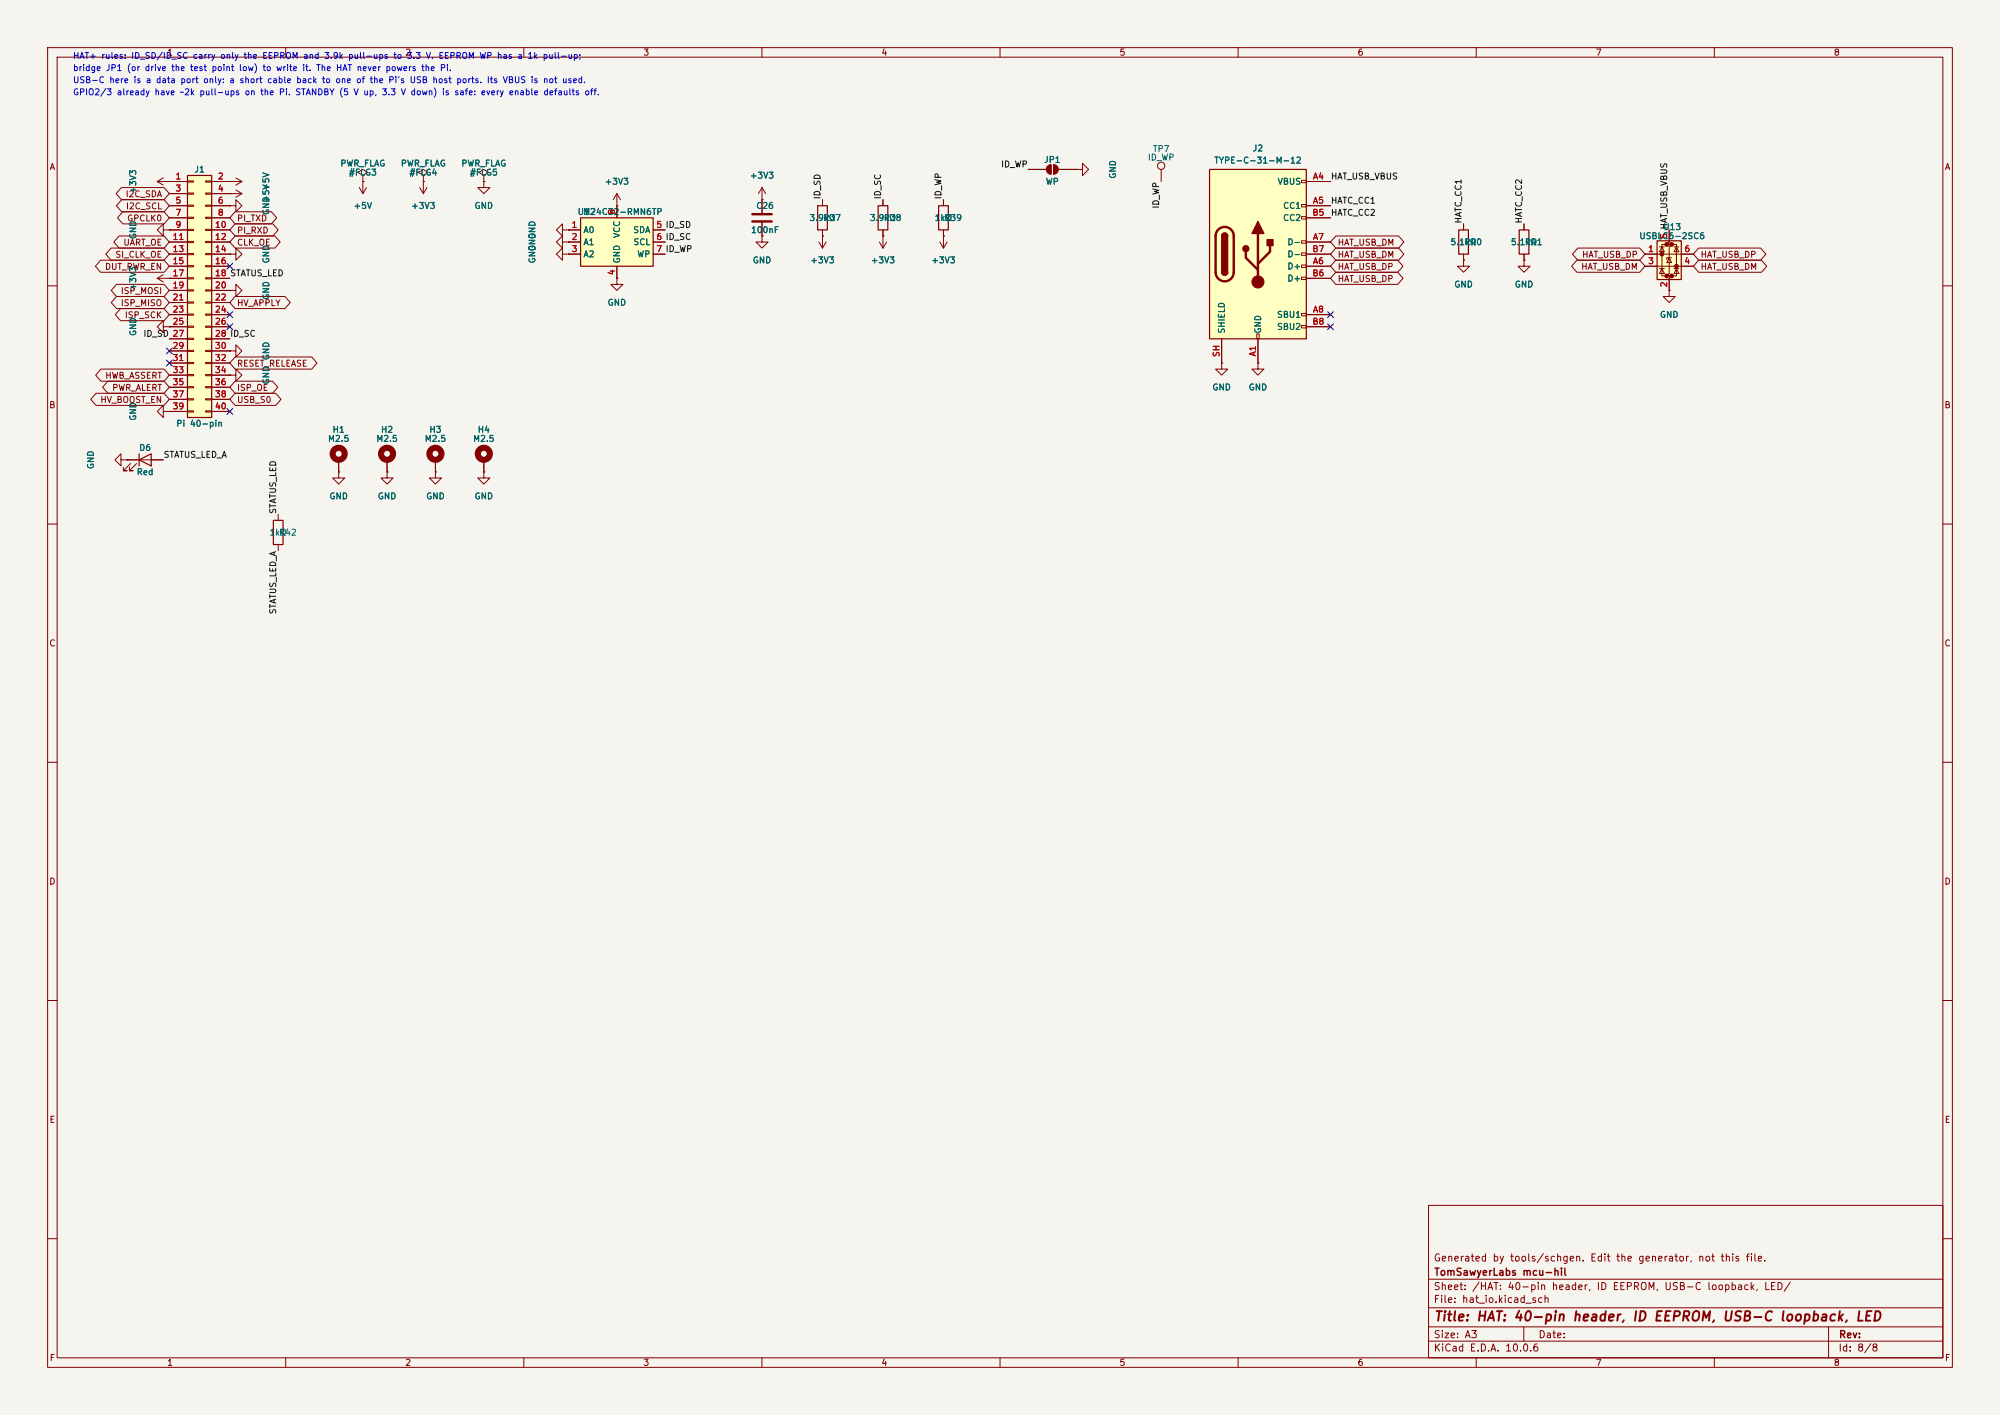
[picture p31: page 8]

Generated by tools/schgen. Edit the generator, not this file.
TomSawyerLabs mcu-hil
Sheet: /HAT: 40-pin header, ID EEPROM, USB-C loopback, LED/
File: hat_io.kicad_sch
Title: HAT: 40-pin header, ID EEPROM, USB-C loopback, LED
