TomSawyerLabs/mcu-hil/reference/v1-import/v1.kicad_pcb

## KiCad design reference/v1-import/v1.kicad_pcb (2026-11-11)

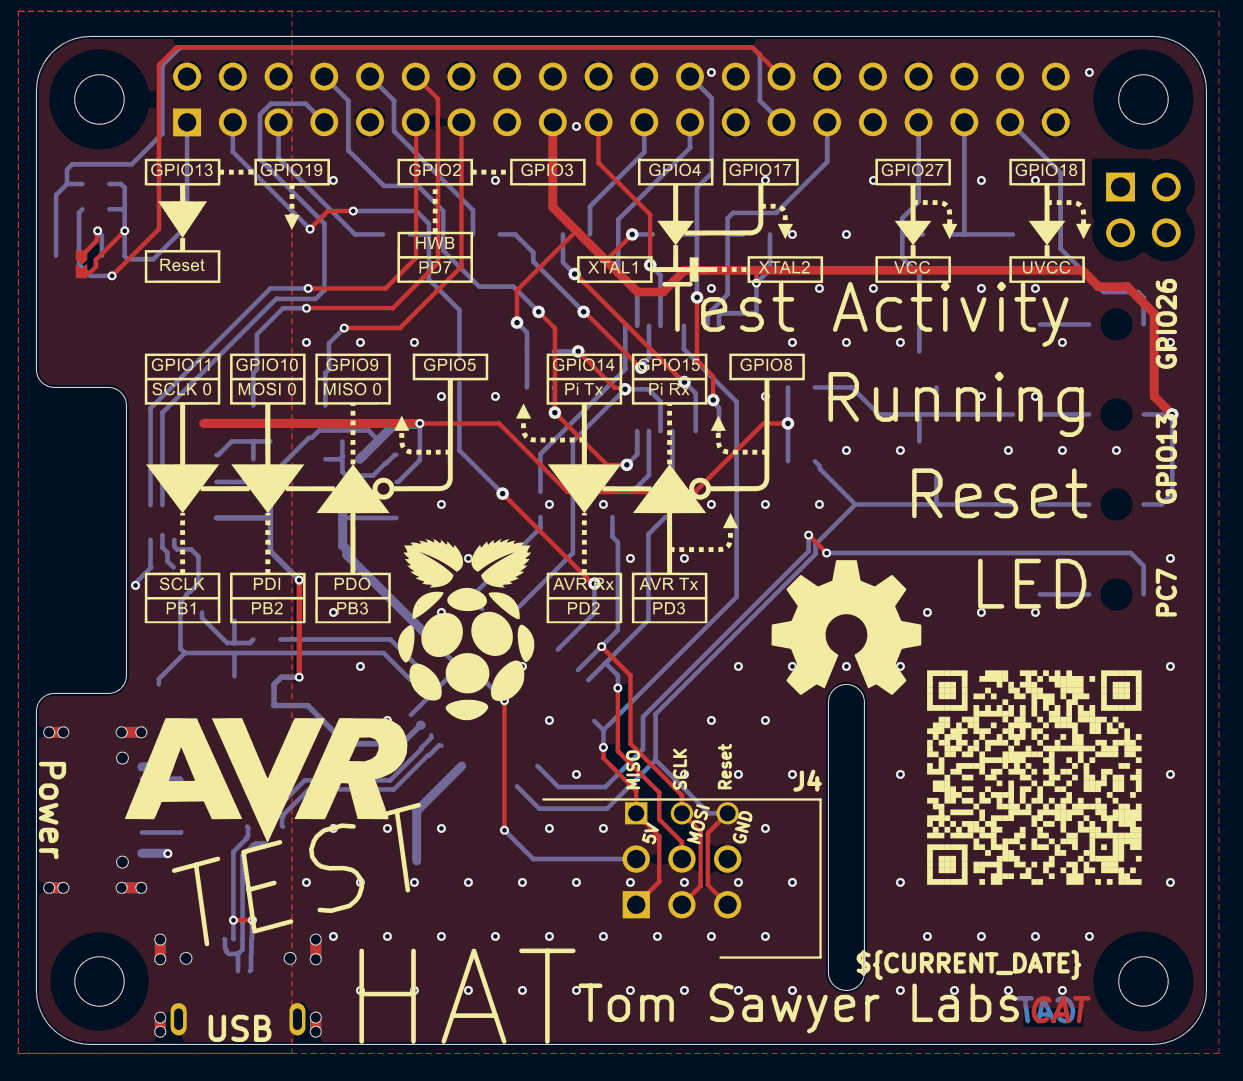
[picture p32: board v1.kicad_pcb from above]

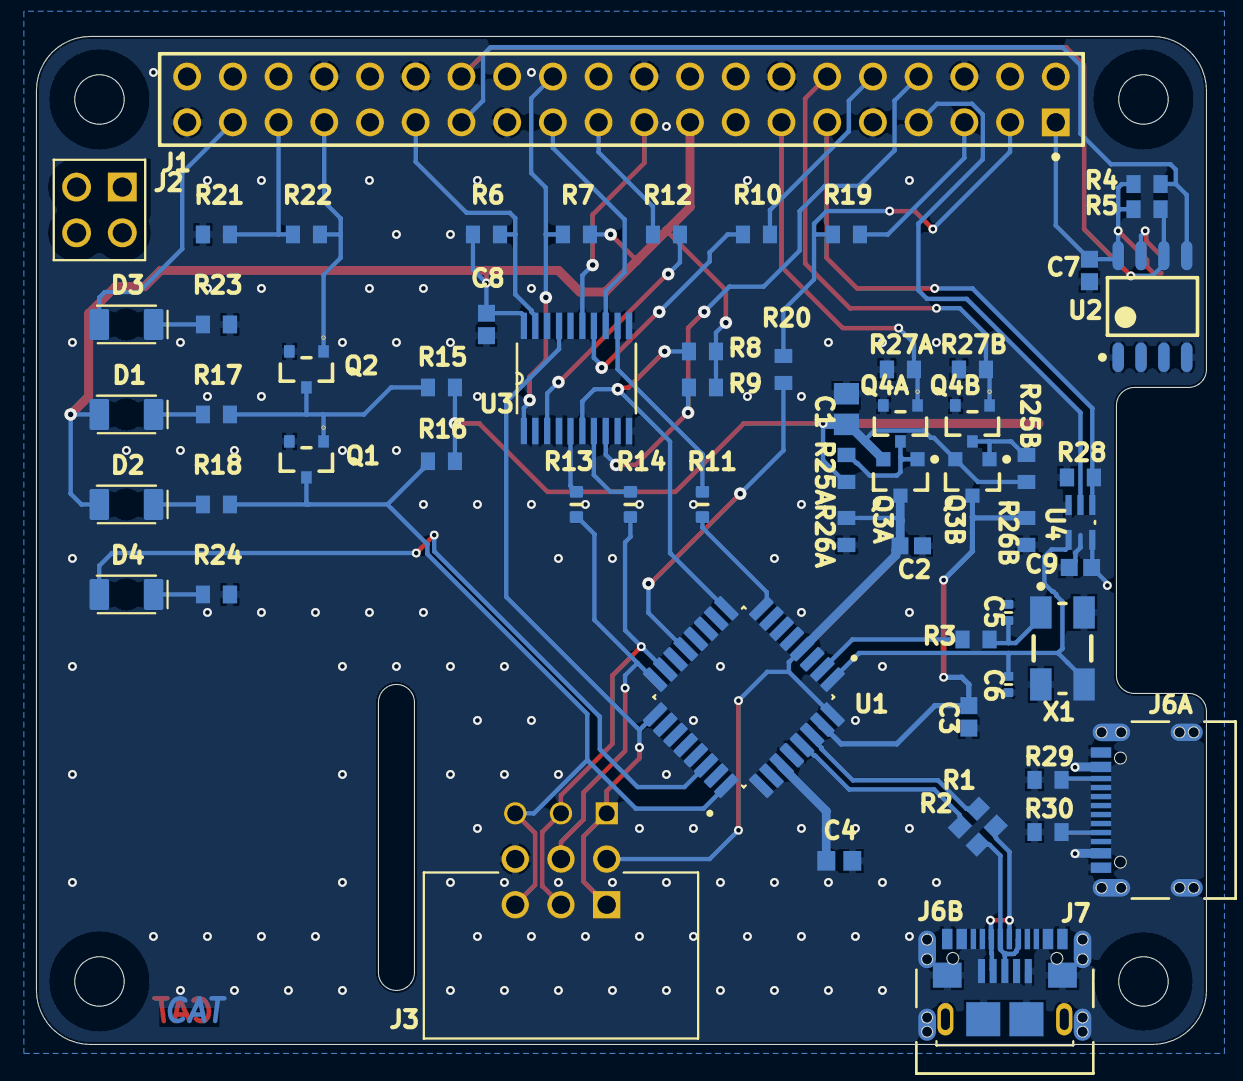
[picture p33: board v1.kicad_pcb from below]

Board: 2 copper layers, 65.0 x 56.0 mm, 65 parts (63 on the bottom side), 57 nets.

Parts:
C1: Capacitor 10 uF +/- 10% 16 V 0805; CAPC2013X135X45NL10T25
C2, C3, C7, C8, C9: Capacitor 100 nF +/-10% 50 V 0603; CAPC1608X90X40NL10T20
C4: Capacitor 1uF +/- 10% 16V 0603; CAPC1608X90X35ML15T15
C5, C6: Capacitor 12pF +/-10% 50V 0402; CAPC0402(1005)33_L
D1, D2, D3, D4: LTST-C230KFKT; LEDC3216X110
J1: Harwin M20-7832046; PCB-677180-1
J2: PPPC022LFBN-RC; SULLINS_PPPC022LFBN-RC
J3: 2-1761605-1; TE_2-1761605-1
J4: 30306-6002HB; 3M_30306-6002HB
J5: JUMPER
J6A, J6B: USB4105-GF-A; USB4105_GCT
J7: 10118193-0001LF; AMPHENOL_10118193-0001LF
Q1, Q2, Q4A, Q4B: 2N7002,215; NXP-SOT23-3_V
Q3A, Q3B: CJ2305; JSCJ-SOT23-3_V
R1, R2: Resistor 22R +/-1% 0603 100 mW; RESC1609X50X30ML08T20
R3, R4, R5, R6, R7, R8, R9, R10, R12, R15, R16, R17, R18, R19, R20, R21, R22, R23, R24, R25A, R25B, R26A, R26B, R27A, R27B, R28, R29, R30: Resistor 1k +/-1% 0603 100 mW; RESC1608X55X25ML10T15
R11, R13, R14: Resistor 120R +/-5 % 0603 0.1 W; RESC0603(1608)_L
U1: ATMEGA16U2-AU; QFP80P900X900X120-32N
U2: CAT24C32WI-GT3; ONSC-SOIC-8-751BD-01_M
U3: 74LVC244APW,118; SOP65P640X110-20N
U4: 74AHCT1G126SE-7; SOT65P210X110-5N
X1: ABM3B-16.000MHZ-B2-T; ABRA-ABM3B-4_V

Connections:
3V3: C7.2, C8.2, D1.A, D2.A, J1.1, J1.17, J5.2, R4.2, R5.2, R6.2, R7.2, R8.2, R9.2, U2.8, U3.20
5V: C1.1, C9.2, J1.2, J1.4, J6A.A4-B9, J6A.B4-A9, Q3A.2, Q3B.2, R15.2, R16.2, R25A.2, R25B.2, U4.5
AVR Activity: D4.A, U1.22
AVR Clock: C6.2, U1.1, U4.4, X1.3
AVR Rx: R11.2, U1.8
AVR Tx: R8.1, U1.9, U3.6
AVR USB Enable: J1.12, Q4B.1, R27B.2
AVR VCC Enable: J1.13, Q4A.1, R27A.2
A_N: R1.2, U1.30
A_P: R2.2, U1.29
Clock Override: J1.7, U4.2
Clock Override Enable: J1.11, R28.2, U4.1
DA_N: J6A.A7, J6A.B7
DA_P: J6A.A6, J6A.B6
DB_N: J6B.A7, J6B.B7, J7.2, R1.1
DB_P: J6B.A6, J6B.B6, J7.3, R2.1
Device_MISO: J3.1, J4.1, U1.17, U3.17
Device_MOSI: J3.4, J4.4, R13.2, U1.16
Device_SCLK: J3.3, J4.3, R14.2, U1.15
GND: C1.2, C2.1, C3.1, C4.2, C5.1, C6.1, C7.1, C8.1, C9.1, J1.6, J1.9, J1.14, J1.20, J1.25, J1.30, J1.34, J1.39, J3.6, J4.6, J6A.A1-B12, J6A.B1-A12, J6B.A1-B12, J6B.B1-A12, J7.5, J7.S1, J7.S2, J7.S3, J7.S4, J7.S5, J7.S6, Q1.2, Q2.2, Q4A.2, Q4B.2, R21.1, R23.1, R24.1, R26A.1, R26B.1, R27A.1, R27B.1, R28.1, R29.1, R30.1, U1.3, U1.28, U2.1, U2.2, U2.3, U2.4, U3.2, U3.4, U3.10, U3.11, U4.3, X1.2, X1.4
GPIO2: J1.3, R19.1, R20.2
GPIO3: J1.5, R19.2
GPIO5: J1.29, R6.1, U3.19
GPIO8: J1.24, R7.1, U3.1
GPIO9: J1.21, R12.1
GPIO10: J1.19, U3.15
GPIO11: J1.23, U3.13
GPIO13: J1.33, Q2.1, R22.1
GPIO14: J1.8, R9.1, U3.8
GPIO15: J1.10, R10.1
GPIO19: J1.35, R21.2, R22.2
GPIO26: D3.A, J1.37
HWB: R20.1, U1.13
ID_SC: J1.28, R5.1, U2.6
ID_SD: J1.27, R4.1, U2.5
NetC4_1: C4.1, U1.27
NetC5_2: C5.2, R3.1, X1.1
NetD1_C: D1.C, R17.2
NetD2_C: D2.C, R18.2
NetD3_C: D3.C, R23.2
NetD4_C: D4.C, R24.2
NetJ5_1: J5.1, U2.7
NetJ6A_A5: J6A.A5, R30.2
NetJ6A_B5: J6A.B5, R29.2
NetJ6B_A4-B9: J6B.A4-B9, J6B.B4-A9
NetQ1_1: Q1.1, Q2.3, R15.1, R17.1
NetQ3A_1: Q3A.1, Q4A.3, R25A.1
NetQ3B_1: Q3B.1, Q4B.3, R25B.1
NetR3_2: R3.2, U1.2
NetR10_2: R10.2, U3.14
NetR11_1: R11.1, U3.12
NetR12_2: R12.2, U3.3
NetR13_1: R13.1, U3.5
NetR14_1: R14.1, U3.7
Reset: J3.5, J4.5, Q1.3, R16.1, R18.1, U1.24
UVCC: C3.2, Q3B.3, R26B.2, U1.31
VCC: C2.2, J3.2, J4.2, Q3A.3, R26A.2, U1.4, U1.32
