TomSawyerLabs/mcu-hil/hw/carrier/carrier_io.kicad_sch

## KiCad design hw/carrier/carrier_io.kicad_sch (2026-11-14)

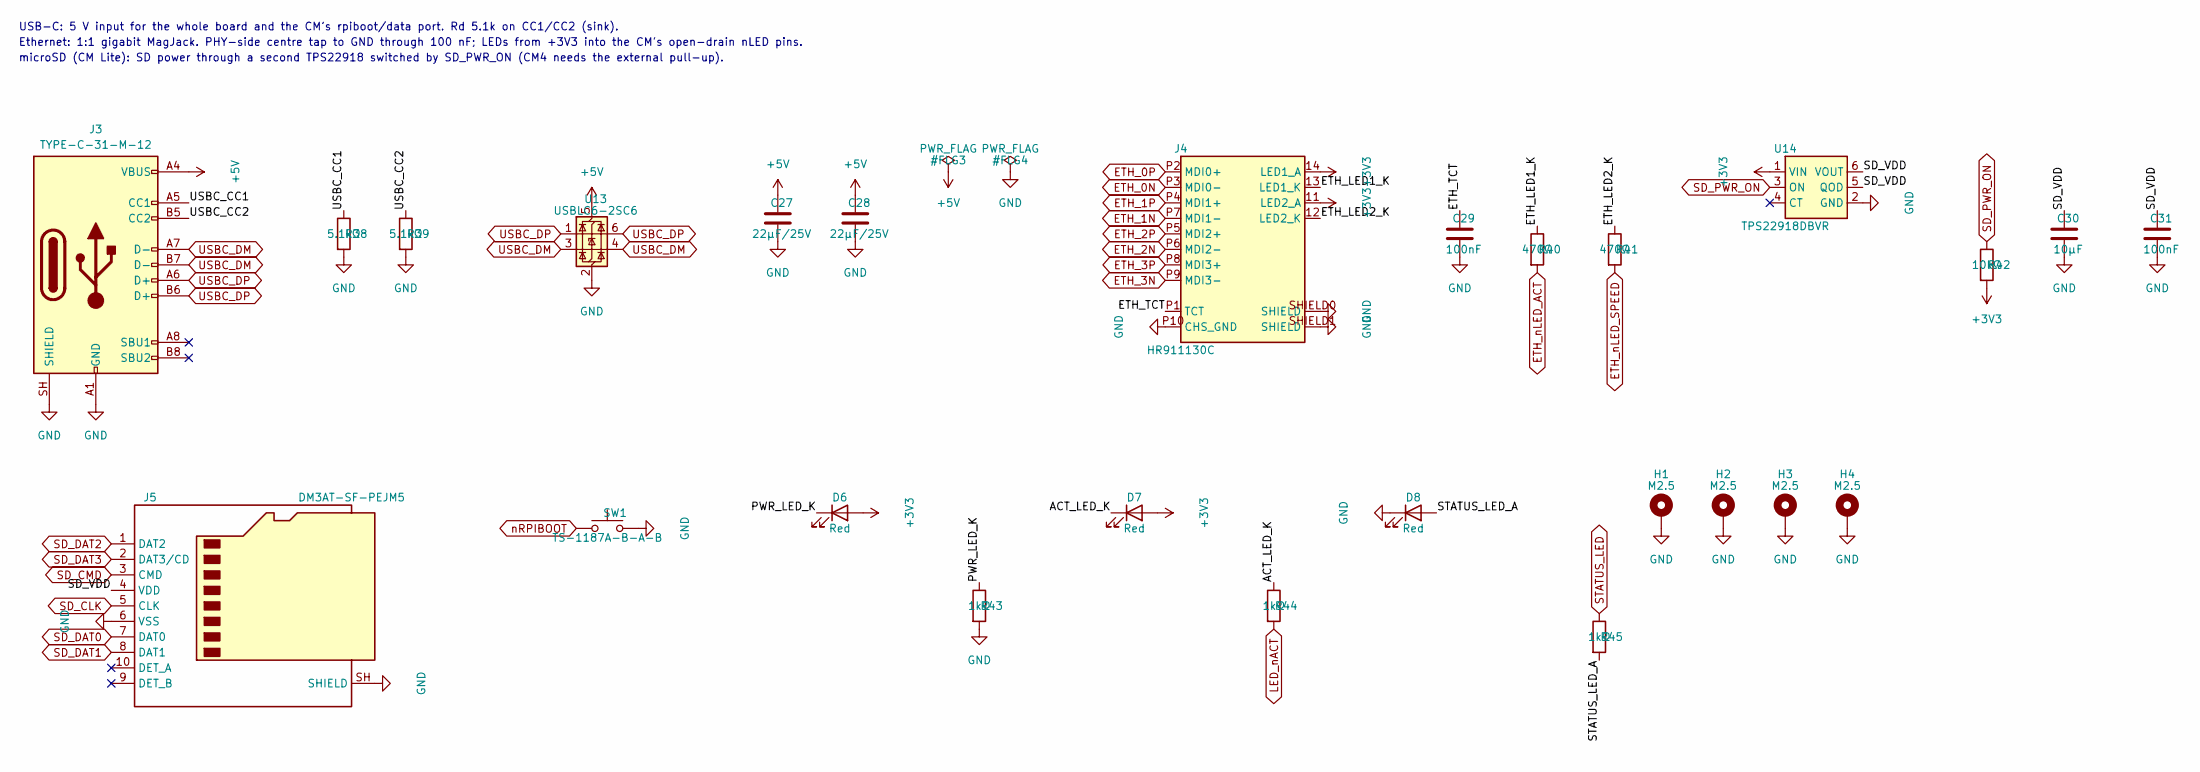
[picture p34: schematic carrier_io.kicad_sch]

Parts:
C27, C28: 22µF/25V; C_0805_2012Metric; LCSC C45783
C29, C31: 100nF; C_0402_1005Metric; LCSC C1525
C30: 10µF; C_0603_1608Metric; LCSC C19702
D6, D7, D8: Red; LED_0603_1608Metric; MPN KT-0603R; LCSC C2286
H1, H2, H3, H4: M2.5; MountingHole_2.7mm_M2.5_Pad
J3: TYPE-C-31-M-12; USB_C_Receptacle_HRO_TYPE-C-31-M-12; LCSC C165948
J4: HR911130C; LCSC C50933
J5: DM3AT-SF-PEJM5; microSD_HC_Hirose_DM3AT-SF-PEJM5; LCSC C114218
R38, R39: 5.1kΩ; R_0402_1005Metric; LCSC C25905
R40, R41: 470Ω; R_0402_1005Metric; LCSC C25117
R42: 10kΩ; R_0402_1005Metric; LCSC C25744
R43, R44, R45: 1kΩ; R_0402_1005Metric; LCSC C11702
SW1: TS-1187A-B-A-B; SW_Push_1P1T_XKB_TS-1187A; LCSC C318884
U13: USBLC6-2SC6; LCSC C7519
U14: TPS22918DBVR; LCSC C131941

Connections:
+3V3: D6.2 (A), D7.2 (A), J4.11 (LED2_A), J4.14 (LED1_A), R42.2, U14.1 (VIN)
+5V: C27.1, C28.1, J3.A4 (VBUS), J3.A9 (VBUS), J3.B4 (VBUS), J3.B9 (VBUS), U13.5 (VBUS)
ACT_LED_K: D7.1 (K), R44.1
ETH_0N: J4.P3 (MDI0-)
ETH_0P: J4.P2 (MDI0+)
ETH_1N: J4.P7 (MDI1-)
ETH_1P: J4.P4 (MDI1+)
ETH_2N: J4.P6 (MDI2-)
ETH_2P: J4.P5 (MDI2+)
ETH_3N: J4.P9 (MDI3-)
ETH_3P: J4.P8 (MDI3+)
ETH_LED1_K: J4.13 (LED1_K), R40.1
ETH_LED2_K: J4.12 (LED2_K), R41.1
ETH_TCT: C29.1, J4.P1 (TCT)
ETH_nLED_ACT: R40.2
ETH_nLED_SPEED: R41.2
GND: C27.2, C28.2, C29.2, C30.2, C31.2, D8.1 (K), H1.1, H2.1, H3.1, H4.1, J3.A1 (GND), J3.A12 (GND), J3.B1 (GND), J3.B12 (GND), J3.SH (SHIELD), J4.P10 (CHS_GND), J4.SHIELD0 (SHIELD), J4.SHIELD1 (SHIELD), J5.6 (VSS), J5.SH (SHIELD), R38.2, R39.2, R43.2, SW1.2, U13.2 (GND), U14.2 (GND)
LED_nACT: R44.2
PWR_LED_K: D6.1 (K), R43.1
SD_CLK: J5.5 (CLK)
SD_CMD: J5.3 (CMD)
SD_DAT0: J5.7 (DAT0)
SD_DAT1: J5.8 (DAT1)
SD_DAT2: J5.1 (DAT2)
SD_DAT3: J5.2 (DAT3/CD)
SD_PWR_ON: R42.1, U14.3 (ON)
SD_VDD: C30.1, C31.1, J5.4 (VDD), U14.5 (QOD), U14.6 (VOUT)
STATUS_LED: R45.1
STATUS_LED_A: D8.2 (A), R45.2
USBC_CC1: J3.A5 (CC1), R38.1
USBC_CC2: J3.B5 (CC2), R39.1
USBC_DM: J3.A7 (D-), J3.B7 (D-), U13.3 (I/O2), U13.4 (I/O2)
USBC_DP: J3.A6 (D+), J3.B6 (D+), U13.1 (I/O1), U13.6 (I/O1)
nRPIBOOT: SW1.1

Notes on the sheet:
USB-C: 5 V input for the whole board and the CM's rpiboot/data port. Rd 5.1k on CC1/CC2 (sink).
Ethernet: 1:1 gigabit MagJack. PHY-side centre tap to GND through 100 nF; LEDs from +3V3 into the CM's open-drain nLED pins.
microSD (CM Lite): SD power through a second TPS22918 switched by SD_PWR_ON (CM4 needs the external pull-up).
