TomSawyerLabs/mcu-hil/hw/carrier/clock.kicad_sch

## KiCad design hw/carrier/clock.kicad_sch (2026-11-13)

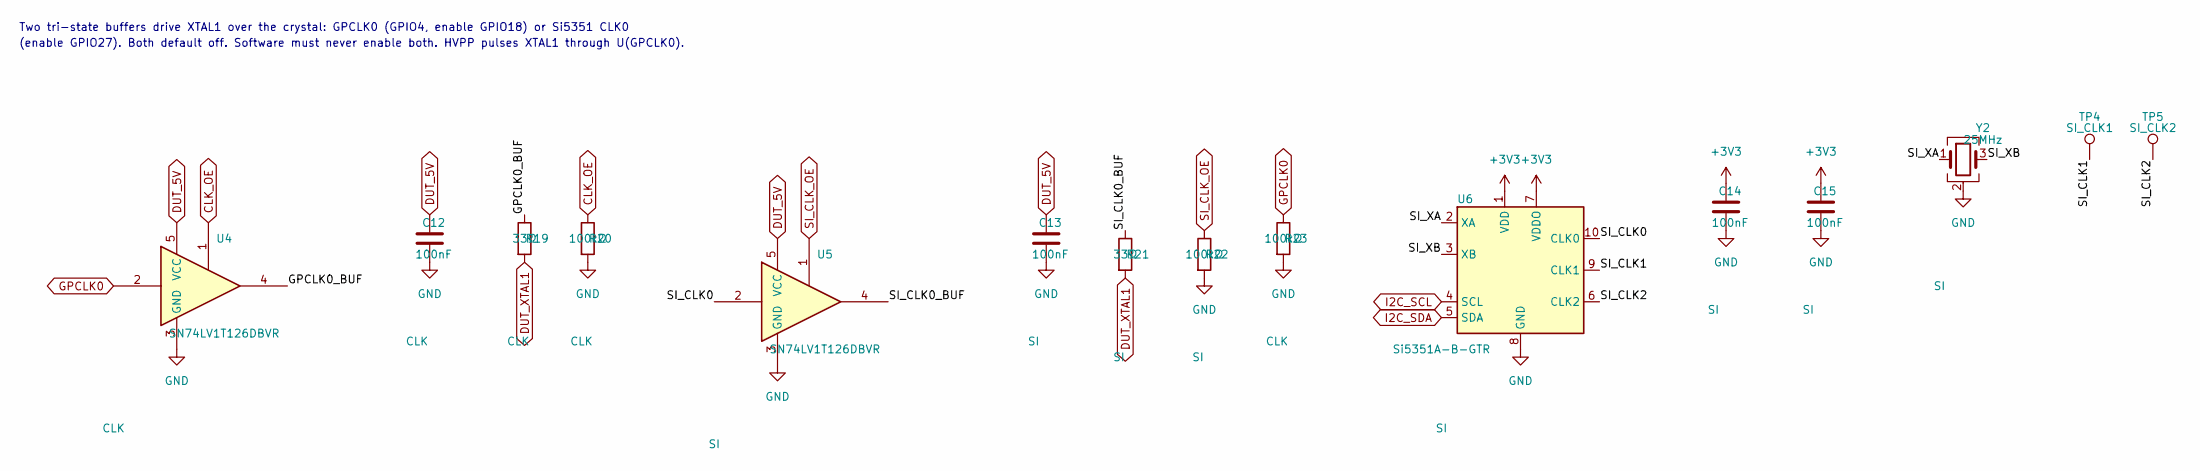
[picture p35: schematic clock.kicad_sch]

Parts:
C12, C13, C14, C15: 100nF; C_0402_1005Metric; LCSC C1525
R19, R21: 33Ω; R_0402_1005Metric; LCSC C25105
R20, R22, R23: 100kΩ; R_0402_1005Metric; LCSC C25741
TP4: SI_CLK1; TestPoint_Pad_D1.0mm
TP5: SI_CLK2; TestPoint_Pad_D1.0mm
U4, U5: SN74LV1T126DBVR; SOT-23-5; LCSC C2440228
U6: Si5351A-B-GTR; LCSC C504891
Y2: 25MHz; Crystal_SMD_3225-4Pin_3.2x2.5mm; MPN NX3225SA-25MHZ; LCSC C448646

Connections:
+3V3: C14.1, C15.1, U6.1 (VDD), U6.7 (VDDO)
CLK_OE: R20.1, U4.1
DUT_5V: C12.1, C13.1, U4.5 (VCC), U5.5 (VCC)
DUT_XTAL1: R19.2, R21.2
GND: C12.2, C13.2, C14.2, C15.2, R20.2, R22.2, R23.2, U4.3 (GND), U5.3 (GND), U6.8 (GND), Y2.2 (G), Y2.4 (G)
GPCLK0: R23.1, U4.2
GPCLK0_BUF: R19.1, U4.4
I2C_SCL: U6.4 (SCL)
I2C_SDA: U6.5 (SDA)
SI_CLK0: U5.2, U6.10 (CLK0)
SI_CLK0_BUF: R21.1, U5.4
SI_CLK1: TP4.1, U6.9 (CLK1)
SI_CLK2: TP5.1, U6.6 (CLK2)
SI_CLK_OE: R22.1, U5.1
SI_XA: U6.2 (XA), Y2.1
SI_XB: U6.3 (XB), Y2.3

Notes on the sheet:
Two tri-state buffers drive XTAL1 over the crystal: GPCLK0 (GPIO4, enable GPIO18) or Si5351 CLK0
(enable GPIO27). Both default off. Software must never enable both. HVPP pulses XTAL1 through U(GPCLK0).
