TomSawyerLabs/mcu-hil/hw/carrier/cm.kicad_sch

## KiCad design hw/carrier/cm.kicad_sch (2026-11-14)

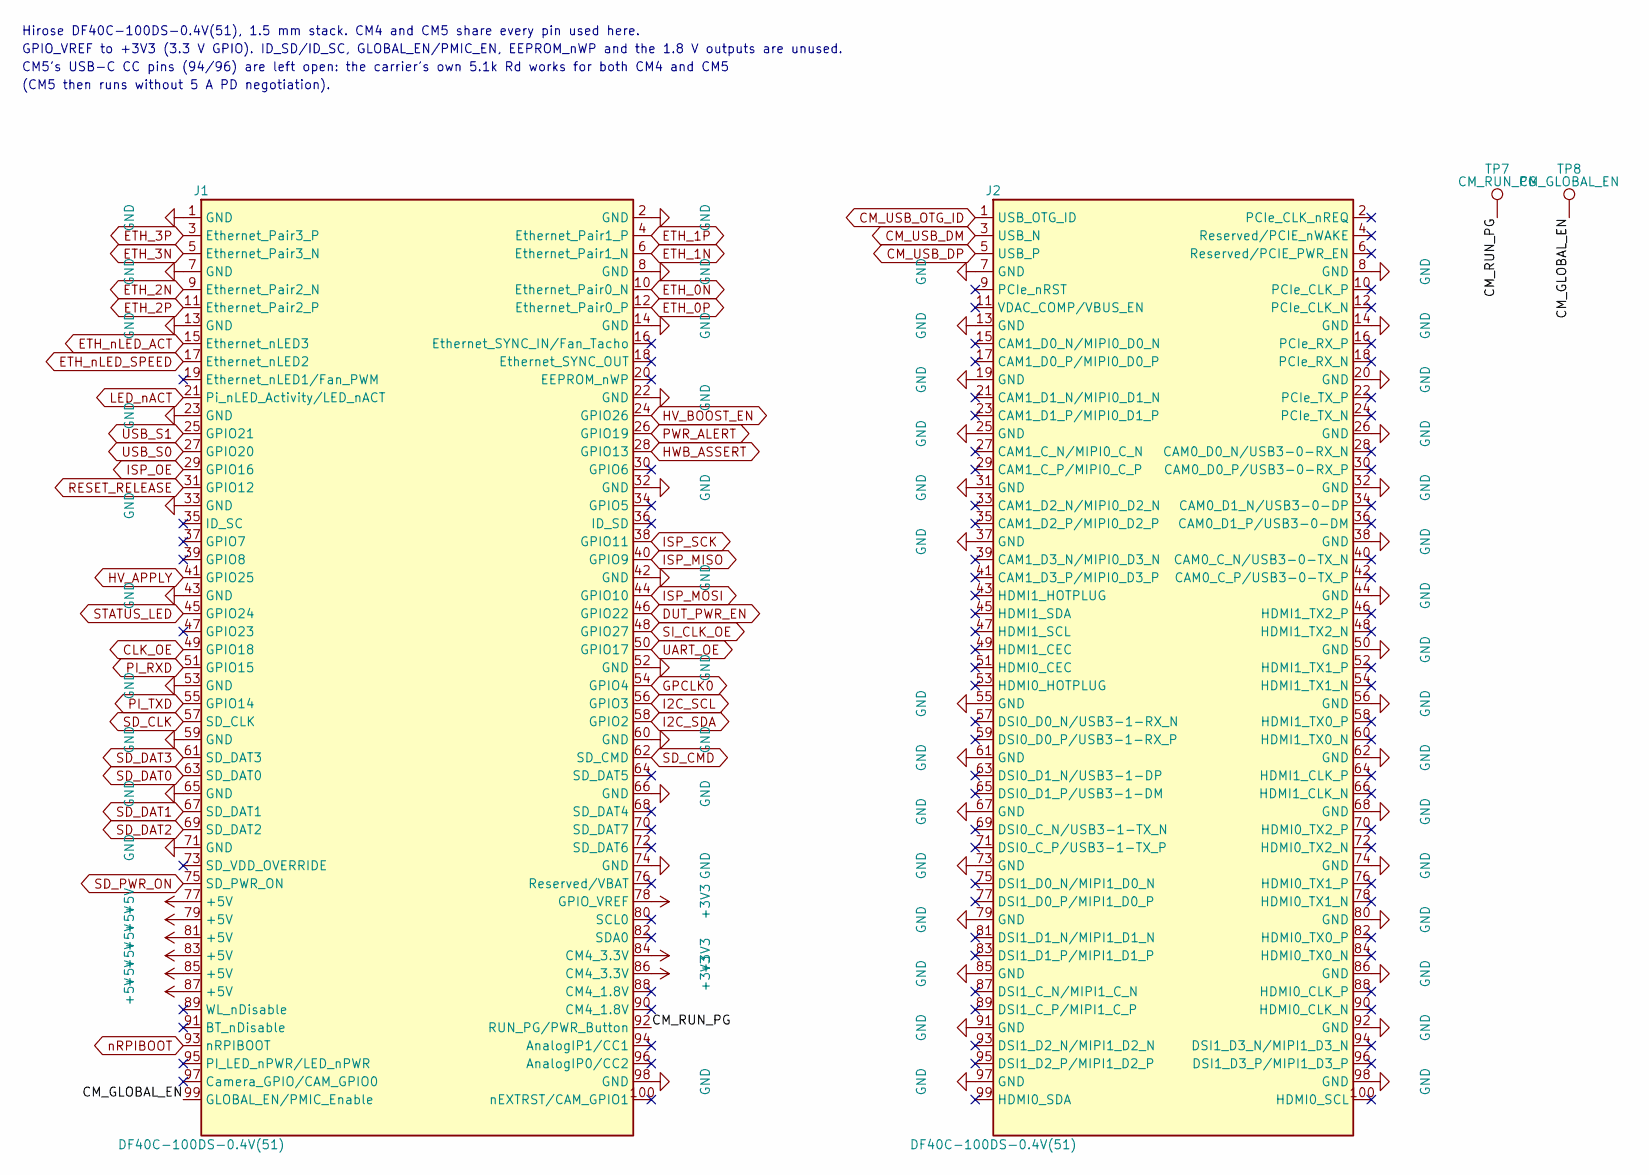
[picture p36: schematic cm.kicad_sch]

Parts:
J1, J2: DF40C-100DS-0.4V(51); MPN DF40C-100DS-0.4V(51); LCSC C597931
TP7: CM_RUN_PG; TestPoint_Pad_D1.0mm
TP8: CM_GLOBAL_EN; TestPoint_Pad_D1.0mm

Connections:
+3V3: J1.78 (GPIO_VREF), J1.84 (CM4_3.3V), J1.86 (CM4_3.3V)
+5V: J1.77 (+5V), J1.79 (+5V), J1.81 (+5V), J1.83 (+5V), J1.85 (+5V), J1.87 (+5V)
CLK_OE: J1.49 (GPIO18)
CM_GLOBAL_EN: J1.99 (GLOBAL_EN/PMIC_Enable), TP8.1
CM_RUN_PG: J1.92 (RUN_PG/PWR_Button), TP7.1
CM_USB_DM: J2.3 (USB_N)
CM_USB_DP: J2.5 (USB_P)
CM_USB_OTG_ID: J2.1 (USB_OTG_ID)
DUT_PWR_EN: J1.46 (GPIO22)
ETH_0N: J1.10 (Ethernet_Pair0_N)
ETH_0P: J1.12 (Ethernet_Pair0_P)
ETH_1N: J1.6 (Ethernet_Pair1_N)
ETH_1P: J1.4 (Ethernet_Pair1_P)
ETH_2N: J1.9 (Ethernet_Pair2_N)
ETH_2P: J1.11 (Ethernet_Pair2_P)
ETH_3N: J1.5 (Ethernet_Pair3_N)
ETH_3P: J1.3 (Ethernet_Pair3_P)
ETH_nLED_ACT: J1.15 (Ethernet_nLED3)
ETH_nLED_SPEED: J1.17 (Ethernet_nLED2)
GND: J1.1 (GND), J1.2 (GND), J1.7 (GND), J1.8 (GND), J1.13 (GND), J1.14 (GND), J1.22 (GND), J1.23 (GND), J1.32 (GND), J1.33 (GND), J1.42 (GND), J1.43 (GND), J1.52 (GND), J1.53 (GND), J1.59 (GND), J1.60 (GND), J1.65 (GND), J1.66 (GND), J1.71 (GND), J1.74 (GND), J1.98 (GND), J2.7 (GND), J2.8 (GND), J2.13 (GND), J2.14 (GND), J2.19 (GND), J2.20 (GND), J2.25 (GND), J2.26 (GND), J2.31 (GND), J2.32 (GND), J2.37 (GND), J2.38 (GND), J2.44 (GND), J2.50 (GND), J2.55 (GND), J2.56 (GND), J2.61 (GND), J2.62 (GND), J2.67 (GND), J2.68 (GND), J2.73 (GND), J2.74 (GND), J2.79 (GND), J2.80 (GND), J2.85 (GND), J2.86 (GND), J2.91 (GND), J2.92 (GND), J2.97 (GND), J2.98 (GND)
GPCLK0: J1.54 (GPIO4)
HV_APPLY: J1.41 (GPIO25)
HV_BOOST_EN: J1.24 (GPIO26)
HWB_ASSERT: J1.28 (GPIO13)
I2C_SCL: J1.56 (GPIO3)
I2C_SDA: J1.58 (GPIO2)
ISP_MISO: J1.40 (GPIO9)
ISP_MOSI: J1.44 (GPIO10)
ISP_OE: J1.29 (GPIO16)
ISP_SCK: J1.38 (GPIO11)
LED_nACT: J1.21 (Pi_nLED_Activity/LED_nACT)
PI_RXD: J1.51 (GPIO15)
PI_TXD: J1.55 (GPIO14)
PWR_ALERT: J1.26 (GPIO19)
RESET_RELEASE: J1.31 (GPIO12)
SD_CLK: J1.57 (SD_CLK)
SD_CMD: J1.62 (SD_CMD)
SD_DAT0: J1.63 (SD_DAT0)
SD_DAT1: J1.67 (SD_DAT1)
SD_DAT2: J1.69 (SD_DAT2)
SD_DAT3: J1.61 (SD_DAT3)
SD_PWR_ON: J1.75 (SD_PWR_ON)
SI_CLK_OE: J1.48 (GPIO27)
STATUS_LED: J1.45 (GPIO24)
UART_OE: J1.50 (GPIO17)
USB_S0: J1.27 (GPIO20)
USB_S1: J1.25 (GPIO21)
nRPIBOOT: J1.93 (nRPIBOOT)

Notes on the sheet:
Hirose DF40C-100DS-0.4V(51), 1.5 mm stack. CM4 and CM5 share every pin used here.
GPIO_VREF to +3V3 (3.3 V GPIO). ID_SD/ID_SC, GLOBAL_EN/PMIC_EN, EEPROM_nWP and the 1.8 V outputs are unused.
CM5's USB-C CC pins (94/96) are left open: the carrier's own 5.1k Rd works for both CM4 and CM5
(CM5 then runs without 5 A PD negotiation).
