TomSawyerLabs/mcu-hil/hw/carrier/dut.kicad_sch

## KiCad design hw/carrier/dut.kicad_sch (2026-11-13)

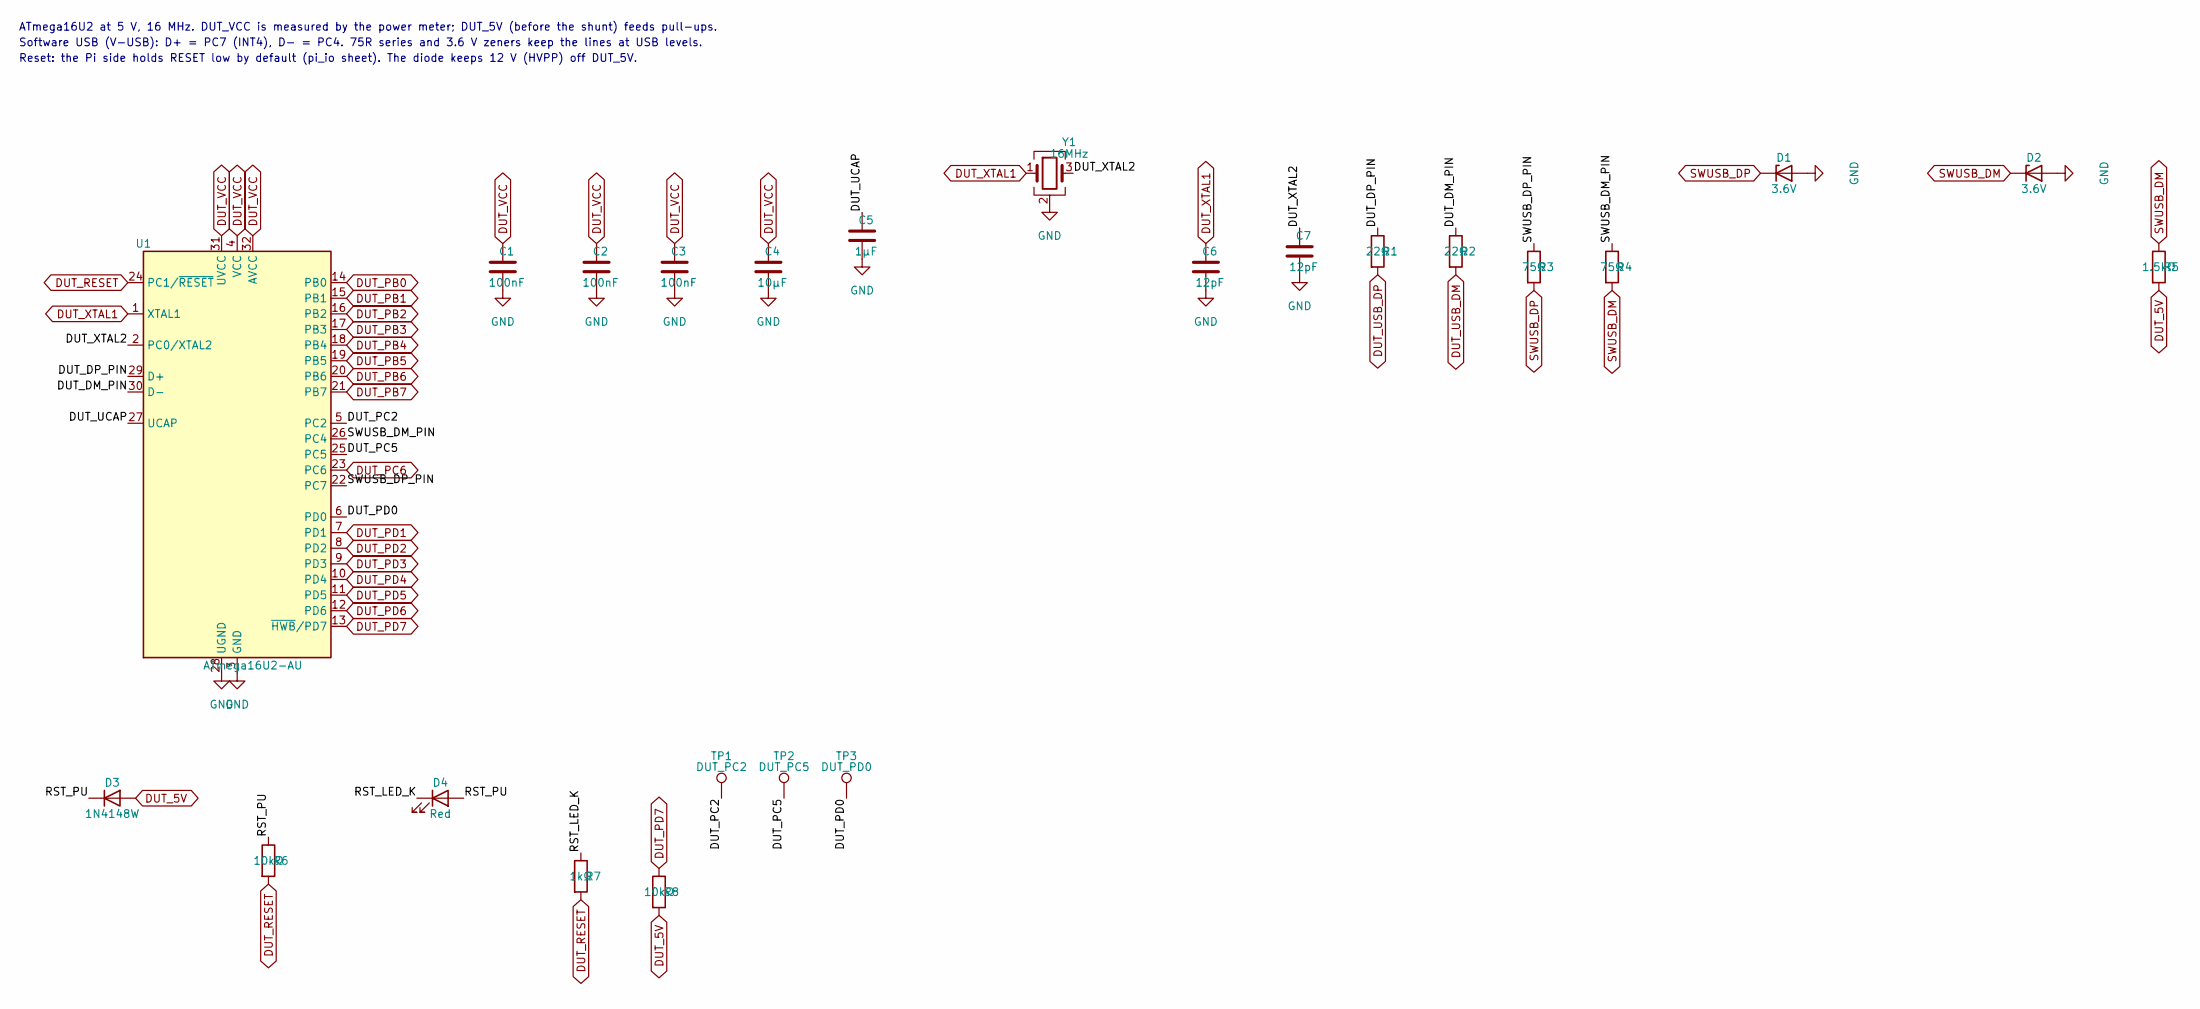
[picture p37: schematic dut.kicad_sch]

Parts:
C1, C2, C3: 100nF; C_0402_1005Metric; LCSC C1525
C4: 10µF; C_0603_1608Metric; LCSC C19702
C5: 1µF; C_0402_1005Metric; LCSC C52923
C6, C7: 12pF; C_0402_1005Metric; LCSC C1547
D1, D2: 3.6V; D_SOD-123; MPN BZT52C3V6; LCSC C173412
D3: 1N4148W; D_SOD-123; LCSC C81598
D4: Red; LED_0603_1608Metric; MPN KT-0603R; LCSC C2286
R1, R2: 22Ω; R_0402_1005Metric; LCSC C25092
R3, R4: 75Ω; R_0402_1005Metric; LCSC C25133
R5: 1.5kΩ; R_0402_1005Metric; LCSC C25867
R6, R8: 10kΩ; R_0402_1005Metric; LCSC C25744
R7: 1kΩ; R_0402_1005Metric; LCSC C11702
TP1: DUT_PC2; TestPoint_Pad_D1.0mm
TP2: DUT_PC5; TestPoint_Pad_D1.0mm
TP3: DUT_PD0; TestPoint_Pad_D1.0mm
U1: ATmega16U2-AU; TQFP-32_7x7mm_P0.8mm; MPN ATMEGA16U2-AU; LCSC C59019
Y1: 16MHz; Crystal_SMD_3225-4Pin_3.2x2.5mm; MPN X322516MLB4SI; LCSC C13738

Connections:
DUT_5V: D3.2 (A), R5.2, R8.2
DUT_DM_PIN: R2.1, U1.30 (D-)
DUT_DP_PIN: R1.1, U1.29 (D+)
DUT_PB0: U1.14 (PB0)
DUT_PB1: U1.15 (PB1)
DUT_PB2: U1.16 (PB2)
DUT_PB3: U1.17 (PB3)
DUT_PB4: U1.18 (PB4)
DUT_PB5: U1.19 (PB5)
DUT_PB6: U1.20 (PB6)
DUT_PB7: U1.21 (PB7)
DUT_PC2: TP1.1, U1.5 (PC2)
DUT_PC5: TP2.1, U1.25 (PC5)
DUT_PC6: U1.23 (PC6)
DUT_PD0: TP3.1, U1.6 (PD0)
DUT_PD1: U1.7 (PD1)
DUT_PD2: U1.8 (PD2)
DUT_PD3: U1.9 (PD3)
DUT_PD4: U1.10 (PD4)
DUT_PD5: U1.11 (PD5)
DUT_PD6: U1.12 (PD6)
DUT_PD7: R8.1, U1.13 (~HWB/PD7)
DUT_RESET: R6.2, R7.2, U1.24 (PC1/~RESET)
DUT_UCAP: C5.1, U1.27 (UCAP)
DUT_USB_DM: R2.2
DUT_USB_DP: R1.2
DUT_VCC: C1.1, C2.1, C3.1, C4.1, U1.4 (VCC), U1.31 (UVCC), U1.32 (AVCC)
DUT_XTAL1: C6.1, U1.1 (XTAL1), Y1.1
DUT_XTAL2: C7.1, U1.2 (PC0/XTAL2), Y1.3
GND: C1.2, C2.2, C3.2, C4.2, C5.2, C6.2, C7.2, D1.2 (A), D2.2 (A), U1.3 (GND), U1.28 (UGND), Y1.2 (G), Y1.4 (G)
RST_LED_K: D4.1 (K), R7.1
RST_PU: D3.1 (K), D4.2 (A), R6.1
SWUSB_DM: D2.1 (K), R4.2, R5.1
SWUSB_DM_PIN: R4.1, U1.26 (PC4)
SWUSB_DP: D1.1 (K), R3.2
SWUSB_DP_PIN: R3.1, U1.22 (PC7)

Notes on the sheet:
ATmega16U2 at 5 V, 16 MHz. DUT_VCC is measured by the power meter; DUT_5V (before the shunt) feeds pull-ups.
Software USB (V-USB): D+ = PC7 (INT4), D- = PC4. 75R series and 3.6 V zeners keep the lines at USB levels.
Reset: the Pi side holds RESET low by default (pi_io sheet). The diode keeps 12 V (HVPP) off DUT_5V.
