TomSawyerLabs/mcu-hil/hw/carrier/dut_power.kicad_sch

## KiCad design hw/carrier/dut_power.kicad_sch (2026-11-14)

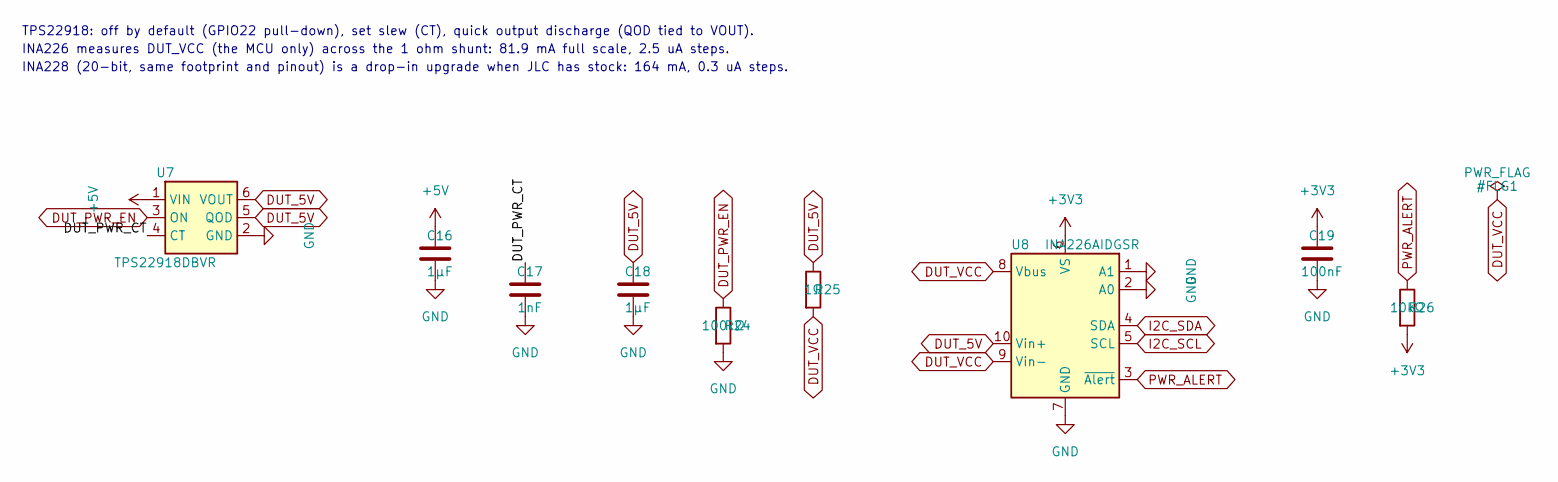
[picture p38: schematic dut_power.kicad_sch]

Parts:
C16, C18: 1µF; C_0402_1005Metric; LCSC C52923
C17: 1nF; C_0402_1005Metric; LCSC C1523
C19: 100nF; C_0402_1005Metric; LCSC C1525
R24: 100kΩ; R_0402_1005Metric; LCSC C25741
R25: 1Ω; R_0603_1608Metric; MPN 0603WAF100KT5E; LCSC C22936
R26: 10kΩ; R_0402_1005Metric; LCSC C25744
U7: TPS22918DBVR; LCSC C131941
U8: INA226AIDGSR; MSOP-10_3x3mm_P0.5mm; LCSC C49851

Connections:
+3V3: C19.1, R26.2, U8.6 (VS)
+5V: C16.1, U7.1 (VIN)
DUT_5V: C18.1, R25.1, U7.5 (QOD), U7.6 (VOUT), U8.10 (Vin+)
DUT_PWR_CT: C17.1, U7.4 (CT)
DUT_PWR_EN: R24.1, U7.3 (ON)
DUT_VCC: R25.2, U8.8 (Vbus), U8.9 (Vin-)
GND: C16.2, C17.2, C18.2, C19.2, R24.2, U7.2 (GND), U8.1 (A1), U8.2 (A0), U8.7 (GND)
I2C_SCL: U8.5 (SCL)
I2C_SDA: U8.4 (SDA)
PWR_ALERT: R26.1, U8.3 (~Alert)

Notes on the sheet:
TPS22918: off by default (GPIO22 pull-down), set slew (CT), quick output discharge (QOD tied to VOUT).
INA226 measures DUT_VCC (the MCU only) across the 1 ohm shunt: 81.9 mA full scale, 2.5 uA steps.
INA228 (20-bit, same footprint and pinout) is a drop-in upgrade when JLC has stock: 164 mA, 0.3 uA steps.
