TomSawyerLabs/mcu-hil/hw/carrier/hv.kicad_sch

## KiCad design hw/carrier/hv.kicad_sch (2026-11-13)

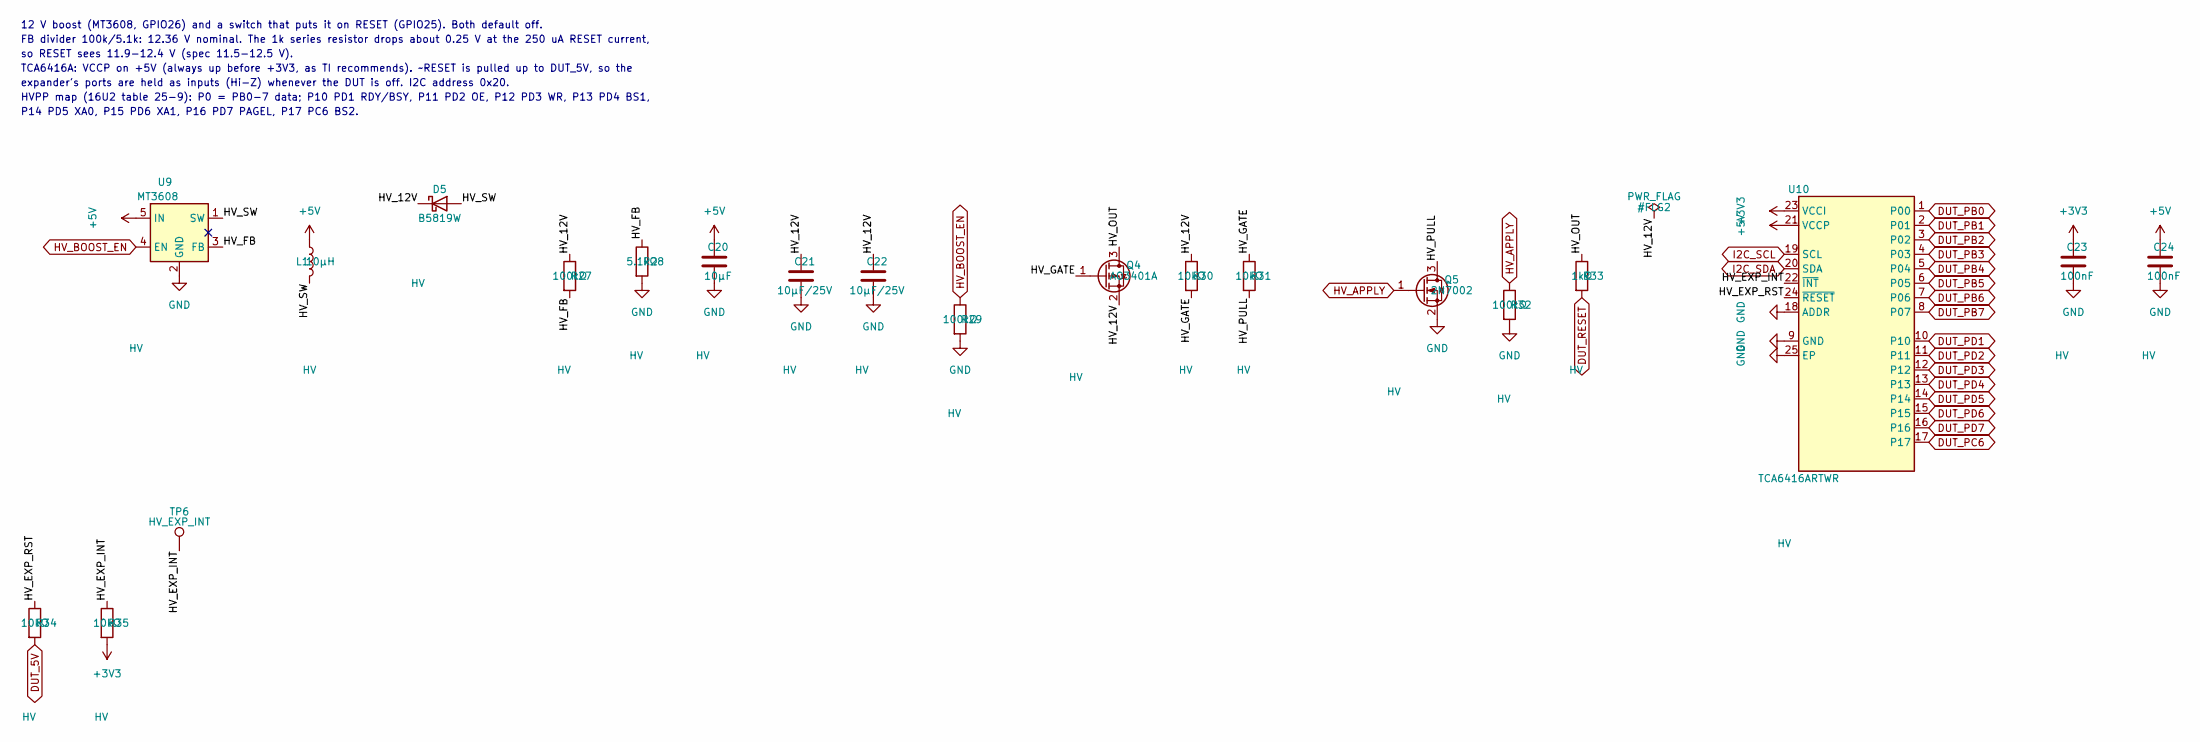
[picture p39: schematic hv.kicad_sch]

Parts:
C20: 10µF; C_0603_1608Metric; LCSC C19702
C21, C22: 10µF/25V; C_0805_2012Metric; LCSC C15850
C23, C24: 100nF; C_0402_1005Metric; LCSC C1525
D5: B5819W; D_SOD-123; LCSC C8598
L1: 10µH; L_Sunlord_SWPA4030; MPN SWPA4030S100MT; LCSC C38117
Q4: AO3401A; LCSC C15127
Q5: 2N7002; SOT-23; LCSC C8545
R27, R29, R32: 100kΩ; R_0402_1005Metric; LCSC C25741
R28: 5.1kΩ; R_0402_1005Metric; LCSC C25905
R30, R31, R34, R35: 10kΩ; R_0402_1005Metric; LCSC C25744
R33: 1kΩ; R_0402_1005Metric; LCSC C11702
TP6: HV_EXP_INT; TestPoint_Pad_D1.0mm
U9: MT3608; LCSC C84817
U10: TCA6416ARTWR; LCSC C182336

Connections:
+3V3: C23.1, R35.2, U10.23 (VCCI)
+5V: C20.1, C24.1, L1.1, U9.5 (IN), U10.21 (VCCP)
DUT_5V: R34.2
DUT_PB0: U10.1 (P00)
DUT_PB1: U10.2 (P01)
DUT_PB2: U10.3 (P02)
DUT_PB3: U10.4 (P03)
DUT_PB4: U10.5 (P04)
DUT_PB5: U10.6 (P05)
DUT_PB6: U10.7 (P06)
DUT_PB7: U10.8 (P07)
DUT_PC6: U10.17
DUT_PD1: U10.10
DUT_PD2: U10.11
DUT_PD3: U10.12
DUT_PD4: U10.13
DUT_PD5: U10.14
DUT_PD6: U10.15
DUT_PD7: U10.16
DUT_RESET: R33.2
GND: C20.2, C21.2, C22.2, C23.2, C24.2, Q5.2 (S), R28.2, R29.2, R32.2, U9.2 (GND), U10.9 (GND), U10.18 (ADDR), U10.25 (EP)
HV_12V: C21.1, C22.1, D5.1 (K), Q4.2 (S), R27.1, R30.1
HV_APPLY: Q5.1 (G), R32.1
HV_BOOST_EN: R29.1, U9.4 (EN)
HV_EXP_INT: R35.1, TP6.1, U10.22 (~INT)
HV_EXP_RST: R34.1, U10.24 (~RESET)
HV_FB: R27.2, R28.1, U9.3 (FB)
HV_GATE: Q4.1 (G), R30.2, R31.1
HV_OUT: Q4.3 (D), R33.1
HV_PULL: Q5.3 (D), R31.2
HV_SW: D5.2 (A), L1.2, U9.1 (SW)
I2C_SCL: U10.19 (SCL)
I2C_SDA: U10.20 (SDA)

Notes on the sheet:
12 V boost (MT3608, GPIO26) and a switch that puts it on RESET (GPIO25). Both default off.
FB divider 100k/5.1k: 12.36 V nominal. The 1k series resistor drops about 0.25 V at the 250 uA RESET current,
so RESET sees 11.9-12.4 V (spec 11.5-12.5 V).
TCA6416A: VCCP on +5V (always up before +3V3, as TI recommends). ~RESET is pulled up to DUT_5V, so the
expander's ports are held as inputs (Hi-Z) whenever the DUT is off. I2C address 0x20.
HVPP map (16U2 table 25-9): P0 = PB0-7 data; P10 PD1 RDY/BSY, P11 PD2 OE, P12 PD3 WR, P13 PD4 BS1,
P14 PD5 XA0, P15 PD6 XA1, P16 PD7 PAGEL, P17 PC6 BS2.
