TomSawyerLabs/mcu-hil/hw/carrier/pi_io.kicad_sch

## KiCad design hw/carrier/pi_io.kicad_sch (2026-11-13)

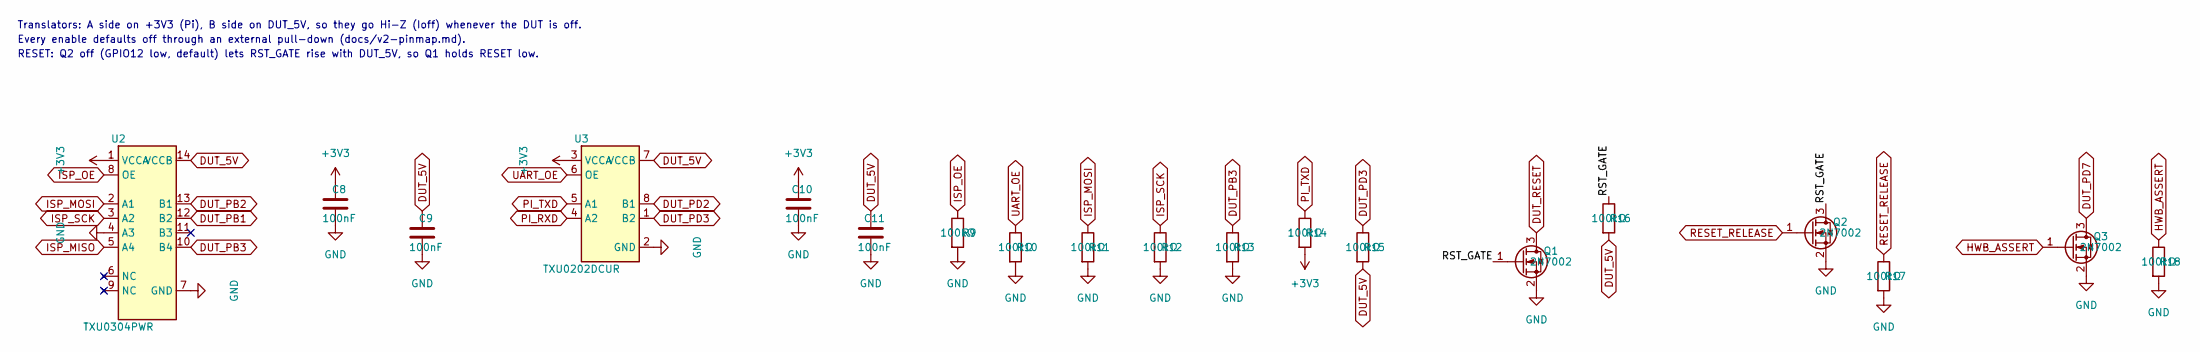
[picture p40: schematic pi_io.kicad_sch]

Parts:
C8, C9, C10, C11: 100nF; C_0402_1005Metric; LCSC C1525
Q1, Q2, Q3: 2N7002; SOT-23; LCSC C8545
R9, R10, R11, R12, R13, R14, R15, R16, R17, R18: 100kΩ; R_0402_1005Metric; LCSC C25741
U2: TXU0304PWR; LCSC C4364118
U3: TXU0202DCUR; LCSC C5186957

Connections:
+3V3: C8.1, C10.1, R14.2, U2.1 (VCCA), U3.3 (VCCA)
DUT_5V: C9.1, C11.1, R15.2, R16.2, U2.14 (VCCB), U3.7 (VCCB)
DUT_PB1: U2.12 (B2)
DUT_PB2: U2.13 (B1)
DUT_PB3: R13.1, U2.10 (B4)
DUT_PD2: U3.8 (B1)
DUT_PD3: R15.1, U3.1 (B2)
DUT_PD7: Q3.3 (D)
DUT_RESET: Q1.3 (D)
GND: C8.2, C9.2, C10.2, C11.2, Q1.2 (S), Q2.2 (S), Q3.2 (S), R9.2, R10.2, R11.2, R12.2, R13.2, R17.2, R18.2, U2.4 (A3), U2.7 (GND), U3.2 (GND)
HWB_ASSERT: Q3.1 (G), R18.1
ISP_MISO: U2.5 (A4)
ISP_MOSI: R11.1, U2.2 (A1)
ISP_OE: R9.1, U2.8 (OE)
ISP_SCK: R12.1, U2.3 (A2)
PI_RXD: U3.4 (A2)
PI_TXD: R14.1, U3.5 (A1)
RESET_RELEASE: Q2.1 (G), R17.1
RST_GATE: Q1.1 (G), Q2.3 (D), R16.1
UART_OE: R10.1, U3.6 (OE)

Notes on the sheet:
Translators: A side on +3V3 (Pi), B side on DUT_5V, so they go Hi-Z (Ioff) whenever the DUT is off.
Every enable defaults off through an external pull-down (docs/v2-pinmap.md).
RESET: Q2 off (GPIO12 low, default) lets RST_GATE rise with DUT_5V, so Q1 holds RESET low.
