TomSawyerLabs/mcu-hil/hw/carrier/usb.kicad_sch

## KiCad design hw/carrier/usb.kicad_sch (2026-11-13)

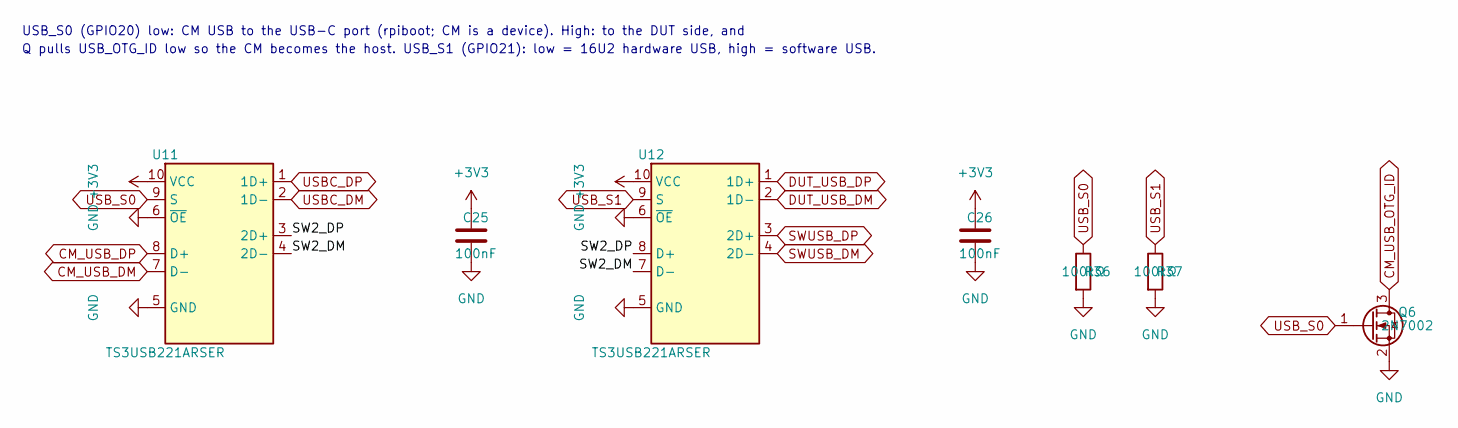
[picture p41: schematic usb.kicad_sch]

Parts:
C25, C26: 100nF; C_0402_1005Metric; LCSC C1525
Q6: 2N7002; SOT-23; LCSC C8545
R36, R37: 100kΩ; R_0402_1005Metric; LCSC C25741
U11, U12: TS3USB221ARSER; LCSC C128396

Connections:
+3V3: C25.1, C26.1, U11.10 (VCC), U12.10 (VCC)
CM_USB_DM: U11.7 (D-)
CM_USB_DP: U11.8 (D+)
CM_USB_OTG_ID: Q6.3 (D)
DUT_USB_DM: U12.2 (1D-)
DUT_USB_DP: U12.1 (1D+)
GND: C25.2, C26.2, Q6.2 (S), R36.2, R37.2, U11.5 (GND), U11.6 (~OE), U12.5 (GND), U12.6 (~OE)
SW2_DM: U11.4 (2D-), U12.7 (D-)
SW2_DP: U11.3 (2D+), U12.8 (D+)
SWUSB_DM: U12.4 (2D-)
SWUSB_DP: U12.3 (2D+)
USBC_DM: U11.2 (1D-)
USBC_DP: U11.1 (1D+)
USB_S0: Q6.1 (G), R36.1, U11.9 (S)
USB_S1: R37.1, U12.9 (S)

Notes on the sheet:
USB_S0 (GPIO20) low: CM USB to the USB-C port (rpiboot; CM is a device). High: to the DUT side, and
Q pulls USB_OTG_ID low so the CM becomes the host. USB_S1 (GPIO21): low = 16U2 hardware USB, high = software USB.
