TomSawyerLabs/mcu-hil/hw/hat/hat_io.kicad_sch

## KiCad design hw/hat/hat_io.kicad_sch (2026-11-13)

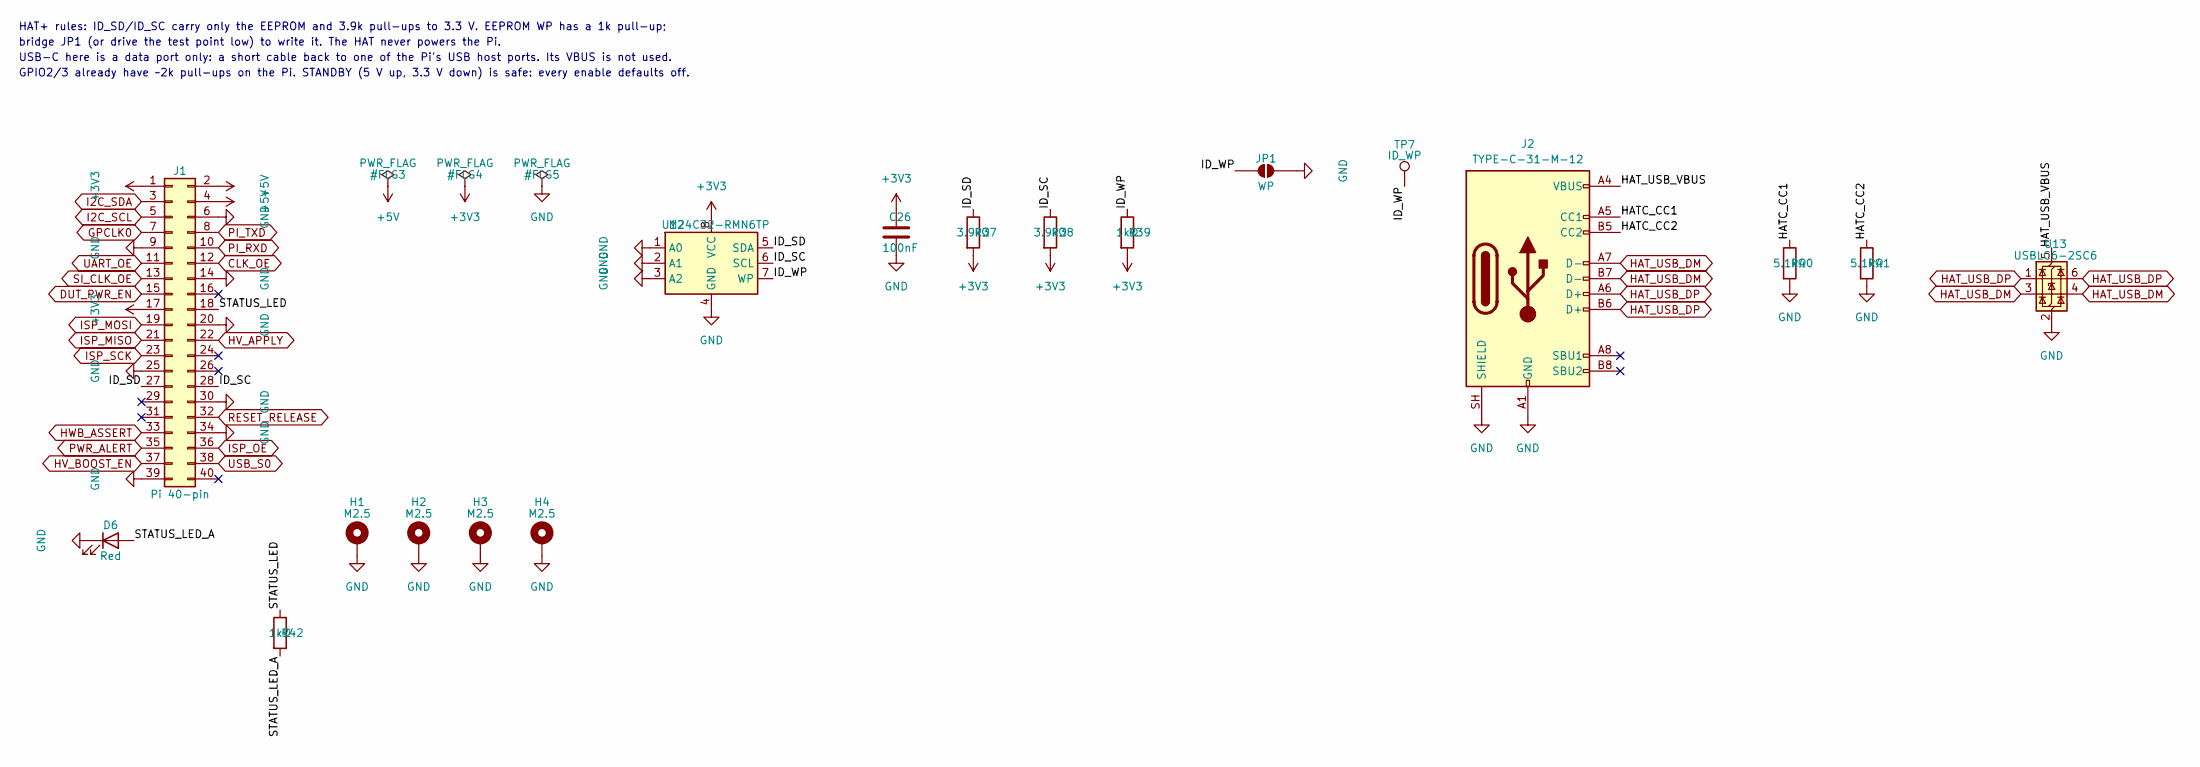
[picture p42: schematic hat_io.kicad_sch]

Parts:
C26: 100nF; C_0402_1005Metric; LCSC C1525
D6: Red; LED_0603_1608Metric; MPN KT-0603R; LCSC C2286
H1, H2, H3, H4: M2.5; MountingHole_2.7mm_M2.5_Pad
J1: Pi 40-pin; PinSocket_2x20_P2.54mm_Vertical; LCSC C5124634
J2: TYPE-C-31-M-12; USB_C_Receptacle_HRO_TYPE-C-31-M-12; LCSC C165948
JP1: WP; SolderJumper-2_P1.3mm_Open_RoundedPad1.0x1.5mm
R37, R38: 3.9kΩ; R_0402_1005Metric; LCSC C51721
R39, R42: 1kΩ; R_0402_1005Metric; LCSC C11702
R40, R41: 5.1kΩ; R_0402_1005Metric; LCSC C25905
TP7: ID_WP; TestPoint_Pad_D1.0mm
U12: M24C32-RMN6TP; SOIC-8_3.9x4.9mm_P1.27mm; LCSC C79920
U13: USBLC6-2SC6; LCSC C7519

Connections:
+3V3: C26.1, J1.1, J1.17, R37.2, R38.2, R39.2, U12.8 (VCC)
+5V: J1.2, J1.4
CLK_OE: J1.12
DUT_PWR_EN: J1.15
GND: C26.2, D6.1 (K), H1.1, H2.1, H3.1, H4.1, J1.6, J1.9, J1.14, J1.20, J1.25, J1.30, J1.34, J1.39, J2.A1 (GND), J2.A12 (GND), J2.B1 (GND), J2.B12 (GND), J2.SH (SHIELD), JP1.2 (B), R40.2, R41.2, U12.1 (A0), U12.2 (A1), U12.3 (A2), U12.4 (GND), U13.2 (GND)
GPCLK0: J1.7
HATC_CC1: J2.A5 (CC1), R40.1
HATC_CC2: J2.B5 (CC2), R41.1
HAT_USB_DM: J2.A7 (D-), J2.B7 (D-), U13.3 (I/O2), U13.4 (I/O2)
HAT_USB_DP: J2.A6 (D+), J2.B6 (D+), U13.1 (I/O1), U13.6 (I/O1)
HAT_USB_VBUS: J2.A4 (VBUS), J2.A9 (VBUS), J2.B4 (VBUS), J2.B9 (VBUS), U13.5 (VBUS)
HV_APPLY: J1.22
HV_BOOST_EN: J1.37
HWB_ASSERT: J1.33
I2C_SCL: J1.5
I2C_SDA: J1.3
ID_SC: J1.28, R38.1, U12.6 (SCL)
ID_SD: J1.27, R37.1, U12.5 (SDA)
ID_WP: JP1.1 (A), R39.1, TP7.1, U12.7 (WP)
ISP_MISO: J1.21
ISP_MOSI: J1.19
ISP_OE: J1.36
ISP_SCK: J1.23
PI_RXD: J1.10
PI_TXD: J1.8
PWR_ALERT: J1.35
RESET_RELEASE: J1.32
SI_CLK_OE: J1.13
STATUS_LED: J1.18, R42.1
STATUS_LED_A: D6.2 (A), R42.2
UART_OE: J1.11
USB_S0: J1.38

Notes on the sheet:
HAT+ rules: ID_SD/ID_SC carry only the EEPROM and 3.9k pull-ups to 3.3 V. EEPROM WP has a 1k pull-up;
bridge JP1 (or drive the test point low) to write it. The HAT never powers the Pi.
USB-C here is a data port only: a short cable back to one of the Pi's USB host ports. Its VBUS is not used.
GPIO2/3 already have ~2k pull-ups on the Pi. STANDBY (5 V up, 3.3 V down) is safe: every enable defaults off.
