TomSawyerLabs/mcu-hil/hw/hat/usb.kicad_sch

## KiCad design hw/hat/usb.kicad_sch (2026-11-13)

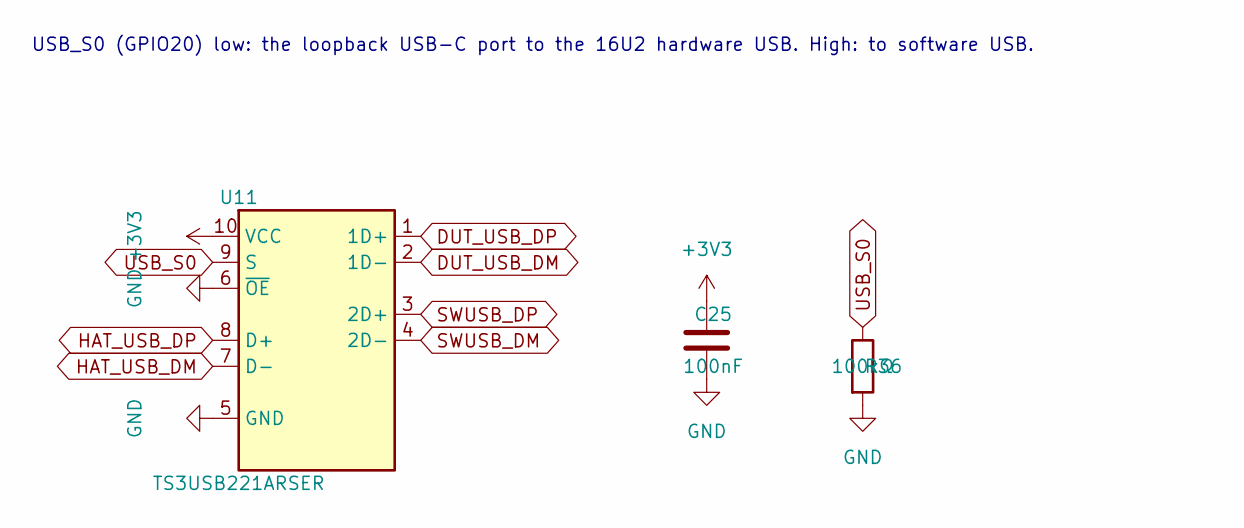
[picture p43: schematic usb.kicad_sch]

Parts:
C25: 100nF; C_0402_1005Metric; LCSC C1525
R36: 100kΩ; R_0402_1005Metric; LCSC C25741
U11: TS3USB221ARSER; LCSC C128396

Connections:
+3V3: C25.1, U11.10 (VCC)
DUT_USB_DM: U11.2 (1D-)
DUT_USB_DP: U11.1 (1D+)
GND: C25.2, R36.2, U11.5 (GND), U11.6 (~OE)
HAT_USB_DM: U11.7 (D-)
HAT_USB_DP: U11.8 (D+)
SWUSB_DM: U11.4 (2D-)
SWUSB_DP: U11.3 (2D+)
USB_S0: R36.1, U11.9 (S)

Notes on the sheet:
USB_S0 (GPIO20) low: the loopback USB-C port to the 16U2 hardware USB. High: to software USB.
