TomSawyerLabs/mcu-hil/(commit log)

2026-11-11 Review v1 design and draft v2 requirements
    Import the v1 Altium board into KiCad as reference data, recover the
    schematic intent and GPIO map from the SchDoc records, and cross-check
    every hole and via against the Altium source. Write up v1's blocks and
    problems, draft v2 requirements, and record open questions in the plan.
    [v1.kicad_pcb]
2026-11-11 Add v1 board/schematic renders and record v2 answers
    Render the v1 board and every Altium sheet to PNG straight from the
    files (matplotlib, no KiCad runtime). Correct the v1 review's level
    shifter and back-powering findings, note the shared J3/J4 holes and that
    the built board predates this revision, and fold the user's v2 answers
    into the plan and requirements.
2026-11-11 Record v2 architecture, power and repo decisions
    Complete boards per variant (no plug-in cards), CM-module-sized carrier,
    USB-C plus optional PoE with no secondary inputs, HAT USB-C as data-only
    loopback, software USB on MCU pins, and Altium files leaving master.
2026-11-11 Remove v1 Altium files from master
    They stay in history at tag v1 / branch v1-archive (linked from the README).
    v1's block diagram moves to docs/v1-images/.
    [AVR Test Hat.PcbDoc, AVR-Tester.PrjPcb, AVR.SchDoc, Clock Buffer.SchDoc, EEPROM.SchDoc, I2C-PullUps.SchDoc, Logic Buffer.SchDoc, Main.SchDoc]
2026-11-11 Record mcu-hil name, USB switch (no hub), no PoE; stage repo-move steps
2026-11-12 Draft v2 pin map; record that v1's USB-C footprints are unpopulated
    J6B is an alternate footprint for J7 (micro-USB), confirmed from the board file.
2026-11-12 Link v2 pin map from README
2026-11-12 Add optional high-voltage programming; explain SPI without CS
2026-11-12 Run DUTs at 3.3 V; 5 V only for HVPP; correct HVPP entry timing
    16U2 at 3.3 V: 8 MHz crystal, fig. 20-6 USB wiring. HVPP needs VCC 4.5-5.5 V,
    so the HV option adds a 3.3/5 V rail mux. HVPP entry has no tight window
    (that's ATtiny HVSP), so the load switch can be the TPS22918.
2026-11-12 Drop level translators for 4.7k series resistors; note HVPP needs 5 V
    ISP and UART go Pi -> 4.7k -> DUT, both at 3.3 V. The clock buffer stays.
    GPIO 16/17 become spares. Software keeps the Pi pins as inputs while the
    DUT is off. The 16U2 datasheet requires VCC 4.5-5.5 V for HVPP (§25.7.1,
    Table 26-9), so the plan asks whether to keep the 3.3/5 V mux.
2026-11-12 Note which AVR families need 5 V VCC for HV programming
2026-11-12 DUT at 5 V with level translators; clock override and HV optional
    Every classic AVR needs 5 V VCC for HV programming, so the DUT rail is a
    fixed 5 V behind the TPS22918 load switch. The 3.3/5 V mux is gone (GPIO 27
    spare). The 16U2 runs at 16 MHz (C13738, 12 pF load caps). TXU0304/TXU0202
    translators return, with enables on GPIO 16/17. The clock-override buffer
    is a population option, and the HV option depends on it.
2026-11-13 Plan: parts approved; start schematic (generated approach)
2026-11-13 First generated v2 schematics for the carrier and the HAT
    tools/schgen builds KiCad 10 schematics from one circuit description
    (design.py): shared sheets (DUT, Pi I/O, clock, DUT power, HV, USB) plus
    the CM4/CM5 carrier and Pi HAT top levels, with "no HV" and "minimal"
    design variants. Project symbols are generated from datasheet pin
    tables; three footprints come from JLC via easyeda2kicad.
    Parts changes found while drawing: INA228 is out of stock (INA226 fitted,
    1 ohm shunt), the 16U2 has no VBUS pin (SY6280 dropped), no LDO (Pi/CM
    3.3 V), 75R for software USB, and a second TPS22918 for SD power.
    [carrier_io.kicad_sch, clock.kicad_sch, cm.kicad_sch, dut.kicad_sch, dut_power.kicad_sch, hat_io.kicad_sch, hv.kicad_sch, mcu-hil-carrier.kicad_sch]
2026-11-14 Schematic ERC clean: own TPS22918 symbol, one power-output pin per CM rail
    kicad-cli 10.0.6 ERC: 0 errors, 0 warnings on both boards. KiCad's exported netlists match the generator's nets.
    [carrier_io.kicad_sch, cm.kicad_sch, dut_power.kicad_sch]
2026-11-14 Ignore KiCad per-user files (.kicad_prl, backups, caches)
2026-11-14 Add schematic PDFs; plan: ERC clean, waiting on schematic review
